albertjihyun/Busan-IDEC/docs/design-overview.md

# 설계 개요 (제출용 초안)

> 팀 문서. 설계결과물 설명서의 2번 항목에 해당한다. 2.4 시스템 구성은 하드웨어 담당이 채운다.

## 2.1 설계 배경

### 2.1.1 화물차 졸음운전은 오래된 문제다

졸음은 도로 위 최대 사망 원인이다. 한국도로공사 통계에 따르면 2019~2023년 고속도로 교통사고 사망자의 71%가 졸음·주시태만에 기인하며, 2026년 상반기 관련 사망자는 전년 대비 90% 증가하였다[1]. 미국 GHSA의 2025년 분석은 졸음운전 관련 실제 사망자가 공식 통계의 약 10배로 추정된다고 보고하였는데[2], 피로는 음주·약물과 달리 사후 검사로 확인되지 않기 때문이다. 사후 규명이 불가능한 위험에 대한 대응은 실시간 감지뿐이다.

이 위험이 집중되는 집단은 화물차 운전자다. 화물차의 졸음·주시태만 사망자는 전체 고속도로 사망자의 82%에 이르며[3], 화물차 사망사고는 100km 이상 장거리 운행 중(65%)과 심야 시간대(43%)에 집중된다[4]. 운행 실태가 이를 설명한다. 화물차 운전자의 일평균 근로시간은 12.8시간이고[5], 설문 응답자의 54.5%가 하루 12시간 이상 운전하며[6], 법정 최소 휴게시간 미준수율은 52.3%에 달한다[7]. 국내에는 운전시간 총량과 일일 최소 휴식을 강제하는 제도가 없으며, 연속운전 2시간 후 15분 휴게가 유일한 시간 규제다[7]. 여기에 운전자 평균 연령 56.4세, 50대 이상 62.2%라는 고령화와 신규 유입 정체[8], 15년 이상 노후 차량 75만 대라는 차량 고령화가 겹친다[9]. 졸음이 발생하는 조건이 이 집단의 일상이며, 제도는 그것을 막지 못한다.

### 2.1.2 자율주행이 화물 운송에 들어왔다

장거리 화물운송 구간의 98%는 고속도로로[10], 반복 노선과 정속 주행이라는 특성상 자율주행 기술이 가장 먼저 적용되는 영역이다. 해외에서는 무인 화물운송이 상용화 단계에 진입하였고[11], 국내에서도 2026년 트레일러 자율주행 유상운송이 개시되었으며 장거리 트럭 운전자를 대상으로 한 구독형 레벨 2 주행보조 서비스가 출시되었다[12][13]. 정부는 2027년 레벨 4 상용화 로드맵을 가동 중이다[14]. 운전자 부족과 고령화가 심화되는 상황에서 업계와 연구자들은 자율주행을 대안으로 거론한다[11].

### 2.1.3 그러나 해결이 아니라 악화다

레벨 3는 보험·책임·개입 기준 제도가 미비하여, 완전 무인화 목표 시점(2028)까지 상당 기간 운전자가 감독 의무를 지는 레벨 2로 보급된다[13]. 노후 차량 비중이 높아 신차 교체보다 기존 차량 후장착이 현실적 경로이므로[9], 오늘의 운전자가 오늘의 트럭에서 레벨 2와 함께 운전하는 기간이 길게 이어진다.

이 구간이 위험하다는 점을 실주행 연구가 시사한다. IIHS와 MIT AgeLab의 관찰 연구는 부분 자율주행 사용 중 운전자의 비운전 행동이 유의미하게 증가함을 확인하였고[15], 2026년 3월 NHTSA가 약 320만 대를 대상으로 격상한 조사에서는 시스템이 충돌 직전에야 제어권을 반환한 사례들이 드러났다[16]. 차가 대신 달릴수록 운전자는 감독자에서 승객이 되며, 제어권 반환 순간의 각성 여부가 사고를 가른다. 원래 가장 졸음에 취약했던 집단이 감독만 하는 자리에 앉게 되는 것이다.

동시에 기존 감시 방식의 한 축이 무력화된다. 조향 패턴 기반 졸음 감지는 EU 규정이 허용하는 간접 수단이나[17], 자율주행 보조 중에는 운전자가 조향을 하지 않아 원리적으로 작동하지 않는다. 자율주행은 졸음을 해소한 것이 아니라, 졸음을 유발하는 조건을 더하면서 감시 수단 하나를 제거하였다.

### 2.1.4 규제는 감시를 요구한다

유럽연합은 일반안전규정(GSR)에 따라 졸음·주의력 경고 시스템(DDAW)을 2024년 7월부터, 첨단 주의분산 경고 시스템(ADDW)을 2026년 7월부터 승용차·트럭·버스를 포함한 모든 신규 판매 차량에 의무화하였다[18]. 이는 차량 통합형 시스템에 대한 형식승인 요건이므로 본 설계와 같은 착용형 장치가 직접 충족하는 대상은 아니나, 규제 당국이 운전자 상태 감시의 필요성을 법으로 확인하였다는 근거다. 국내 정부도 2017년 '사업용 차량 졸음운전 방지대책'을 통해 첨단안전장치 장착 확대를 추진하였고[19], 대형 화물차에 차로이탈경고·비상자동제동 장치를 의무화하였다[20]. 그러나 운전자 상태 감시에 대한 국내 법적 요구는 아직 없다.

### 2.1.5 기존 방식의 빈틈과 생체신호

자율주행 중에도 작동하는 기존 방식은 카메라 기반 DMS이며, 화물차 시장에는 후장착 카메라 제품이 존재한다. 그러나 카메라는 눈꺼풀·시선을 직접 관찰하므로 선글라스, 야간, 역광 조건에서 취약하며, 2026년 7월 시속 100km 주행 중 운전자 수면 사례에서 선글라스로 인해 감지에 실패한 것이 보고되었다[21]. 화물차 사고가 심야에 집중된다는 점(2.1.1)을 고려하면 이 취약성은 타깃 환경과 정면으로 충돌한다. 또한 카메라 방식은 졸음이 눈꺼풀 처짐 등 행동으로 발현된 이후에야 검출한다.

반면 졸음은 자율신경계 변화를 동반하며, 자율신경 활동이 심박변이도(HRV)에 반영된다는 것은 국제 표준 문서로 확립되어 있다[33]. 다만 졸음 상태에서 개별 HRV 지표가 어느 방향으로 변하는지는 연구마다 다르다. 운전 피로 연구 18편을 종합한 문헌고찰은 심박 감소만 일관되게 보고되고 나머지 지표는 증가와 감소가 모두 보고된다고 정리하였으며, 그 원인으로 피로의 종류(졸음의 진행 대 각성 유지 노력)와 기준 측정의 차이를 지목하였다[34]. PPG로 취득한 HRV 특징을 이용한 졸음 감지는 실주행 데이터로 시도되었고[22], 학습 기반 분류기가 단일 임계값 규칙보다 낫다는 보고가 있으나[23], 피험자 4명의 표본 단위 교차검증이라 피험자 독립 평가는 아니었다. 본 설계는 피험자 독립 평가로 이를 재확인한다. 생체신호는 조명·착용물·조향 여부와 무관하며, 행동으로 나타나기 전의 각성도 저하를 관찰 대상으로 한다. 본 설계는 카메라 DMS를 대체하는 것이 아니라, 카메라가 놓치는 조건(야간·선글라스)과 시점(행동 발현 전)을 보완하는 생체신호 채널을 목표로 한다.

## 2.2 설계 목적, 타깃, 범위

**목적.** PPG 생체신호로 졸음에 수반되는 각성도 저하를 감지하고, 센싱 이후의 신호 처리·품질 검증·특징 추출·추론 경로 전체를 범용 프로세서 없이 전용 하드웨어 데이터패스로 구현한 온디바이스 졸음 감지 SoC를 설계·검증한다.

**타깃.** 장거리 사업용 운전 종사자를 관리하는 기업·플랫폼을 대상으로 한다.

- **장거리 간선 화물.** 사고 통계가 가장 크고(2.1.1), 고속도로 연속 주행이라는 운행 조건이 생체신호 측정에 가장 유리하며, 레벨 2 주행보조가 먼저 적용되는 환경이다(2.1.2). 보급 채널은 운수사·화주 직영 차량에 대한 기업 단위 도입과, 지입 개인 차주에 대한 정부 보조다. 사업용 차량 안전장치는 정부 보조와 기관 단위 도입이 표준 경로로, 차로이탈경고장치 설치비 80% 지원[24]과 페달오조작 방지장치 보급[25] 선례가 있다.
판정은 운행 시작 직후의 심박을 개인 기준선으로 삼으므로 **출발 시점에 깨어 있는 운전**을 전제한다. 교대 근무 직후처럼 출발부터 졸린 상태면(야간 근무 뒤 장거리 통근 운전자의 19%[26], 교대 근무 트럭 운전자 첫 야간의 37.8%가 KSS 7 이상[27]) 기준선이 졸음 상태로 잡혀 감지하지 못하며, 이는 방식의 구조적 한계로 명시한다. 새벽배송은 사회적 필요는 크지만 야간 출발이 기본이고 도심 구간의 정차·하차·운반으로 신호 조건도 맞지 않아 대상에서 제외하였다.

기관 단위 대량 보급을 전제하므로 초저전력·저단가·상시 독립 동작이 선호 사항이 아닌 도입 조건이 되며, 이것이 본 설계의 요구사항을 규정한다.

**범위.** 구현 범위는 FPGA(Artix-7) 상의 기능·성능 검증까지이며, 회로 및 모델 구조는 ASIC 수준의 자원 제약(곱셈기·온칩 메모리 최소화)을 설계 기준으로 삼아 향후 이식 가능한 형태를 지향한다. 아날로그 프론트엔드, ADC, IMU, 무선 통신 모듈, 배터리 구동부를 포함한 착용형 보드를 자체 설계하였으며, 학습은 오프라인에서 수행하고 칩에는 추론 경로만 탑재한다. 측정 위치는 손목 대비 말초 혈관 수축과 팔 움직임의 영향이 적은 이마로 선정하고 헤어밴드 형태로 설계하였다. PCB 제작과 착용 실측은 본 제출 범위 밖이다. 장시간 착용성은 후속 과제이며, 모자·헬멧 내장 형태로의 확장을 전제한다.

## 2.3 설계 기준과 후보 비교

### 2.3.1 설계 기준 도출

2.1의 문제 정의와 2.2의 타깃 설정으로부터 다음 여섯 가지 요구사항을 도출하였다. 각 기준은 배경 절의 특정 발견에 대응한다.

| 기준 | 내용 | 도출 근거 |
|---|---|---|
| ① | 조명·착용물(선글라스)에 무관하게 작동 | 화물차 사고의 심야 집중(2.1.1), 카메라의 야간·선글라스 취약성(2.1.5) |
| ② | 자율주행 보조 중에도 작동 | 조향 기반 감시의 무력화(2.1.3), 레벨 2 후장착 보급 경로(2.1.3) |
| ③ | 행동으로 나타나기 전 각성도 저하의 감지 가능성 | 제어권 반환은 수 초 단위이며 충돌 직전 경고 사례(2.1.3) |
| ④ | 상시 구동 가능한 초저전력 | 기관 단위 대량 보급 시 충전 관리 부담(2.2) |
| ⑤ | 외부 통신 없이 독립 동작 | 장거리 노선의 통신 음영, 안전 기능의 외부 의존 불가(2.2) |
| ⑥ | 낮은 단가 | 정부 보조·기관 단위 보급 조건(2.2) |

### 2.3.2 후보 비교

**결정 1 — 감지 수단**

| 후보 | ① 조명 | ② 자율주행 중 | ③ 전조 | ④ 저전력 | ⑤ 독립 | ⑥ 단가 | 판정 |
|---|---|---|---|---|---|---|---|
| 카메라 | ✗ | ○ | ✗ (행동 발현 후) | △ | ○ | △ | ① 탈락 |
| 조향 패턴 | ○ | ✗ | ✗ (행동 발현 후) | ○ | ○ | ○ | ② 원리적 탈락 |
| EEG | ○ | ○ | ○ | ✗ | ○ | ✗ | ④⑥ 탈락 |
| ECG | ○ | ○ | ○ | ○ | ○ | △ | 전극 부착, 실용성 불리 |
| **PPG** | ○ | ○ | ○ | ○ | ○ | ○ | **채택** — 약점: 접촉 품질 |

**결정 2 — 판단 방식**

| 후보 | 판별력 | 하드웨어 비용 | 데이터 요구 | 판정 |
|---|---|---|---|---|
| 규칙 기반 단일 임계값 (원시 심박 특징에 고정 문턱) | 사람마다 평소 심박 간격이 최대 1.8배 달라 공통 문턱이 서지 않음[34]. 개인 기준선으로 나눈 비율에는 문턱이 유효하며, 그것이 아래 경량 ML의 최종 형태 | 최소 | 없음 | 원시 특징 문턱은 탈락 |
| **경량 ML (결정트리·선형 모델)** | 개인차를 개인 기준선 정규화와 학습으로 흡수. 선행 연구 정확도는 44~100%로 편차가 크고 피험자 독립 평가에서 낮아지므로[34] 본 설계는 50명 피험자 독립 평가로 검증. 결과: 기준선 대비 평균 RR 비율 하나에 문턱 하나를 두는 로지스틱 회귀가 최선이었고, 특징을 늘리거나 트리 앙상블(45 KB)로 키우면 새 피험자에서 오히려 낮아졌다 | 판정마다 곱셈 2회·비교 1회, 나눗셈 없음, 파라미터 1개(11비트) | 공개 데이터셋으로 충족 | **채택** |
| 딥러닝 (CNN/LSTM) | 상한 높음 | 곱셈기·온칩 메모리 예산 초과 → ④ 충돌 | 대규모, 공개 데이터 부족 | ④ 탈락 |

**결정 3 — 실행 플랫폼**

| 후보 | ④ 전력 | ⑤ 독립 | ⑥ 단가 | 지연 특성 | 판정 |
|---|---|---|---|---|---|
| 스마트폰·클라우드 연동 | △ | ✗ | ○ | 비결정적 | ⑤ 탈락 |
| 범용 MCU 소프트웨어 | △ | ○ | △ | 비결정적 | 유일한 실질 경쟁자 — 비교 대상 |
| **전용 하드웨어 데이터패스** | ○ | ○ | ○ (양산 시) | 결정적 | **채택** |

### 2.3.3 결정에 따른 트레이드오프와 보완

**PPG 채택의 대가 — 접촉 품질과 모션 노이즈.** 카메라와 달리 신체 접촉이 필요하고, 움직임에 취약하며, HRV는 개인차가 있다[34].
- 측정 위치를 손목이 아닌 이마로 선정: 말초 혈관 수축과 팔 움직임(조향)의 영향이 적다. 반사형 이마 측정은 DC 광전류가 커지므로 TIA를 상방 스윙 구조(캐소드→반전입력, 기준 1V)로 설계하여 약 7µA까지의 선형 구간을 확보하였다.
- 신호 품질 검증(SQI) 단계를 데이터패스에 내장: 진폭 범위와 RR 간격의 생리학적 타당성을 검사하여 불량 구간은 판단을 보류한다.
- IMU를 병행: 고개 떨굼은 심박과 무관하게 즉시 경보한다. 자이로로 꾸벅(빠른 하강·복귀, 25° 이상)을, 가속도 중력 투영으로 숙인 채 있는 자세(35° 이상 0.5초, 세로축 조건으로 급제동과 구별)를 각각 잡아 합친다[28][29][30]. 머리 움직임이 큰 구간은 SQI의 모션 게이트가 박동 단위로 걸러낸다(IMU 별도 보류는 PPG-DaLiA 15명 분석에서 이득이 작아 두지 않음).
- 개인차 보정: 좋은 1분 창 3개로 개인 기준선을 만들고, 기준선 대비 평균 RR 비율(`mean_rb`) 하나로 판정한다. 문헌고찰이 개인화를 정확도의 핵심 요소로 지목하였다[34].
- 노이즈를 완전히 제거한다고 주장하지 않는다. 대역 제한 필터, SQI, 잔여 변동에 대한 모델 강건성 검증의 3단으로 대응하며, 판단 보류에 따른 커버리지를 성능과 함께 보고한다.
- 착용성(장시간 헤어밴드)은 후속 과제로 남기고, 모자·헬멧 내장 형태로의 확장을 전제한다.

**경량 ML 채택의 대가 — 정확도 상한.** 딥러닝 대비 표현력이 제한된다.
- HRV 특징 설계로 보완: 국제 표준[33]에 정의된 시간영역 지표 전체를 후보로 두고, 30초 창에서 계산이 성립하는지, ECG와 PPG 양쪽에 존재하는지, 240 SPS 시간 분해능에서 오차가 허용 범위인지[35][36]의 세 조건으로 걸러 후보를 확정한 뒤, 최종 선택은 데이터로 한다. 표준 문서와 샘플링 연구가 통계적 성질을 이유로 비권장한 pNN50은 제외한다[33][35]. 선행 연구가 개별 지표의 변화 방향에 합의하지 못했으므로[34] 특정 지표를 미리 선택하지 않는다.
- 하드웨어 예산(트리 노드 수·곱셈기 수)을 학습 단계의 제약조건으로 처음부터 걸어, 학습 후 하드웨어에 맞추는 것이 아니라 하드웨어에 맞는 모델을 학습한다.
- 학습 데이터가 ECG 기반이라는 간극은 흉골 ECG와 이마 PPG를 동시 기록한 데이터셋(WildPPG[37], 15명)으로 검증하였다. 같은 사람, 같은 시각의 60초 창 `mean_rb`를 두 신호에서 따로 내어 비교한 결과, 창 품질 규칙(박동의 75% 이상을 살린 창만 판정)과 기준선 규칙(좋은 1분 창 3개로 기준선 구성)을 넣으면 차이 중앙값 −0.1%, 표준편차 1.7%, 판정 일치 97.4%였다. 표준편차 1.7%는 각성 중 사람 안 흔들림 4.0%보다 작다. 운전 중 움직임이 신호 품질에 주는 영향은 손목 PPG와 가슴 ECG를 운전 중 동시 기록한 데이터셋[32]으로 확인하였다.

**전용 하드웨어 채택의 대가 — 유연성 상실과 개발 난이도.** 알고리즘 수정이 소프트웨어만큼 자유롭지 않고, 구현 단계가 늘어난다.
- FPGA 단계에서 알고리즘을 충분히 검증한 뒤 고정하는 표준 개발 순서를 따른다.
- 학습은 오프라인에서 수행하고 칩에는 추론 경로만 탑재하여, 칩의 로직을 단순하게 유지한다.
- "왜 전용 하드웨어인가"는 주장이 아니라 동일 모델의 MCU 구현 대비 판단 1회당 에너지·지연시간 비교로 답한다. 본 제출에서는 FPGA 합성 리포트의 전력·지연 추정치와 MCU 데이터시트 기반 계산으로 비교하고, 실측은 후속 과제다.
- 무선 통신은 BLE 스택 전용 펌웨어가 고정된 SMD 모듈을 채택하여, 범용 프로세서를 두지 않으면서 물리 계층 변환만 위임한다.

**저전력 동작 구조.** ④를 위해 판정을 칩 안에서 끝내고 밖으로는 결과만 내보낸다. 광원·센서·심박 검출은 상시, 특징 추출과 추론은 5초 주기로 동작하며, 무선으로는 경보가 날 때만 1바이트를 보낸다. 졸림 판정이 이어지는 동안에는 30초마다 다시 보낸다. 판정 하나가 최근 60초를 보므로 5초마다 연달아 나온 판정은 대부분 같은 데이터이고, 규정은 첫 경고를 가능한 한 빨리 내고 운전자가 확인할 때까지 반복·강화할 수 있게 한다[38]. 반복이 잦으면 경고에 둔감해지므로[39] 첫 경고는 늦추지 않되 반복 간격을 창의 절반인 30초로 둔다. 파형을 스마트폰으로 계속 보내 폰에서 판단하는 구조와 비교하면 무선 송신량이 경보 한 번에 1바이트로 줄고, 판단을 맡는 회로는 곱셈기 3개 규모의 고정 로직이다. 무선 모듈은 상시 연결 상태로 두며, 이 상태의 모듈 전류는 약 1 mA로 광원(정격 약 5.6 mA)보다 작다. 모듈을 경보 때만 깨우는 방식은 연결 상태 확인 신호가 필요해 후속 과제로 둔다.

## 2.4 시스템 구성 개요

*(하드웨어 담당 작성. 제출 전 이 안내와 아래 항목 표시는 삭제. 분량 반~한 페이지, 상세 회로는 3번 항목으로.)*

**[블록 다이어그램]** — 회로도가 아닌 블록 수준 그림. 센서 → AFE → ADC → FPGA 내부(FIR → SQI → 피크/RR → 60초 창 합 → 기준선·판정 → 자세·끄덕임 결합) → UART → BLE → 스마트폰. IMU는 I2C로 FPGA에 병렬 입력.

```
PPG 센서 → AFE → ADC ─┐ I2C
IMU ──────────────────┘
        ↓
[FPGA] FIR → SQI → 피크/RR → 60초 창 합 → 기준선·판정 ─┐
       IMU 자세·끄덕임 ───────────────────────────────┴→ 경보 결합 → UART
        ↓
BLE 모듈(경보 시 1바이트) → 스마트폰
```

**[블록별 한 줄 설명]**
- 광학부 (LED + 포토다이오드):
- 아날로그 프론트엔드 (TIA + 2단 증폭 + 필터):
- ADC:
- IMU:
- FPGA 데이터패스:
- BLE 모듈:
- 전원부:

**[주요 부품 및 사양]**
- 포토다이오드 / LED: TEMD6200FX01(녹색 대역) / KT-0805G 녹색, 정격 약 5.6 mA(Vf 빈에 따라 2.27–8.93 mA, 3.3 V, 직렬 75 Ω)
- 증폭기: OPA2333 (TIA 330k + 이득 21, AC 결합 0.16Hz, 출력 LPF 16Hz, 기준 1V)
- ADC: MCP3421A0, 12비트 / 240 SPS, I2C 0x68. 240 SPS(4.17 ms)는 PPG 기반 HRV 지표에서 오차 1% 미만으로 보고된 범위다[36]
- IMU: ICM-42670-P, I2C 0x69
- BLE: JDY-23, UART 9600 8N1 투명 전송, 공장 기본 설정 사용. PWRC는 풀업으로 High 고정(기본 모드에서 상시 깨어 있음)
- FPGA: Cmod A7-35T (Artix-7), 12 MHz 온보드 클럭
- 배터리·충전·LDO: USB-C(CC 5.1k) → TP4054 100mA → 보호 내장 리튬셀 → ME6211 3.3V

**[인터페이스]**
- I2C 버스 (ADC·IMU 공유, 풀업 4.7k):
- UART (FPGA ↔ BLE):
- 제어선: LED_IN(LED 스위칭), IMU_INT, BLE_WAKE. (BLE 모듈의 STAT·TXD는 미연결. FPGA→BLE 단방향)

**[전원 구조]**
- USB-C 충전 → 배터리 → LDO 3.3V → 보드 전체
- 프로토타입 단계에서 FPGA 모듈은 별도 USB 전원(헤더에 전원 핀 없음, Cmod Pmod VCC와의 충돌 회피). 최종 IC 전원 인터페이스는 본 범위 밖
- 측정 중 LED(정격 약 5.6 mA)는 상시 점등. 델타시그마 ADC가 변환 시간 내내 적분하므로 LED 듀티 제어와 주변광 차감은 이 구성에서 불가능하다. "저전력"은 판정을 칩 안에서 끝내 무선 송신을 경보당 1바이트로 줄이는 구조(2.3 저전력 동작 구조)에 대한 것이며 광원 전력은 고정 부분이다

## 2.5 차별점, 검증, 기대 효과

**차별점.** (1) 조명·착용물·조향 여부와 무관한 생체신호 채널, (2) 행동으로 나타나기 전의 각성도 저하를 관찰 대상으로 하고 실제로 깊어진 구간을 별도 추적하여 조기 감지 가능성을 검증, (3) 센싱 이후 전 경로의 CPU-free 하드웨어 데이터패스, (4) 하드웨어 예산을 학습 제약조건으로 반영한 모델 설계, (5) 칩 안에서 판정을 끝내 무선 송신을 경보당 1바이트로 줄이는 구조.

**검증 방법.** 검증은 세 층으로 나눈다.

*완료한 것.* 아날로그 프론트엔드 회로 설계와 PCB 아트웍, 손가락 부위 브레드보드 측정(82 bpm, 358 mVpp, dicrotic notch 확인). 이때 사용한 포토다이오드는 940 nm 피크 소자로 520 nm 광원에 대한 상대 감도가 약 44%였으므로 실제 설계(녹색 대역 매칭 소자) 대비 감도가 낮은 조건에서의 검증이다.

*본 제출까지 데이터와 시뮬레이션으로 수행하는 것.* 졸음 라벨이 부여된 공개 운전 시뮬레이션 데이터셋(MPD-DF[31], 50명, 의사 판정 30초 단위 라벨)으로 학습하고 피험자 단위 분할(leave-one-subject-out)로 평가한다. 이 데이터의 각성도 저하 구간은 445건, 지속 시간 중앙값 90초다. 판정은 60초 창을 5초마다 갱신하고, 채점은 라벨 단위인 30초마다 한다. 놓침 방지를 우선하므로 주 지표는 구간 단위 민감도이고 시간당 헛경보를 짝으로 보고한다. 정확도는 각성 비율(77%)이 높아 단독으로 쓰지 않는다. 라벨 중 실제로 더 깊은 단계로 진행한 구간을 별도 추적하여 조기 감지 가능성을 검증한다. 학습 데이터가 ECG라는 간극은 흉골 ECG와 이마 PPG를 동시 기록한 데이터셋(WildPPG[37])으로 두 신호의 `mean_rb`를 비교해 확인하고(판정 일치 97.4%), 운전 중 움직임에 따른 신호 품질은 손목 PPG와 가슴 ECG를 동시 기록한 데이터셋(PPG-DaLiA[32])으로 확인하였다. 하드웨어는 판정 블록 RTL이 50명 전체의 5초 블록 입력에서 파이썬 정수 기준 모델과 비트 단위로 일치함을 확인하고(신호처리 블록은 실제 PPG 파형을 재생해 골든 모델과 대조), FPGA 합성·구현 리포트의 자원·타이밍·전력 추정치를 제시한다. "왜 전용 하드웨어인가"는 이 추정치와 동일 모델의 MCU 구현에 대한 데이터시트 기반 계산으로 판단 1회당 에너지와 지연을 비교하여 답한다.

*수행하지 못한 것.* PCB 제작과 이마 부위 실측, 실제 보드 데이터와의 대조, MCU 대비 실측, IMU 규칙의 착용 검증은 본 제출 범위 밖이며 후속 과제로 남긴다. 이마 PPG 비교 데이터(WildPPG)는 운전이 아니라 야외 활동 기록이라, 운전 중 이마에서 판정이 얼마나 남는지는 확인되지 않았다(두 규칙에서 남는 판정 창은 WildPPG 이마 약 38%, PPG-DaLiA 손목 운전 26%). 학습 데이터가 시뮬레이터 주행이라 실도로 조건(졸음에 저항하는 각성 유지 노력)에서의 일반화는 확인되지 않았다[34].

**기대 효과.** 자율주행 보조 중 조향 기반 감시가 무력화되고 카메라 방식이 야간 조건에 취약한 공백을 생체신호 채널로 보완한다. 현재 범위에서는 운전자와 관제 측에 경보를 제공하며, 향후 차량 시스템과 연동 시 제어권 반환 전 운전자 각성 확인 수단으로 확장 가능하다. 야간·장거리 사업용 운전자 대상 저단가 상시 감시 장치의 기관 단위 보급 가능성을 제시한다.

---

## 참고문헌

[1] 조선비즈, "고속도로 교통사고 사망 70% 졸음 탓", 2026.6. https://v.daum.net/v/20260618102616783
[2] GHSA, "Drowsy Driving", 2025. https://www.ghsa.org/state-laws-issues/drowsy-driving
[3] 부산일보, "한국도로공사, AI·빅데이터로 지킨 안전…고속도로 사망자 역대 최저", 2026.3. https://www.busan.com/view/busan/view.php?code=2026033016342758526
[4] 문화일보, "1월 고속도로 운전 시 화물차 사고, 심야시간대 교통사고 각별한 주의 당부", 2026.1. https://www.munhwa.com/article/11558945
[5] 한국교통연구원, 2019 하반기 화물운송시장 동향 (월간노동법률 인용). https://www.worklaw.co.kr/main2022/view/view.asp?bi_pidx=32404
[6] 시사IN, "요일도 밤낮도 없는 화물차 기사의 24시간 365일 노동 [DTG 데이터 탐사보도②]", 2022.11. https://www.sisain.co.kr/news/articleView.html?idxno=48966
[7] 대한교통학회지, "우리나라 사업용 화물차 운전자의 최소 휴게시간 준수와 위험운전행동", 2026. https://www.jkst.or.kr/articles/pdf/BqBe/kst-2026-044-02-10.pdf
[8] 상용차신문, "화물운송시장 '청년' 운전자가 안보인다…신규 진입자 평균 48세", 2026.2. https://www.cvinfo.com/news/articleView.html?idxno=30631
[9] 상용차매거진, "화물운송시장 '이중 고령화' 운전자도 늙고 차량도 늙는다", 2026.8. https://www.cvinfo.com/news/articleView.html?idxno=31576
[10] 베타뉴스, "마스오토, 국내 트레일러 자율주행 시작", 2026.7. https://www.betanews.net/article/view/beta202607010036
[11] 이데일리, "트럭운전자 고령화·구인난 해법…초기투자 지원·제도정비 서둘러야", 2026.7. https://edaily.co.kr/News/Read?mediaCodeNo=257&newsId=01820406645519768
[12] 이데일리, "마스오토, 국내 최초 트레일러 자율주행…2028년 한·미 화물운송 완전 무인화", 2026.7. https://edaily.co.kr/News/Read?mediaCodeNo=257&newsId=04027846645510256
[13] 아시아투데이, "박일수 마스오토 대표 '2028년 장거리 화물운송 완전 무인화 달성'", 2026.7. https://www.asiatoday.co.kr/kn/view.php?key=20260701010000579 / 테크42 동일 간담회 보도(레벨2 출시 이유). https://www.tech42.co.kr/
[14] 정책브리핑, "2027년 레벨4 완전자율주행 상용화…AI 모빌리티 혁신 로드맵 가동", 2026.3. https://www.korea.kr/news/policyNewsView.do?newsId=148960802
[15] IIHS·MIT AgeLab 연구 보도, 2024.9. https://www.malaymail.com/news/tech-gadgets/2024/09/18/the-automation-dilemma-are-drivers-checking-phones-while-on-autopilot/150792
[16] Electrek, "NHTSA upgrades Tesla FSD investigation to engineering analysis (3.2M vehicles)", 2026.3. https://electrek.co/2026/03/19/nhtsa-upgrades-tesla-fsd-visibility-investigation-3-2-million-vehicles/
[17] InterRegs, "EU regulation on driver drowsiness and attention warning systems". https://www.interregs.com/articles/spotlight/233/eu-regulation-on-driver-drowsiness-and-attention-warning-systems-published
[18] Smart Eye, "What to know about DDAW and ADDW systems". https://smarteye.se/blog/what-to-know-about-ddaw-and-addw-systems/
[19] 로컬세계, "국토부, 사업용 차량 졸음운전 방지대책", 2017.7. https://localsegye.co.kr/news/view/1065592300623588
[20] 해사신문, "국토부, 대형 화물차 첨단안전장치 장착 의무화", 2016.4. http://www.haesanews.com/news/articleView.html?idxno=73724
[21] Electrek, "Tesla driver asleep at 100 km/h exposes monitoring gap", 2026.7. https://electrek.co/2026/07/06/tesla-driver-asleep-monitoring-gap/
[22] Z. AlArnaout, C. Zaki, Y. Kotb, M. AlAkkoumi, N. Mostafa, "Exploiting heart rate variability for driver drowsiness detection using wearable sensors and machine learning", Scientific Reports 15, 2025. https://www.nature.com/articles/s41598-025-08582-2
[23] G. Li, W.-Y. Chung, "Detection of driver drowsiness using wavelet analysis of heart rate variability and a support vector machine classifier", Sensors 13(12):16494-16511, 2013. https://pmc.ncbi.nlm.nih.gov/articles/PMC3892817/
[24] 서울시, "졸음운전 예방 차로이탈경고장치 설치비 80% 지원", 2020.3. https://news.seoul.go.kr/traffic/archives/503010
[25] 정책브리핑, "페달 오조작 방지장치 보급 시작 — 택시·화물차 우선", 2026.2. https://www.korea.kr/news/policyNewsView.do?newsId=148959338
[26] "Sleepiness, Long Distance Commuting and Night Work as Predictors of Driving Performance". https://www.ncbi.nlm.nih.gov/pmc/articles/PMC3448712/
[27] "Sleepiness, sleep, and use of sleepiness countermeasures in shift-working long-haul truck drivers". https://pubmed.ncbi.nlm.nih.gov/25957933/
[28] Nurnaningsih et al., "IMU-based drowsiness detection via head movement thresholds (MPU-6050)", 2025. https://journal.uinjkt.ac.id/index.php/ti/article/view/45271
[29] Sensors, "Context-aware EEG headset with head movement for driver drowsiness detection", 2015. https://www.ncbi.nlm.nih.gov/pmc/articles/PMC4570452/
[30] ACM TOSN, "FDWatch: reliable driver drowsiness detection leveraging wearables", 2023. https://pure.bit.edu.cn/en/publications/towards-reliable-driver-drowsiness-detection-leveraging-wearables/
[31] Scientific Data, "A multimodal phenotyping dataset of driving fatigue (MPD-DF)", 2026. https://www.nature.com/articles/s41597-026-06634-4
[32] Reiss et al., "PPG-DaLiA", UCI ML Repository. https://archive.ics.uci.edu/dataset/495/ppg+dalia
[33] Task Force of the European Society of Cardiology and the North American Society of Pacing and Electrophysiology, "Heart rate variability: Standards of measurement, physiological interpretation, and clinical use", Circulation 93(5):1043-1065, 1996. https://doi.org/10.1161/01.CIR.93.5.1043
[34] K. Lu, A. Sjörs Dahlman, J. Karlsson, S. Candefjord, "Detecting driver fatigue using heart rate variability: A systematic review", Accident Analysis & Prevention 178:106830, 2022. https://doi.org/10.1016/j.aap.2022.106830
[35] L. Hejjel, E. Roth, "What is the adequate sampling interval of the ECG signal for heart rate variability analysis in the time domain?", Physiological Measurement 25(6):1405-1411, 2004. https://doi.org/10.1088/0967-3334/25/6/006
[36] S. Béres, L. Hejjel, "The minimal sampling frequency of the photoplethysmogram for accurate pulse rate variability parameters in healthy volunteers", Biomedical Signal Processing and Control 68:102589, 2021. https://doi.org/10.1016/j.bspc.2021.102589
[37] M. Meier, B. U. Demirel, C. Holz, "WildPPG: A Real-World PPG Dataset of Long Continuous Recordings", Advances in Neural Information Processing Systems 37 (NeurIPS 2024) Datasets and Benchmarks Track. https://arxiv.org/abs/2412.17540

[38] European Commission, Commission Delegated Regulation (EU) 2021/1341 of 23 April 2021 (driver drowsiness and attention warning systems), Official Journal of the European Union L 292, 2021. https://eur-lex.europa.eu/legal-content/EN/TXT/?uri=CELEX:32021R1341
[39] D. C. Marshall, J. D. Lee, P. A. Austria, "Alerts for in-vehicle information systems: annoyance, urgency, and appropriateness", Human Factors 49(1):145-157, 2007. https://doi.org/10.1518/001872007779598145
