albertjihyun/Busan-IDEC/docs/interface-spec.md

# 인터페이스 명세: 신호처리 블록 → 판정 블록 → 통신 블록

판정 블록이 앞단(신호처리 블록)에서 무엇을 받고, 뒷단(통신 블록)에 무엇을 넘기는지 정한다. 판정식의 유도와 근거는 정수 판정 설계서에, 고개 떨굼 규칙은 IMU 규칙 설계서에 있고, 여기서는 블록 사이 약속만 적는다.

## 1. 전체 경로와 분담

```
광센서 → TIA → MCP3421 (12비트, 240 SPS) ─┐
                                          ├ I2C → [신호처리 블록] ─ 60초 창 합 3개 ─┐
ICM-42670-P (가속도·자이로, 100 Hz) ──────┘         필터·봉우리·SQI·누산   IMU 원시값·끄덕임 ─┤
                                                                                        ▼
                                                              [판정 블록] 기준선·판정·IMU 결합
                                                                                        │ alert 펄스
                                                                                        ▼
                                                              [통신 블록] UART 9600 8N1 → JDY-23 BLE → 휴대폰
```

| 블록 | 하는 일 | 담당 |
|---|---|---|
| 신호처리 블록 (`ppg_soc_top`) | I2C 마스터, FIR 필터, 봉우리 검출, SQI, RR 추출, 5초 블록 누산과 60초 창 합, IMU 읽기와 자이로 끄덕임 검출 | 하드웨어 팀 |
| 판정 블록 (`infer_top`) | 개인 기준선, 각성도 저하 판정, 고개 떨굼 규칙, 경보 결합 | ML 파트 |
| 통신 블록 (`uart_tx_ble`) | 경보 펄스마다 1바이트 UART 송신, BLE 모듈 제어 | 통신 담당 |

클럭은 12 MHz(Cmod A7-35T), 리셋은 액티브 로우. 단위는 전부 샘플 수(240 SPS, 1샘플 = 4.1667 ms)이고 칩 안에서 밀리초로 바꾸지 않는다.

## 2. 판정 블록 모듈 구성

| 모듈 | 하는 일 |
|---|---|
| `classifier` | 좋은 창 판정, 기준선 누산, `mean_rb ≥ T`를 교차 곱셈으로 비교. 5초마다 `hold`·`drowsy` |
| `imu_rule` | 가속도 앞축·세로축 저역 필터 → 35° 넘게 0.5 s 숙이면 펄스, 숙인 채 있으면 5 s마다 반복 |
| `infer_top` | 위 둘을 감싸고, 판정·자세 규칙·자이로 끄덕임을 OR 해 `alert` 펄스 하나로 낸다 |

## 3. 받는 신호

### 3.1 심박 재료 (60초 창 합)

| 신호 (신호처리 블록 출력) | 판정 블록 입력 | 폭 | 뜻 |
|---|---|---|---|
| `o_win_valid` | `i_win_valid` | 1 | 5초마다 1클럭 펄스. 아래 셋이 이 클럭에 갱신된다 |
| `o_n60` | `i_n60` | 8 unsigned | 최근 60초 창의 SQI 통과 박동 수. 최대 200 |
| `o_sum_rr60` | `i_sum_rr60` | 17 unsigned | 같은 창의 RR 합(샘플 수). 통과 RR은 서로 겹치지 않는 구간이라 창 길이로 묶인다: 최대 60 s × 240 + 360 = 14,760 |
| `o_bad60` | `i_bad60` | 8 unsigned | 같은 창의 SQI 탈락 박동 수. 255에서 포화 |

세 값은 `o_win_valid` 클럭에 유효하기만 하면 되고, 그 뒤에 바뀌어도 상관없다.

`o_bad60`은 탈락 박동에 불응기 말고는 상한이 없어 60초 창에서 300까지 갈 수 있다. 그래서 신호처리 블록 안에서는 12비트로 세고 출력만 255로 묶는다. 판정에서 255는 `3 × 255 > n60`이 되어 항상 나쁜 창으로 처리되므로 포화 방향이 판정과 맞는다.

**재료가 셋인 이유.** 사람을 분리한 교차검증에서 새 사람에게 통하는 특징은 `mean_rb`(창 평균 RR ÷ 기준선 평균 RR) 하나였고, 여기에는 N과 ΣRR만 들어간다. 여기에 이마 PPG의 창 품질을 거르는 탈락 박동 수를 더했다. 신호처리 블록에는 이 셋에 필요한 누산기만 두고 30초 창 출력은 두지 않는다.

**창을 버퍼 없이 만드는 방법.** RR 값을 저장하지 않는다. 1,200샘플(5초)마다 누산기 한 벌을 닫아 최근 12벌을 시프트 레지스터에 보관하고, 12벌을 더해 60초 창을 만든다. 판정 갱신이 5초라 창 경계가 사건과 어긋나는 문제가 없고 BRAM이 필요 없다.

### 3.2 IMU

| 신호 (신호처리 블록 출력) | 판정 블록 입력 | 폭 | 쓰임 |
|---|---|---|---|
| `o_accel_x/y/z` | `i_accel_x/y/z` | 16 signed × 3 | 자세 규칙 입력(±2 g, 1 g = 16384) |
| `o_imu_valid` | `i_imu_valid` | 1 | 100 Hz 갱신 펄스 |
| `o_nod_event` | `i_nod_event` | 1 (1클럭 펄스) | 자이로 끄덕임(25°). 부호 확정 뒤에만 `alert`에 OR |
| `o_nod_sustained` | `i_nod_sustained` | 1 (상태) | 떨군 채 유지. 부호 확정 뒤, 상승 에지에서 한 번만 `alert` |
| `o_pitch_sign_ok` | `i_pitch_sign_ok` | 1 (상태) | 자이로 부호 확정됨. 0이면 위 두 신호를 무시한다 |

자이로 축의 부호는 헤드밴드를 좌우 어느 쪽으로 썼는지에 따라 뒤집히므로, 신호처리 블록은 착용 뒤 고개 움직임에서 부호를 스스로 알아내고 확정되면 `o_pitch_sign_ok`를 올린다. 확정 전에는 +1로 가정하고 돌기 때문에 반대로 쓴 경우 꾸벅임을 놓치거나 고개를 든 자세에서 `o_nod_sustained`가 설 수 있다. 그래서 판정 블록은 확정 전의 자이로 결과 둘을 무시한다. 그 구간(보통 고개를 두세 번 움직일 때까지)에는 가속도 자세 규칙과 심박 판정만 돈다. 가속도 자세 규칙은 앞축 부호가 센서 패키지 방향으로 정해져 착용 방향의 영향을 받지 않는다.

## 4. 판정 규칙

```
좋은 창:   n60 ≥ 30  그리고  3 × bad60 ≤ n60              (살린 박동 75% 이상)
기준선:    12·24·36·…번째 블록(서로 안 겹치는 1분 창)마다 그 창이 좋으면
             N_base += n60,  ΣRR_base += sum_rr60
           좋은 창 3개가 모이면 R = T_FIX × ΣRR_base (곱셈 1회), 준비 완료
           나쁜 창은 건너뛰고 다음 1분 창을 기다린다 (최소 3분, 재시작 없음)
매 5초:    hold   = 기준선 준비 전(완성되는 블록 포함) 또는 좋은 창 아님
           drowsy = hold 아님 그리고 (sum_rr60 × N_base) << 10 ≥ R × n60
```

T = T_FIX / 1024 = 1086 / 1024 = 1.0605. 평소보다 RR이 약 6% 길어지면 졸림으로 본다(헛경보 시간당 4회 동작점). `mean_rb ≥ T`의 양변에 `n60 × N_base × 1024`를 곱한 식이라 나눗셈이 없고, 근사는 T를 1/1024 단위로 반올림한 것 하나뿐이다. `3 × bad60`은 시프트와 덧셈이다. 이력(hysteresis)이나 연속 N회 규칙은 없고 5초 판정을 그대로 쓴다.

`classifier` 파라미터:

| 파라미터 | 값 | 뜻 |
|---|---|---|
| `T_FIX` | 1086 | 문턱 T × 1024 |
| `FRAC` | 10 | T의 소수 비트 |
| `WIN_BLOCKS` | 12 | 60초 창 = 5초 블록 12개 |
| `BASE_WINS` | 3 | 기준선 = 좋은 1분 창 3개 |
| `MIN_N60` | 30 | 좋은 창의 최소 박동 수 |
| `KEEP_K` | 3 | 좋은 창의 탈락 기준. 3 = 살린 비율 75%, 2 = 67%, 1 = 50%, 0 = 탈락 수 안 봄. 보드 실측 후 조정 |

비트 폭은 판정식이 넘치지 않도록 N_base 10, ΣRR_base 16, T_FIX 11, 좌변 37, 우변 35비트로 둔다.

## 5. 경보 출력

| 신호 | 폭 | 모양 | 뜻 |
|---|---|---|---|
| `alert` | 1 | 1클럭 펄스 | 경보. 졸림 판정(첫 판정에서 즉시, 이어지면 30초마다) 또는 고개 떨굼(즉시) |
| `ready` | 1 | 상태 | 기준선 확정됨. 보드 LED 같은 상태 표시용이고 쓰지 않아도 된다 |

```
alert = (판정 갱신 클럭 AND drowsy AND NOT hold AND 마지막 심박 경보로부터 블록 6개 이상)
      | 자세 규칙 펄스
      | o_pitch_sign_ok AND (o_nod_event | rise(o_nod_sustained))
```

**심박 경보 간격.** 판정 하나가 최근 60초를 보므로 5초마다 연달아 나온 판정은 60초 중 55초가 같은 데이터다. 그래서 심박 경보는 첫 졸림 판정에서 바로 내고, 그 뒤 30초(블록 6개, 창의 절반) 동안은 졸림 판정이 나와도 내지 않는다. 30초가 지나면 판정 창의 절반이 새 데이터다. 졸림이 이어지면 30초마다 다시 울리고, 판정이 중간에 끊겼다 다시 와도 마지막 경보 시각만 본다. 판정(`hold`·`drowsy`)과 그 지표(사건 민감도·헛경보)는 바뀌지 않고 휴대폰이 받는 경보 수만 줄어든다. MPD-DF 50명에서 깨어 있을 때 시간당 139회 → 26회, 피로1 이상일 때 246회 → 45회다. 이 숫자는 휴대폰이 받는 바이트 수다. 판정 지표의 헛경보(3.94회/h)는 60초 안에 이어진 경보를 한 덩어리로 센 것이라 서로 다르다. 경보 가운데 실제로 피로1 이상일 때 난 비율은 간격을 넣기 전과 같이 34%다(간격은 같은 증거로 여러 번 울리는 것을 줄일 뿐 판정 정확도를 바꾸지 않는다). 떨굼 경보는 간격 없이 즉시 울리고 심박 쪽 간격에 영향을 주지 않는다. 간격은 `infer_top`의 파라미터 `REPEAT_BLOCKS`(기본 6)다.

출력을 상태가 아니라 펄스로 둔 이유는 통신 블록이 "1이면 보내고 0이면 안 보낸다"만 하면 되게 하기 위해서다. 상태로 내면 졸림이 이어지는 5초 내내 1이라 계속 보내게 된다. 대신 휴대폰은 경보의 원인(심박인지 떨굼인지)과 조용한 이유(정상인지 기준선 준비 중인지)를 모른다. 이 정보는 휴대폰으로 보내지 않는다.

보류(기준선 준비 전, 박동 30개 미만, 탈락 25% 초과)는 블록 안에서 삼켜진다. 떨굼은 심박이 아니라 IMU가 직접 본 것이라 보류와 무관하게 울린다. 자세 규칙과 자이로 끄덕임은 역할이 나뉜다. 자이로 쪽은 빨리 떨어졌다 돌아오는 꾸벅임을 잡고 급제동에 속지 않으며, 자세 규칙은 천천히 처져서 그대로 있는 경우와 5 s 반복을 맡는다. 움직임이 많을 때 판정을 보류하는 규칙은 넣지 않았다. 신호처리 블록의 SQI 모션 게이트가 이미 그 일을 한다.

**타이밍.** `i_win_valid` 클럭에 입력을 잡아 기준선을 갱신하고, 다음 클럭에 곱셈, 그다음 클럭에 비교해 판정이 나온다(`i_win_valid`로부터 3클럭). `alert`는 그다음 클럭에 뜬다. 블록 간격이 6만 클럭이라 여유가 충분하다. 기준선 준비 전 첫 3분 동안은 심박 경보가 나오지 않는 것이 정상이다(떨굼 경보는 나올 수 있다).

## 6. 통신 블록이 할 일

| 항목 | 동작 |
|---|---|
| 송신 | `alert` 펄스를 받으면 다음 클럭에 `0x01` 한 바이트를 9600 bps 8N1로 보낸다. 펄스가 없으면 아무것도 보내지 않는다 |
| 겹침 | 송신 중(약 1.04 ms)에 온 펄스는 `pending` 플래그에 기억했다가 끝나면 하나 더 보낸다. 플래그를 꺼내는 클럭에 새 펄스가 겹쳐도 다시 기억한다. 한 프레임 안에 펄스가 셋 이상 오면 둘로 합쳐지지만, 경보는 5초 판정과 떨굼이라 그렇게 몰리지 않는다 |
| BLE_WAKE (PWRC) | 항상 High. JDY-23의 PWRC는 active-low이고, 공장 기본 설정(`AT+STARTEN1`)에서는 전원이 들어오면 깨어 있으며 `AT+SLEEP` 없이는 잠들지 않는다. 연결 중 PWRC Low는 AT 명령용이다. 회로도의 10k 풀업과 같은 방향이다 |
| 모듈 설정 | 공장 기본(9600 8N1). 납땜 전에 USB-UART로 확인한다 |
| 휴대폰 | 바이트가 오면 소리, 안 오면 조용. 반복 간격은 판정 블록이 정한다(졸림이 이어지면 30초마다 바이트가 다시 온다) |

BLE 모듈은 FPGA → 모듈 단방향이다(모듈 TXD·STAT 미연결). 연결 여부를 알 수 없으므로 경보 때만 깨워 보내는 구조는 이 보드에서 성립하지 않고, 모듈은 상시 연결로 쓴다. 연결 상태 전류가 약 1 mA라 LED(정격 약 5.6 mA) 앞에서 재우는 이득도 작다.

## 7. 검증 결과

| 대상 | 방법 | 결과 |
|---|---|---|
| `classifier`·`infer_top` | 파이썬 정수 기준 모델이 만든 정답과 비트 대조. MPD-DF 50명의 5초 블록 전부(75,186) + 경계 사례 278블록 | 불일치 0. `alert` 펄스 수가 정답(30초 간격 규칙 포함)과 같음 |
| 테스트벤치 자체 | 상수를 일부러 틀림(`T_FIX` 1086 → 1087, `MIN_N60` 30 → 31, `REPEAT_BLOCKS` 6 → 5), 출력을 펄스 대신 상태로 | 각각 불일치로 잡힘 |
| 판정 → 통신 | 50명 판정 벡터를 판정 블록에 넣고 통신 블록 출력을 UART 수신기로 받음 | 경보 3,154개 = 바이트 3,154개(블록별 불일치 0), 전부 0x01, 프레이밍 오류 0 |
| `imu_rule` | 합성 16 시나리오 11,590샘플(정지·진동·급제동 0.5/0.7 g·계기판 20°·꾸벅 0.3 s·떨굼·잠듦·요철·좌우 흔들기·뒤로 젖힘·제동+계기판·천천히 처짐·부호 반대·포화·정확히 35°), PPG-DaLiA 가슴 가속도 15명 35.9 h(파이썬, 그중 1명 921,200샘플은 RTL 대조) | 불일치 0. 가슴 15명 운전 3.8 h에서 자세 규칙 펄스 0회 |
| 통신 블록 | 통신 담당 테스트벤치, 펄스 두 개를 1클럭부터 한 프레임 넘게까지 모든 간격으로, 무작위 펄스 1,000개, 송신 중 리셋 | 14/14 통과, 유실 0, 바이트 1,000개, 리셋 시 즉시 정지·플래그 소거, PWRC Low 0클럭 |

Vivado 2026.1 합성·구현(xc7a35t, out-of-context, 12 MHz):

| 블록 | LUT | FF | DSP | BRAM | WNS |
|---|---|---|---|---|---|
| `infer_top` (판정 + IMU 규칙, 단독) | 305 (1.47%) | 107 | 3 | 0 | 72.3 ns (주기 83.3 ns) |
| `infer_top` (칩 최상위 `system_top`에 통합, 계층 간 최적화 뒤) | 207 | 107 | 3 | 0 | 시스템 전체 WNS 54.8 ns |
| `uart_tx_ble` (Yosys `synth_xilinx` 추정) | 28 | 23 | 0 | 0 | |

DSP 3개는 R 한 번, 좌변, 우변의 곱셈이다. 곱셈기 하나를 공유하면 DSP는 1개로 줄지만 먹스와 순서 제어에 LUT 30~60개가 더 들고 두 클럭 늦어진다. DSP가 남으므로 따로 뒀다.

## 8. 회로도 대조

회로도·넷리스트를 판정 블록의 설계 가정과 대조했다. 맞는 것: 240 SPS, 0 중심 입력(Vin− = 1 V 가상 접지), AC 결합 0.16 Hz·저역 16 Hz(계산값 0.159·15.9 Hz), ICM-42670-P 주소 0x69(AD0 = 3.3 V)·I2C 모드(CS = 3.3 V), ADC와 IMU의 I2C 버스 공유(풀업 4.7k).

| 항목 | 내용 | 상태 |
|---|---|---|
| ADC 분해능 | MCP3421은 240 SPS에서 12비트(±2047 코드). 봉우리 검출은 상대 문턱이라 크기에 거의 무관하다. 50명 심전도를 봉우리 높이 A 코드로 맞춰 정수화해 보니 A = 10에서 놓침 3.5%로 깨지고, A ≥ 50이면 놓침 1.0%·오검출 3.2%로 실수 입력일 때와 같았다. 목표는 봉우리 높이 100~500코드 | PGA 8로 정함 |
| TIA 첫 단 포화 | 첫 단(R1 330k)은 맥박 AC뿐 아니라 반사광 DC 전체를 키운다. 출력 = 1 V ± I_pd × 330k라 위로 약 7 µA, 아래로 약 3 µA가 한계다. LED를 이마에 바짝 대거나 햇빛이 들면 넘을 수 있고, 포화되면 맥박이 통째로 사라진다. 델타시그마 ADC라 LED 점멸로 주변광을 빼는 방법도 쓸 수 없다 | 보드 실측 항목(어두운 곳·실내·창가 DC 측정, 필요하면 R1 낮추기나 차광) |
| IMU 풋프린트 | 심볼은 ICM-42670-P인데 풋프린트 이름이 QMI8658A 라이브러리에서 왔다. 크기(2.5 × 3.0 mm LGA-14)는 같지만 1번 핀 위치와 패드 번호가 같다는 보장이 없다 | 하드웨어 팀 확인 필요 |
| 샘플 시계 | 240 SPS는 MCP3421 내부 발진기가 정한다. FPGA는 RDY 비트를 240 Hz보다 빠르게 폴링해야 샘플을 놓치지 않는다. 발진기 오차만큼 5초 블록이 5초가 아니지만, 판정이 비율(`mean_rb`)이라 상쇄된다 | 설계에 반영 |
| LED | 위 포화 문제와 주변광 차감 불가 때문에 측정 중 상시 점등(정격 약 5.6 mA) | 전력 주장은 "칩 안에서 판정을 끝내 무선은 경보당 1바이트"와 추론 회로 크기로 한다 |
| FPGA 보드 | Cmod A7-35T 전제. 15T면 자원 비율(%)만 바뀐다 | 확인 필요 |
