albertjihyun/Busan-IDEC/docs/imu-rule-design.md

# IMU 결합 규칙 설계서

3축 가속도(ICM-42670-P)로 **고개 떨굼**(즉시 경보)을 잡고, 신호처리 블록의 자이로 끄덕임 검출(`imu_feature`)과 심박 판정 블록(`classifier`)을 `infer_top`에서 합쳐 `alert` 펄스 하나로 낸다. 2~5절은 규칙을 정한 근거, 6절은 확정한 규칙, 7절은 구현, 8절은 검증 결과다.

## 1. 범위와 전제

판정 블록의 IMU 입력은 가속도 3축이다. 자이로는 신호처리 블록이 `imu_feature`에서 쓰고, 판정 블록은 그 결과(`o_nod_event`·`o_nod_sustained`)만 받는다(2.6절).

보드·PCB가 없으므로 착용 데이터가 없다. 임계값은 문헌·물리·센서 사양에서 정하고, 검증은 합성 벡터와 PPG-DaLiA 손목·가슴 가속도(이마 대용, 한계 명시)로 한다.

규칙 골격은 "떨굼이면 즉시 경보, 아니면 심박 판정 결과"다. 움직임이 많을 때 판정을 보류하는 규칙은 두지 않는다(2.5절, 6절).

## 2. 자료 조사 결과

### 2.1 인용 문헌 [28][29][30]의 실상

| 자료 | 내용 | 설계에 쓸 수 있는 것 |
|---|---|---|
| [28] Nurnaningsih 2025 (MPU-6050, 헤드기어) | 연속 샘플 차 `|Δx|>1.0g AND |Δy|>3.5g AND |Δz|>0.5g`면 떨굼. 10회 모의 동작 중 7회 검출 | **임계값은 못 쓴다.** 센서를 ±2 g로 설정했다고 쓰고(레지스터 0x1C=0x00) y축 3.96 g를 보고함 — ±2 g에서는 물리적으로 나올 수 없는 값. "떨굼이 20 ms 안에 끝난다"도 사람 머리 움직임(수백 ms)과 맞지 않음. 비졸음 시험이 없어 헛경보 평가 없음. 환산 분모도 16834(오타, 16384). 쓸 수 있는 건 "연속 샘플 차로 급변을 본다"는 발상과, 착용 위치가 머리라는 점만 |
| [29] Li & Chung 2015, Sensors (EEG 헤드셋 + 자이로) | 2초 구간에서 3축 자이로 평균의 표준편차를 "움직임 파워"로 씀. 각성 74 → 초기 졸음 169(단위 원시값), AUC 0.967 | 떨굼 임계값이 아니라 **움직임 강도**를 봤다. 중요한 사실: **초기 졸음에서 머리 움직임이 늘어난다**(하품·눈 비비기·자세 바꾸기). Vural 인용: 졸릴수록 머리 움직임이 커지고 잠들기 직전에 멈춘다. → 움직임 과다를 "보류"로만 쓰면 초기 졸음 구간을 버리게 될 수 있다는 경고 |
| [30] FDWatch 2022, ACM TOSN (손목 PPG+IMU) | 유료. 초록만: PPG와 모션으로 여러 지표를 뽑아 결합 | 구조적 참고만 |

### 2.2 추가로 찾은 것

| 자료 | 내용 |
|---|---|
| **Ellcie Healthy 특허 US 10,152,869 B2** (2016 우선권, 안경형 졸음 감지 상용품) | 안경 다리 중앙의 가속도계. 머리 세로축의 **중력 투영이 문턱 아래로 내려가면 떨굼**. 신호는 **약 2 Hz 저역 필터**로 흔들림 제거. **0.2초 넘게 지속**한 것만 인정, **0.5~1초 넘는 것**은 따로 셈. 일정 시간 안 떨굼 **횟수**로 판단. 샘플링 50~150 Hz(70 Hz 권장). 문턱 각도 숫자는 특허에 없음 |
| Lytx 특허 US 8,952,819 (2013) | "머리 피치 각으로 끄덕임 감지", "과도하거나 불규칙한 머리 움직임은 피로와 연관" — 정성적 언급만, 카메라 중심 |

Ellcie 특허 구조(중력 투영 + 저역 필터 + 지속시간 + 횟수)가 [28]보다 물리적으로 맞고 상용품 근거가 있어 이것을 출발점으로 삼는다.

### 2.3 ICM-42670-P 사양 (데이터시트 DS-000451)

| 항목 | 값 |
|---|---|
| 가속도 풀스케일 | ±2 / ±4 / ±8 / ±16 g (`ACCEL_UI_FS_SEL` = 11 / 10 / 01 / 00). **리셋 기본값은 ±16 g, 800 Hz** — 신호처리 블록이 레지스터를 설정해야 함 |
| 감도 | ±2 g: 16,384 LSB/g · ±4 g: 8,192 · ±8 g: 4,096 · ±16 g: 2,048. 16비트 signed |
| ODR | 1.6 k / 800 / 400 / 200 / **100** / 50 / 25 / 12.5 Hz … (`ACCEL_ODR`) |
| 내장 저역 필터 | `ACCEL_UI_FILT_BW`: 180 / 72 / 34 / 16 / 8 / **4 Hz** |
| APEX 기울기 감지 | 35° 초과가 0 / 2 / 4 / 6초 지속 시 인터럽트(`TILT_WAIT_TIME_SEL`). 각도는 35° 고정 |
| APEX Wake-on-Motion | 축별 문턱(3.9 mg 단위, 0~1 g)을 연속 샘플 차가 넘으면 인터럽트 |
| 인터럽트 핀 | 회로도에서 `IMU_INT`가 FPGA로 연결돼 있음 |

MPU-6050도 ±2 g에서 16,384 LSB/g라 "단위 환산"은 사실 없다. 문제는 [28]의 숫자 자체다.

### 2.4 PPG-DaLiA 가속도 분포 (15명, 5초 블록 20,688개)

이마 데이터가 없어 손목(Empatica E4, 32 Hz)과 가슴(RespiBAN, 700→100 Hz)을 봤다. 값은 5초 블록 안 `| ‖a‖ − 1 g |`의 최댓값이 문턱을 넘는 블록의 비율이다. 정지 기울기는 크기에 안 잡히므로 순수 "움직임" 척도다.

| 활동 | 시간 | 손목 p95 편차 중앙값 | 손목 >0.2 g | 손목 >0.3 g | 손목 >0.5 g | 가슴 p95 편차 중앙값 | 가슴 >0.1 g | 가슴 >0.2 g | 가슴 >0.3 g | 가슴 >0.5 g |
|---|---|---|---|---|---|---|---|---|---|---|
| 앉기(독서) | 2.5 h | 0.017 g | 8% | 6% | 2% | 0.009 g | 1.5% | 0.9% | 0.8% | 0.6% |
| 업무(컴퓨터) | 4.7 h | 0.028 | 25% | 18% | 9% | 0.021 | 9% | 3.4% | 2.4% | 1.6% |
| **운전** | **3.8 h** | **0.159** | **75%** | **56%** | **35%** | **0.074** | **74%** | **21%** | **5.3%** | **1.7%** |
| 점심 | 7.5 h | 0.077 | 45% | 31% | 15% | 0.034 | 29% | 14% | 10% | 7% |
| 걷기 | 2.6 h | 0.525 | 99% | 98% | 93% | 0.548 | 99% | 98% | 98% | 94% |
| 계단 | 1.8 h | 0.561 | 100% | 100% | 95% | 0.558 | 100% | 99% | 99% | 97% |

읽는 법. 운전 중 손목은 조향 때문에 절반 넘는 블록이 0.3 g를 넘지만, 가슴은 0.3 g를 넘는 블록이 5%, 0.5 g는 1.7%다. 이마는 몸통에 붙어 있어 손목보다 가슴에 가까울 것으로 본다(확인 불가). 사람별 운전 구간 가슴 p95 편차 중앙값은 15명 모두 0.06~0.10 g 안에 있어 개인차가 작다.

### 2.5 PPG-DaLiA로 잰 "움직임 대 PPG 심박 오차"

움직임 보류가 필요한지 보려고, 손목 PPG(64→240 Hz, 0.16~16 Hz)에 학습 검출기의 봉우리 규칙·SQI·5초 누산·정수 판정을 돌리고 가슴 ECG R봉우리(데이터셋 보정본)를 정답으로 삼았다. 60초 창마다 평균 RR 오차 `(PPG−ECG)/ECG`와 판정 뒤집힘(`drowsy` 불일치, 양쪽 판정 가능한 창 중)을 냈다. 기준선은 ECG 것을 PPG에도 공유했다(PPG-DaLiA는 걷는 구간으로 시작해 PPG 기준선이 망가지므로, 기준선 오차와 창 오차를 분리). 15명 창 25,893개다.

먼저 알아 둘 것이 둘 있다. Empatica BVP는 극성이 검출기가 가정한 방향과 반대라 뒤집어 넣는다. 뒤집으면 급하강 조건(24샘플 안에 반값 하강)을 그대로 두고도 앉기 5분에서 ECG 431박 대 419박(SQI 통과 403)으로, 극성만 맞으면 급하강 조건이 PPG에서도 동작한다. 극성이 틀리면 반값 하강에 82샘플(0.34 s)이 걸려 창을 72샘플 이상으로 늘려야 산다. 또 손목 PPG 품질은 사람차가 크다. S4·S8·S9는 앉아 있어도 검출 30~60%이고(고역 차단을 0.5·1 Hz로 올려도 나아지지 않음), 이런 창은 `n60 < 30`으로 칩이 알아서 보류한다.

**움직임 크기별 오차 (SQI 있음, 손목 = PPG 센서 자체의 움직임, 창 안 12블록 최대)**

| 센서 움직임 | 창 수 | n60<30 보류 % | 평균 RR 오차 중앙값 | 오차 p90 | 판정 뒤집힘 % | SQI 없을 때 오차 중앙값 |
|---|---|---|---|---|---|---|
| < 0.1 g | 1,510 | 45 | 0.23 % | 0.96 % | 1.6 | 0.24 % |
| 0.1~0.2 | 712 | 45 | 0.51 | 1.98 | 0.8 | 0.88 |
| 0.2~0.3 | 824 | 61 | 1.39 | 5.40 | 2.0 | 2.99 |
| 0.3~0.5 | 2,829 | 67 | 1.71 | 6.86 | 1.8 | 5.23 |
| 0.5~1.0 | 6,419 | 69 | 2.63 | 17.4 | 2.7 | 11.4 |
| ≥ 1.0 g | 13,599 | 85 | 7.58 | 43.8 | 5.6 | 30.2 |

읽는 법. 판정은 평균 RR이 6% 길어지면 경보다. 센서가 1 g 넘게 흔들려야 오차 중앙값이 그 크기에 다가가고 뒤집힘이 5.6%로 뛴다. 1 g 아래에서는 뒤집힘 0.8~2.7%로, 움직임이 없을 때의 바닥(1.6%, 손목 PPG와 ECG의 고유 차이)과 큰 차이가 없다. **SQI가 일을 대부분 한다.** 0.5~1 g에서 SQI 없이는 오차 11.4%, 있으면 2.6%다.

**보류 정책별 결과 (손목 움직임 기준)**

| 문턱 | 범위 | 남는 뒤집힘 % | 판정 가능 창 (보류 없음 대비) | 보류되는 창 % (운전, 손목) |
|---|---|---|---|---|
| 없음 | – | 3.23 | 100 % | 0 |
| 0.3 g | 해당 블록 | 1.89 | 61 % | 56 |
| 0.3 g | 12블록 | 1.49 | 23 % | 99.7 |
| 0.5 g | 해당 블록 | 2.12 | 72 % | 35 |
| 0.5 g | 12블록 | 1.59 | 38 % | 93 |
| 1.0 g | 해당 블록 | 2.90 | 90 % | 13 |
| 1.0 g | 12블록 | 2.10 | 68 % | 62 |

읽는 법. IMU 보류가 없어도 뒤집힘 3.2%이고, 아무리 세게 걸어도 바닥 1.5% 아래로는 못 내려간다(그것은 움직임이 아니라 손목 PPG 고유 오차다). 대신 판정 가능한 창은 급격히 준다. **12블록 범위는 이득이 거의 없고 커버리지만 없앤다.** SQI가 그 블록의 나쁜 박동을 이미 빼기 때문에 나머지 11블록 동안 창 합이 오염돼 있지 않다. "운전 보류 %"는 손목(조향) 기준이라 이마에는 과대다. 이마 대용인 가슴으로 세면 운전 중 1.0 g 초과 블록은 0.8%, 0.5 g 초과 1.7%, 0.3 g 초과 5.3%다.

**가슴 움직임(이마 대용) 기준으로 같은 표**: 0.1 g 미만 오차 0.57% / 뒤집힘 1.8%, 0.1~0.2 g 2.0% / 1.8%, 0.2~0.3 g 2.9% / 1.6%, 0.3~0.5 g 4.1% / 7.4%, 0.5~1 g 8.8% / 4.8%, 1 g 이상 17.7% / 7.6%. 몸통이 0.3 g 넘게 움직이는 활동(걷기·계단·자전거)에서는 손목 PPG가 크게 틀리지만, 이는 손목이 같이 흔들리기 때문이지 몸통 움직임 자체의 효과가 아니다.

**결론.** IMU 보류를 더해도 판정 뒤집힘은 3.2 → 2.9%로 0.3%p밖에 줄지 않는다. 흔들림 구간의 나쁜 박동은 SQI가 이미 걸러 `n60 < 30` 보류로 이어지고, SQI가 뚫리는 것은 걷기 같은 규칙적 움직임뿐인데 운전 중에는 드물다. 그래서 움직임 보류는 넣지 않는다. 넣는다면 자료가 가리키는 답은 범위는 해당 블록만(12블록은 근거 없음), 문턱은 센서 자체 움직임 기준 1 g 근처다.

### 2.6 신호처리 블록의 IMU 처리

| 항목 | 내용 |
|---|---|
| 가속도 읽기 | `icm42670_reader`: 0x0B부터 12바이트(가속도+자이로) 버스트, 100 Hz. `o_accel_x/y/z`·`o_imu_valid`를 100 Hz로 내보냄 |
| 축 방향 | 풋프린트 좌표·데이터시트 축 그림으로 도출. **센서 Z = 보드 법선 = 앞(코), 숙이면 음**(위쪽 단위벡터 투영 = −sin θ). 센서 Y = 이마-턱(세우면 ±1 g, 부호는 착용 좌우에 따라). 센서 X = 귀-귀(끄덕임 회전축). 풋프린트가 QMI8658A 라이브러리라 실물에서 10초 확인이 필요하다(보드를 세워 어느 축이 1 g인지, 숙일 때 어느 축이 음으로 가는지) |
| 풀스케일·ODR | ±2 g(16,384 LSB/g), 100 Hz. `ACCEL_CONFIG0 = 0x69` |
| 내장 LPF | 16 Hz(이 칩의 최저). 2 Hz는 판정 블록의 IIR로 만든다 |

**자이로 끄덕임 검출(`imu_feature`).** 자이로 X를 4 Hz LPF → 아래로 30°/s가 50 ms 지속되면 "하강" 시작 → 각속도를 적분해 각도 → 0.3~2 s 안에 위로 20°/s 복귀하고 최대각 > `TH_ANGLE`(25°)이면 `o_nod_event`(1클럭 펄스), 2 s 안 복귀가 없으면 `o_nod_sustained`(상태, 1 s 뒤 내려감). 자이로 부호(`PITCH_SIGN`)는 런타임에 자동 판별하고, `o_pitch_sign_ok` 전에는 믿지 않는다. 얕게 숙이는 음성 사례(흘끗 14.3°, 얕은 유지 11.5°)를 포함한 테스트벤치 17/17을 통과한다.

**모션 게이트.** `o_motion_energy`(1 s 이동합, `MOTION_TH` 4000 ≈ 0.16 g 지속)가 `rr_extractor`의 탈락 조건과 `signal_quality` 감점에 들어간다. 즉 움직임 구간의 박동을 걸러내는 일은 신호처리 블록의 SQI가 이미 한다. 이 식을 PPG-DaLiA 가슴 15명에 적용하면 운전 중 1.5%, 걷기 97%가 걸린다. 하드웨어 팀이 mhealth24 이마+IMU 198분으로 잰 착석 대역 모션 단독 손실은 1.11%로 일치한다.

**자이로 끄덕임과 가속도 자세 규칙의 비교.**

| | 자이로 끄덕임 `imu_feature` | 가속도 자세 규칙 `imu_rule` |
|---|---|---|
| 잡는 것 | 꾸벅(빨리 떨어졌다 올라옴), 25° 이상 | 숙인 채 있음, 35° 이상 0.5 s |
| 천천히 처짐 | 못 잡음(30°/s 미만이면 시작 안 함) | 잡음 |
| 0.5 s 안에 복귀하는 꾸벅 | 잡음 | 못 잡음 |
| 떨군 채 계속 | `nod_sustained` 한 번, 반복 없음 | 5 s마다 반복 |
| 급제동 | 면역(자이로는 직진 가속을 안 봄) | 세로축으로 구별 |
| 부호 문제 | `PITCH_SIGN` 런타임 판별 필요 | Z 부호 도면 확정, Y는 절댓값 |

서로 못 잡는 것을 채우므로 **둘 다 쓰고 OR**한다. 자이로 쪽 문턱을 25°로 둔 것도 35°와 같으면 OR의 의미가 없어서 대역을 가르기 위해서다.

## 3. 물리 정리 — 가속도계 하나로 볼 수 있는 두 가지

가속도계는 중력(늘 1 g, 방향은 자세를 따라감)과 움직임 가속도의 합을 잰다. 이마에 붙인 센서에서

- **기울기(자세)**: 머리가 앞으로 θ만큼 숙이면 세로축 성분이 `g·cos θ`로 줄고 앞축 성분이 `g·sin θ`로 는다. 천천히 변하는 신호. 저역 필터 뒤에 남는 것.
- **움직임(동적 가속도)**: `‖a‖ − 1 g` 또는 연속 샘플 차. 고개를 흔들거나 차가 덜컹이면 커짐. 정지 기울기와 무관.

| 앞으로 숙인 각 θ | 앞축 `sin θ` | 세로축 `cos θ` | ±2 g LSB (앞축) | ±4 g LSB (앞축) |
|---|---|---|---|---|
| 15° | 0.259 g | 0.966 g | 4,240 | 2,120 |
| 20° | 0.342 g | 0.940 g | 5,603 | 2,802 |
| 30° | 0.500 g | 0.866 g | 8,192 | 4,096 |
| 35° (APEX 고정값) | 0.574 g | 0.819 g | 9,397 | 4,699 |
| 45° | 0.707 g | 0.707 g | 11,585 | 5,793 |

**혼동 요인.** 차의 가감속은 앞축에 그대로 더해진다. 일반 제동 0.2~0.3 g, 급제동 0.5 g 안팎(승용차 상식값, 트럭은 더 낮음)이 "20~30° 숙임"과 같은 크기다. 구별 수단은 (a) 지속시간 — 제동은 몇 초 가지만 떨굼도 그 정도라 약함, (b) 세로축 동시 확인 — 제동은 세로축을 안 바꾸지만 숙임은 `cos θ`로 줄인다. 20° 숙임이면 세로축 6% 감소, 30°면 13%. (c) 크기 — 순수 기울기면 `‖a‖ ≈ 1 g`, 제동 중이면 `‖a‖ > 1 g`. (b)와 (c)는 같은 정보의 다른 표현이다.

## 4. 고개 떨굼 후보 규칙

| | A. 기울기(중력 투영) | B. 급변(연속 샘플 차) | C. A + 크기 확인 |
|---|---|---|---|
| 판정 | 저역 필터 뒤 앞축 ≥ `g·sin θ_th`가 `T_hold` 이상 지속 | `|Δa|`가 문턱 초과 | A이면서 `‖a‖²`가 `1 g ± δ` 안 |
| 근거 | Ellcie 특허, APEX Tilt | [28] (신뢰 못 함) | 물리 |
| 잡는 것 | 고개가 숙여진 상태 | 툭 떨어지는 순간 | 숙여진 상태 중 정지 상태 |
| 놓치는 것 | 빨리 숙였다 바로 드는 것(지속시간 못 채움) | 천천히 숙이는 것, 숙인 채 있는 것 | A와 같음 + 덜컹이는 도로에서 숙인 것 |
| 헛경보 | 급제동, 고개 숙여 계기판 보기 | 요철, 고개 흔들기, 하품 | A보다 적음 |
| 회로 | 1축 비교 + 카운터, 필터는 IIR 시프트 1개 | 3축 뺄셈·비교 | A + 곱셈 3개(또는 세로축 비교 1개로 대체) |

`‖a‖²` 대신 **세로축 ≤ `g·cos θ_th`** 조건을 쓰면 곱셈 없이 C와 거의 같은 효과다(3절 (b)). 이 경우 떨굼 = "앞축 큼 AND 세로축 작음"이 T_hold 지속.

저역 필터는 센서 내장 DLPF(4 Hz)를 쓰거나, FPGA에서 `y += (x − y) >>> 3`(100 Hz에서 약 2.1 Hz, Ellcie와 같음)으로 만들 수 있다. 후자가 판정 블록 안에서 통제되고 비용은 축당 덧셈 1개라 후자를 쓴다.

## 5. 움직임 과다(보류) 후보 규칙

| | 척도 | 비용 | 비고 |
|---|---|---|---|
| M1 | 블록 안 `|Δa|` 최댓값 ≥ 문턱 (3축 각각 또는 합) | 뺄셈·비교 | APEX WoM과 같은 방식. 도로 요철에 민감 |
| M2 | 블록 안 `‖a‖² − 1 g²` 절댓값 최댓값 ≥ 문턱 | 곱셈 3개 | 2.4절 표의 척도. 기울기에 안 잡힘 |
| M3 | 블록 안 `|Δa|` 합(에너지) ≥ 문턱 | 누산기 | 순간 충격보다 지속 움직임을 봄. [29]의 움직임 파워와 비슷 |

보류가 미치는 범위로는 그 5초 블록의 판정만, 그 블록이 60초 창을 빠져나갈 때까지(12블록), 창 안 과다 블록이 k개 이상인 경우를 검토했다. 움직임은 박동 수를 직접 줄이지 않으므로 SQI와 별개의 이중 안전장치가 될 수 있지만, 2.5절에서 보듯 SQI가 움직임 구간의 나쁜 박동을 이미 걸러내 이득이 바닥과 구별되지 않는다.

[29]의 경고(초기 졸음에서 움직임 증가)를 감안하면 문턱을 낮게 잡을수록 커버리지가 떨어지면서 졸음 구간을 먼저 잃는다. 2.4절 가슴 기준 운전 중 0.3 g에서 5%, 0.5 g에서 1.7% 손실이 참고치다(이마가 가슴과 비슷하다는 가정). 이 두 이유로 움직임 보류는 넣지 않는다.

## 6. 확정 규칙

| 항목 | 결정 | 근거 |
|---|---|---|
| 떨굼 정의 | **4절 C.** 앞축 크고 세로축 작음, 지속시간 조건 | 급제동과 숙임을 가르는 수단이 세로축뿐이다(3절). B는 근거 문헌 [28]이 무너졌고 요철에 취약하다. A는 급제동을 못 가른다 |
| 숙임 각 | **θ = 35°** (앞축 ≥ 0.574 g AND 세로축 ≤ 0.819 g) | 즉시 경보라 보수적으로 잡는다. 외부 근거는 ICM-42670-P 내장 기울기 감지 기본값 |
| 지속시간 | **0.5 s** (50샘플 연속) | Ellcie 특허의 "긴 떨굼" 하한 |
| 떨어진 채 있을 때 | **5초마다 반복 펄스** | 판정 갱신 주기(5초)와 같게. 떨굼은 즉시 위험이라 심박 경보의 30초 간격을 적용하지 않는다. 통신 블록은 송신 중 온 펄스를 pending 플래그로 기억해 받는다 |
| 움직임 과다 보류 | **넣지 않는다.** IMU는 떨굼만 본다 | 2.5절: IMU 보류를 더해도 판정 뒤집힘 3.2 → 2.9%. 12블록 범위는 이득 없이 커버리지만 손실. 이마 실측에서 필요해지면 M2 척도·1 g·해당 블록만으로 붙인다 |
| 떨굼 대 보류 | 기준선 준비 중·박동 부족 보류 중에도 떨굼은 울린다 | IMU가 직접 본 것이라 심박과 무관하다 |
| 경보 형태 | `alert` 1클럭 펄스. 떨굼 펄스에는 심박 쪽 30초 간격을 적용하지 않고, 심박 간격에도 영향을 주지 않는다 | 통신 블록은 펄스마다 한 바이트만 보낸다 |
| 자이로 끄덕임과의 결합 | **둘 다 OR.** `alert = 판정(30초 간격) \| 자세 규칙 펄스 \| o_pitch_sign_ok & (o_nod_event \| rise(o_nod_sustained))` | 자이로 쪽은 꾸벅·급제동 면역, 자세 규칙은 천천히 처짐·5 s 반복. 서로 못 잡는 것을 채운다(2.6절 표). 자이로 문턱 25°와 자세 규칙 35°로 대역을 가른다 |
| 축 파라미터 | `FWD_AXIS=2(Z)`, `FWD_SIGN=−1`, `VERT_AXIS=1(Y)`, 세로축 절댓값 | 풋프린트 도면에서 도출(2.6절). 실물 10초 확인 뒤 파라미터만 바꾼다 |

## 7. 구현 (`imu_rule`, 파이썬 기준 모델과 같은 연산)

```
매 i_imu_valid (100 Hz):
  a_fwd  = FWD_SIGN × a[FWD_AXIS]          센서 Z, 부호 −1 → 숙이면 양
  a_vert = a[VERT_AXIS]                    센서 Y
  lp_f  += (a_fwd  − lp_f)  >>> 3          1차 IIR, 100 Hz 에서 약 2.1 Hz
  lp_v  += (a_vert − lp_v)  >>> 3
  tilt   = (lp_f ≥ TH_FWD) && (|lp_v| ≤ TH_VERT)      TH_FWD = 9397 (sin35°), TH_VERT = 13420 (cos35°)
  cnt    = tilt ? cnt+1 : 0
  o_nod  = (cnt 가 50 에 닿음) 또는 (cnt 가 550 에 닿음 → cnt ← 50)      0.5 s 뒤 1회, 이후 5 s 마다

infer_top:
  m_nod = o_nod(자세 규칙) | i_pitch_sign_ok & (i_nod_event(자이로, 펄스) | rise(i_nod_sustained)(자이로, 상태 → 상승 에지))
  heart = 30초 간격 규칙을 통과한 심박 경보
  alert = heart | m_nod
```

곱셈은 없다. 덧셈 2, 비교 3, 카운터 10비트다. 필터 결과는 두 입력 사이 값이라 16비트를 넘지 않는다(바닥 나눗셈 포함, 파이썬 기준 모델에서 단언문으로 확인).

세로축은 **절댓값**을 쓴다. 헤드밴드를 뒤집어 쓰면 Y 부호가 바뀌지만 규칙은 같다. 축·부호·문턱·시간은 전부 파라미터라 실물 확인 뒤 `FWD_AXIS/FWD_SIGN/VERT_AXIS`만 바꾼다.

뺄셈에 결합(`{a[15], a} - {lp[15], lp}`)을 쓰면 식 전체가 unsigned로 승격돼 `>>>`가 논리 시프트가 되고 음수 입력에서만 틀린다. 그래서 `$signed()`로 감싼다. IIR의 바닥 나눗셈 때문에 상수 입력에서 `lp`가 목표보다 최대 7 LSB(0.0004 g) 아래에 머무르는데, 무시할 크기다.

자이로 쪽 `nod_sustained`는 상태라 `infer_top`에서 상승 에지로 한 번만 센다. `nod_event`는 이미 1클럭 펄스다. 둘 다 자이로 부호가 확정된 뒤(`i_pitch_sign_ok = 1`)에만 받는다. 확정 전에는 `imu_feature`가 부호를 +1로 가정하고 돌아, 헤드밴드를 반대로 쓴 경우 꾸벅임을 놓치거나 고개를 든 자세에서 `nod_sustained`가 설 수 있기 때문이다. 자세 규칙은 앞축 부호가 패키지 방향으로 고정돼 이 영향이 없다. 떨굼 경보는 기준선 준비·보류와 무관하게 울린다.

## 8. 검증 결과

**합성 벡터** (16 시나리오, 11,590샘플, 정답은 파이썬 기준 모델). 테스트벤치가 샘플마다 필터·카운터 레지스터와 펄스 수를 대조한다. **불일치 0, 펄스 10/10.**

| 시나리오 | 내용 | 펄스 | 기대 |
|---|---|---|---|
| still / vibration | 정지 10 s / 도로 진동 12 Hz 0.1 g + 잡음 0.03 g | 0 / 0 | 0 |
| brake_0p5g / brake_0p7g | 급제동 0.5 g 3 s / 0.7 g 2 s (앞축은 30°·45° 숙임과 같음) | 0 / 0 | 0 — 세로축이 막음 |
| dashboard_20deg | 계기판 보기 20° 2 s | 0 | 0 |
| glance_40deg_0p3s | 꾸벅 40° 0.3 s | 0 | 0 — 지속 부족 |
| nod_40deg_1s | 떨굼 40° 1 s | 1 (1.74 s) | 1 |
| sleep_50deg_20s | 잠듦 50° 20 s | 4 (1.78, 6.78, 11.78, 16.78 s) | 4 |
| sleep_45deg_vib | 요철 위 45° 3 s | 1 | 1 |
| shake_lateral / tilt_back_30deg | 좌우 흔들기 ±0.5 g / 뒤로 젖힘 30° | 0 / 0 | 0 |
| dash_plus_brake | 20° 보면서 0.5 g 제동(앞축 합 0.84 g) | 0 | 0 — 세로축 cos20°=0.94 |
| slow_slump | 6 s에 걸쳐 45°까지 처져 10 s 유지(자이로 끄덕임은 못 잡는 경우) | 3 (6.22 s부터 5 s마다) | – |
| exact_35deg | 정확히 35° 5 s | 0 | – (경계, 잡음·바닥 나눗셈) |
| nod_y_negative | 40° 1 s, 세로축 부호 반대 | 1 | 1 |
| clip_extreme | 포화값 | 0 | – (오버플로 없음) |

**PPG-DaLiA 가슴 가속도(이마 대용, 앞=+Z 세로=X)에 같은 규칙, 15명 35.9 h.** 운전 3.8 h **0회**(15명 전원 0), 앉기 0.4회/h, 업무 3.8회/h, 점심 5.0회/h, 이동 7.8회/h, 자전거 109회/h, 축구 100회/h. 몸통을 35° 넘게 앞으로 숙인 채 있는 활동(자전거)에서만 나고 운전 자세(가슴 Z ≈ −0.5 g, 뒤로 젖힘)에서는 안 난다. 가슴이라 머리 떨굼은 없는 데이터고, "정지 자세 규칙이 운전 중 헛울리지 않는다"의 참고다.

**RTL 대조.** 참가자 S1 전체 921,200샘플을 가슴 축에 맞게 파라미터를 바꿔(`FWD_SIGN=1`, `VERT_AXIS=0`) 컴파일해 돌렸다. 파이썬과 불일치 0, 펄스 1/1이다. 축 선택·부호 파라미터가 RTL에서도 맞게 동작한다는 확인을 겸한다.

**판정 블록 회귀.** `infer_top` 전체로 판정 테스트벤치(50명 + 경계 사례 75,464블록, IMU 입력 0)를 돌려 `hold`·`drowsy`·`alert` 불일치 0이다.

**Vivado 2026.1, xc7a35t, out-of-context, 12 MHz.** `imu_rule`은 곱셈이 없어 DSP를 쓰지 않는다. `infer_top` 전체(판정 + 자세 규칙 + 경보 결합)는 단독 합성 LUT 305, FF 107, DSP 3, WNS 72.3 ns(주기 83.3 ns)다.

## 참고

- [28] Nurnaningsih et al., J. Teknik Informatika 18(2), 2025.
- [29] Li & Chung, Sensors 15(8) 20873, 2015.
- [30] Cao et al., FDWatch, ACM TOSN 2022, DOI 10.1145/3560821 (초록만).
- Ellcie Healthy, US 10,152,869 B2, "Personal system for the detection of a risky situation and alert", 2016 우선권. https://patents.google.com/patent/US10152869B2/en
- Lytx, US 8,952,819 B2, "Direct observation event triggering of drowsiness", 2013.
- TDK InvenSense, ICM-42670-P Datasheet DS-000451.
- PPG-DaLiA 데이터셋(15명, 손목 Empatica E4·가슴 RespiBAN).
