albertjihyun/Busan-IDEC/docs/integer-inference-design.md

# 정수 판정과 추론 Verilog 설계서

모델 비교에서 확정한 판정(로지스틱 회귀, 특징 `mean_rb` 하나, 60초 창, 헛경보 시간당 4회 동작점)을 칩에 넣는 방법을 정한다. 판정식을 나눗셈·실수 없이 정수로 바꾸고, 그 정수 연산을 Verilog로 짜서 파이썬 기준 모델과 비트 단위로 같은지 확인한다.

## 1. 무엇을 만드는가

특징이 하나라 판정은 문턱 한 줄이다.

```
mean_rb = (60초 창 평균 RR) ÷ (기준선 평균 RR) ≥ T   →   drowsy
```

이 한 줄을 정수 비교로 바꾸고 Verilog로 구현한다. 테스트벤치의 정답은 라벨이 아니라 **파이썬 정수 판정**이다. 모델 성적은 모델 비교 단계에서 사람을 분리한 교차검증으로 이미 확인했고, 여기서는 회로가 그 모델을 정확히 구현했는지만 본다.

## 2. T 값

교차검증의 T는 폴드마다 학습 데이터로 잡은 값이라 배포용 하나가 아니다. 배포용은 MPD-DF 50명 전체 `mean_rb`에 헛경보를 정확히 맞추는 문턱 탐색을 한 번 적용해 잡았다. 학습 데이터와 시험 데이터가 같으므로 아래 민감도는 검증값이 아니다.

| 동작점 | T (실수) | 헛경보 실측 | 사건 민감도 | 창 민감도 |
|---|---|---|---|---|
| 4회/h 주 | 1.06017 | 3.96/h | 0.385 | 0.359 |
| 2회/h 보조 | 1.09992 | 1.97/h | 0.252 | 0.203 |

**칩에는 4회/h 하나만 넣는다.** 2회/h 값은 참고로만 둔다.

**문턱은 학습 검출기 RR로 잡는다.** 칩에는 PPG용 칩 검출기가 들어가지만, 그 검출기로 ECG에서 RR을 뽑아 문턱을 잡으면 사람을 분리한 교차검증에서 로지스틱 60초 4회/h 상한 절차에서 사건 민감도가 0.401 → 0.237, 실측 헛경보 4.80/h로 무너진다. 칩 검출기가 ECG의 T파를 봉우리로 잡는 사람이 50명 중 11명(오검출 21~58%)이라 그 사람들의 `mean_rb`가 흔들리기 때문이고, 이는 PPG에는 없는 왜곡이다. 그래서 문턱은 ECG에서 검증된 학습 검출기(놓침 1.0%·오검출 3.2%) RR로 잡고, 칩 검출기는 PPG에서 따로 검증한다(이마 12시간 평균 RR 편향 −0.1%).

## 3. 판정식 정수화: 나눗셈을 없앤다

두 방법을 비교했다.

| | A. 나눈 뒤 곱하기 | B. 교차 곱셈 (채택) |
|---|---|---|
| 기준선 완성 시 | `B = ⌊ΣRR_base ÷ N_base⌋`, `K = (T_FIX × B) >> f` | `R = T_FIX × ΣRR_base` (곱셈 1회) |
| 매 5초 | `sum_rr60 ≥ K × n60` | `(sum_rr60 × N_base) << f ≥ R × n60` |
| 회로 | 나눗셈기 1개(한 번만 쓰지만 있어야 함) + 곱셈 1개 | 곱셈 2개, 나눗셈 없음 |
| 근사 | B 절단(최대 1샘플 = 0.4%) + K 절단 + T 반올림 | T 반올림 하나뿐 |

졸음이 만드는 `mean_rb` 변화가 1.3%라 0.4% 절단은 무시할 수 없다. B는 `mean_rb ≥ T`의 양변에 `n60 × N_base × 2^f`를 곱한 것이라 정수 비교가 실수 비교와 정확히 같고, 유일한 근사는 T를 `T_FIX / 2^f`로 둔 것이다. 그래서 파이썬 정수 기준 모델과 Verilog가 같은 식을 쓰면 "비트 일치"가 곧 "모델 일치"다.

## 4. T_FIX 폭: 소수 10비트, T_FIX = 1086

소수 비트 f를 8·10·12로 두고 각각 T_FIX 후보를 훑었다. 기준은 두 가지다. (1) 50명 전체에서 헛경보 4회/h 이하가 되는 **가장 작은** 정수(반올림이 아니라 규정 방향으로), (2) 실수 T와 정수 T_FIX의 판정이 갈리는 블록 수(73,009개 판정 블록 중).

| f | T_FIX | T | 헛경보/h | 사건 민감도 | 뒤집힘 | 비트 폭(좌변/우변) |
|---|---|---|---|---|---|---|
| 실수 | — | 1.06017 | 3.96 | 0.385 | 0 | — |
| 8 | 272 | 1.06250 | 3.87 | 0.374 | 735 (1.01%) | 35 / 33 |
| **10** | **1086** | **1.06055** | **3.95** | **0.381** | **120 (0.16%)** | **37 / 35** |
| 12 | 4342 | 1.06006 | 3.98 | 0.385 | 35 (0.05%) | 39 / 37 |

**10비트를 채택한다.** 뒤집힘은 정밀도 손실이라기보다 문턱이 격자 위로 옮겨 간 것이다(뒤집힌 블록의 `mean_rb`는 전부 1.06017~1.06054 사이, 즉 두 T 사이). 8비트는 문턱이 0.2% 옮겨 가서 사건 5개(0.385 → 0.374)를 잃었고, 10비트는 2개(0.381), 12비트는 0개다. 실수 T의 넷째 자리는 50명 표본이 검증해 주는 값이 아니므로 12비트까지 갈 근거가 약하고, 10비트면 헛경보·민감도가 실수 T와 오차 안에서 같다. 12비트로 바꾸려면 기준 모델과 `classifier`의 상수 두 개(`FRAC`, `T_FIX`)만 바꾸면 된다.

5절의 창 품질 규칙을 넣어도 50명에서 판정 블록이 73,009 → 72,840(99.8%), 헛경보 3.95 → 3.94/h, 사건 민감도 0.381 → 0.379(167/441)로 거의 변하지 않고, 같은 기준으로 다시 잡은 T_FIX도 1086 그대로다.

## 5. 기준선과 창 품질

신호처리 블록이 주는 것은 5초마다 갱신되는 **60초 창 합** `n60`, `sum_rr60`, `bad60`(탈락 박동 수)뿐이고 5초 블록 하나짜리 값은 없다. 12블록 간격의 60초 창(블록 0~11, 12~23, 24~35, …)은 서로 겹치지 않으므로 **12·24·36·…번째 블록의 창 합을 더하면** 그만큼의 분 합이 정확히 나온다. 블록 하나짜리 값(`o_n_blk`·`o_sum_rr_blk`)을 새로 받아도 같은 값이 나오므로 인터페이스를 늘리지 않았다.

```
좋은 창:   n60 ≥ 30  그리고  3 × bad60 ≤ n60              (살린 박동 75% 이상)
기준선:    12·24·36·…번째 블록마다 그 창이 좋으면
             N_base += n60,  ΣRR_base += sum_rr60
           좋은 창 3개가 모이면 R = T_FIX × ΣRR_base, 준비 완료
           나쁜 창은 건너뛰고 다음 1분 창을 기다린다 (최소 3분, 재시작 없음)
```

좋은 창 조건이 필요한 이유는 이마 PPG에서 접촉이 나쁜 창이 박동 절반 이상을 버리고도 박동 수 조건을 통과하기 때문이다. 남은 박동이 한쪽으로 쏠려 창 평균 RR이 흔들리고, 그런 창이 기준선에 들어가면 그 사람의 판정이 하루 종일 한쪽으로 기운다. WildPPG 이마 PPG 15명에서 이 두 조건을 넣으면 ECG 대비 PPG `mean_rb` 차이의 표준편차가 7.4% → 1.7%, 판정 일치가 97.4%가 된다. 탈락 기준은 파라미터 `KEEP_K`(3 = 75%, 2 = 67%, 1 = 50%, 0 = 탈락 수 안 봄)로 두고 보드 실측 뒤 조정한다. `KEEP_K × bad60`은 시프트와 덧셈이다.

처음 3분이 전부 좋은 창이면 기준선은 첫 3분 합과 같다. MPD-DF 50명(ECG)에서는 3명(26·32·40번)만 나쁜 창을 건너뛰어 기준선이 첫 3분과 달라지고, 그 경우도 최대 5분 안에 완성된다.

## 6. hold 규칙

`hold=1`이면 `drowsy=0`.

| 조건 | hold |
|---|---|
| 기준선 준비 전 (기준선이 완성되는 블록 포함) | 1 |
| 좋은 창 아님 (`n60 < 30` 또는 `3 × bad60 > n60`) | 1 |
| 그 외 | 0 |

신호처리 블록의 `o_sqi_bad`는 쓰지 않는다. SQI 탈락 박동은 이미 `n60`·`sum_rr60`에서 빠져 있고 그 수가 `bad60`으로 들어오므로 좋은 창 조건이 그 역할을 한다. 이력(hysteresis)·연속 N회 규칙은 없다. `drowsy`는 5초 판정 그대로 쓰고, 경보 반복 간격은 판정이 아니라 `infer_top`의 경보 단계에서 둔다(9절).

## 7. 비트 폭

| 신호 | 폭 | 최대값 근거 |
|---|---|---|
| `n60`, `sum_rr60`, `bad60` | 8, 17, 8 | 신호처리 블록 출력 폭 |
| `N_base` | 10 | 3 × 255 = 765 |
| `ΣRR_base` | 16 | 3 × (60 s × 240 + 360) = 44,280 |
| `T_FIX` | 11 | 1086 < 2048 |
| `R = T_FIX × ΣRR_base` | 27 | 11 + 16 |
| 좌변 `(sum_rr60 × N_base) << 10` | 37 | 17 + 10 + 10 |
| 우변 `R × n60` | 35 | 27 + 8 |

곱셈은 세 개다(R 한 번, 좌·우변 5초마다). 12 MHz에서 5초에 한 번이라 파이프라인 없이 입력을 잡는 클럭(기준선 갱신과 R), 곱셈 클럭, 비교 클럭으로 나눠 `i_win_valid`로부터 3클럭 뒤에 판정이 나온다.

곱셈기는 공유하지 않고 셋 다 따로 둔다. FPGA에서 곱셈은 미리 박힌 DSP48E1 블록(xc7a35t에 90개)에 배정되므로 세 개를 써도 LUT는 늘지 않고 DSP 3개를 점유할 뿐이다. 공유하면 DSP 1개로 줄지만 피연산자 먹스·순서 제어 FSM·결과 배선이 붙어 LUT 30~60개가 더 들고 2클럭 늦어진다. 즉 DSP 2개와 LUT 수십 개의 교환이지 절약이 아니다. R = T_FIX × ΣRR_base는 상수 곱(1086 = 1024 + 64 − 2)이라 `(* use_dsp = "no" *)`로 시프트·덧셈 3번으로 바꿔 DSP 2개로 만들 수는 있으나, DSP가 남으므로 그대로 둔다. ASIC이어도 공유 곱셈기는 세 곱의 최대 폭(27×16)이 필요해 절약이 20%대에 그치고, 그때는 공유가 아니라 직렬(시프트·덧셈) 곱셈기로 바꾸는 것이 맞다.

## 8. 정답지와 테스트 벡터

파이썬 정수 기준 모델이 MPD-DF 50명의 5초 블록 75,186개 전부에 대해 재료(`n60`, `sum_rr60`, `bad60`), 기준선, 정수 판정, 실수 판정, 뒤집힘 확인용 `mean_rb`를 담은 정답지를 만든다. 테스트벤치용 벡터는 사람마다 한 벌씩 `block n60 sum_rr60 bad60 hold drowsy` 형식이고, 테스트벤치가 앞의 재료를 넣고 뒤의 `hold`·`drowsy`를 대조한다.

재료는 학습에 쓴 60초 특징 표와 같은 절차(5초 블록 누산, 봉우리 위치 기준 블록)로 만들되 5초마다 저장한다. 30초 에폭 끝 블록의 `n60`·`sum_rr60`이 특징 표의 박동 수·RR 합과 12,481개 에폭 전부 같음을 생성 과정에서 단언문으로 확인한다.

경계 사례는 손으로 만든 5벌(278블록, 다섯째는 경보 간격)이고, 사례가 바뀔 때마다 리셋한다. 판정 경계(양변이 정확히 같을 때 `≥`이므로 drowsy=1, ±1, `n60` 29/30, `n60=0`, 입력 최대값 `n60=255`·`sum_rr60=131071`), 창 품질 경계(`3 × bad60 = n60`은 좋은 창, 1 넘으면 hold, `bad60=255`), 나쁜 창(박동 부족·탈락 과다)을 건너뛰고 좋은 창 3개가 모일 때 완성되는 기준선과 1분 창 사이 블록 값이 쓰이지 않는지, `N_base`·`ΣRR_base` 상한 근처 값을 본다.

테스트벤치는 파형 없이 5초 펄스와 세 값만 넣으므로 50명 전부를 한 번에 돌린다.

## 9. Verilog 인터페이스

`classifier`

| 방향 | 신호 | 폭 | 뜻 |
|---|---|---|---|
| in | `clk`, `rst_n` | | 12 MHz, 액티브 로우 |
| in | `i_win_valid` | 1 | 신호처리 블록 `o_win_valid`. 5초마다 1클럭 |
| in | `i_n60`, `i_sum_rr60`, `i_bad60` | 8, 17, 8 | 신호처리 블록 `o_n60`, `o_sum_rr60`, `o_bad60` |
| out | `o_valid` | 1 | 판정이 갱신된 클럭에 1펄스(`i_win_valid` 3클럭 뒤) |
| out | `o_hold` | 1 | 6절 |
| out | `o_drowsy` | 1 | 판정. `o_hold=1`이면 0 |
| out | `o_ready` | 1 | 기준선 확정됨 |

파라미터는 `T_FIX=1086`, `FRAC=10`, `WIN_BLOCKS=12`(60초 창 = 5초 블록 12개), `BASE_WINS=3`(기준선 = 좋은 1분 창 3개), `MIN_N60=30`, `KEEP_K=3`이다.

`infer_top`은 `classifier`와 고개 떨굼 규칙 `imu_rule`을 감싸 `alert`(1클럭 펄스)와 `ready`(`o_ready` 그대로, 상태 표시용)를 낸다. 심박 경보는 졸림 판정을 30초(`REPEAT_BLOCKS` 6블록) 간격으로 내보낸 것이고, 판정(`hold`·`drowsy`)과 그 지표는 이 간격과 무관하다. `alert`는 심박 경보, 자세 규칙 펄스, 자이로 부호가 확정된 뒤의 자이로 끄덕임을 OR 한 것이다.

## 10. 결과

**시뮬레이션** (Icarus Verilog): 50명 75,186블록 + 경계 278블록 = 75,464블록 전부 `hold`·`drowsy`가 파이썬 정수 정답과 일치하고, `infer_top`의 `alert` 펄스 수도 30초 간격 규칙을 적용한 정답과 같다(불일치 0). 테스트벤치가 오류를 잡는지는 상수를 일부러 틀려 확인했다. `T_FIX` 1086 → 1087, `MIN_N60` 30 → 31, `REPEAT_BLOCKS` 6 → 5가 각각 불일치로 잡히고, `KEEP_K` 3 → 2는 567블록, `BASE_WINS` 3 → 2는 4,772블록에서 불일치가 난다. 실행은 2초다.

**Vivado 2026.1 합성·구현** (xc7a35t, out-of-context, 12 MHz, `infer_top` = `classifier` + `imu_rule` + 경보 결합):

| 항목 | 값 | 비고 |
|---|---|---|
| LUT | 305 (1.47%) | 단독 합성(out-of-context) 값이다. 칩 최상위 `system_top`에 통합하면 계층 간 최적화로 LUT 207, FF 107, DSP 3이 된다. |
| FF | 107 | 곱 결과 레지스터는 DSP 안으로 흡수됨 |
| DSP48E1 | 3 | R = T_FIX × ΣRR_base, 좌변 17×10, 우변 27×8. `imu_rule`은 곱셈 없음 |
| BRAM | 0 | |
| 타이밍 | WNS 72.3 ns / 주기 83.3 ns | 12 MHz에서 여유가 크다 |

모델 비교 때 잡은 파라미터 예산(4 KB) 대비 파라미터가 1개(11비트)라 비교가 무의미할 정도로 작다.

## 11. 검출기 역할 분리

칩의 봉우리 검출은 신호처리 블록의 칩 검출기가 맡고, 학습 검출기는 ECG 학습 데이터에서 RR을 뽑는 데만 쓴다. 각자 자기 신호에서 참값에 가까운 RR을 내기 때문이다. 이마 PPG 12시간에서 학습 검출기는 첫 포화 아티팩트 뒤 문턱이 안 내려와 커버리지가 0%가 되지만, 칩 검출기는 커버리지 75~83%에 평균 RR 편향 −0.1%다. 반대로 ECG에서는 칩 검출기가 T파를 봉우리로 잡는 사람이 11명이다. 둘을 잇는 것은 특징 `mean_rb`이고, 문턱은 참값에 가까운 RR로 잡은 값을 공유한다.

이 연결은 WildPPG(흉골 ECG와 이마 PPG 동시 기록) 15명에서 같은 사람의 ECG(학습 검출기)와 이마 PPG(칩 검출기)로 60초 창 `mean_rb`를 나란히 내어 확인했다. 5절의 창 품질 규칙을 넣으면 치우침 −0.1%, 흔들림(차이 표준편차) 1.7%, 판정 일치 97.4%다.
