albertjihyun/Busan-IDEC/docs/model-comparison-design.md

# 모델 비교 설계서

30초·60초 특징 표로 후보 모델 5종(계획한 7종 중 RBF SVM·소형 MLP는 10절 이유로 생략)을 같은 채점기로 비교해 창 길이를 확정하고, 정수 판정으로 넘길 모델을 고른다. 10절이 최종 결정이고, 11절은 발표·질의에서 나올 질문과 답을 모았다.

설계 원칙은 하나다. **시험 피험자는 그 사람을 채점하는 모델을 만드는 과정 전체(학습·손잡이·특징·문턱·스케일 상수)에서 보지 않는다.** 그리고 **절차를 이 문서로 먼저 고정하고 바깥 고리는 모델마다 한 번만 돌린다.** 바깥 결과를 보고 절차를 바꾸면 그 점수는 "탐색 후 점수"라고 이름 붙인다.

## 1. 데이터

- 입력: 30초 특징 표와 60초 특징 표. 행 키 (sid, epoch)가 같고 정답 열이 같다. 창 길이 비교는 같은 정답으로 한다.
- 학습·채점 행: 유효 행(30초 11,903행, 60초 11,900행). 첫 3분(기준선 구간)·아티팩트·박동 부족 행은 학습에도 채점에도 안 쓴다.
- 특징 후보 14개: `mean_nn sdnn rmssd sdsd cvnn cvsd sd2 sd12 mean_rb sdnn_rb rmssd_rb mean_dp sdnn_dp rmssd_dp`. `median_nn`, `*_db`는 비교용이라 제외한다.
- 정답 `y`: 0 = 각성, 1 = 피로1 이상.
- 사건: 피험자 안에서 `y == 1`인 에폭이 연속된 구간. 전체 445건, 그중 유효 에폭을 하나라도 가진 "판정 가능 사건" 443건. 나머지 2건은 판정 불가로 따로 센다.
- 예외 피험자: 26번(SQI 탈락 19%), 05·47번(아티팩트 절반)은 **빼지 않는다.** 사람별 결과표를 남겨 성적이 이상한지 본다. 42·49번(사건 0), 22번(각성 0)은 pooled 계산이라 문제없다.

## 2. 평가 구조: 겹친 LOSO

```
바깥 고리 (50회): 시험 1명 | 학습 49명
   ├ 49명 안에서 상관 0.95 쌍 정리
   ├ 안쪽 고리 (사람 단위 5묶음): 손잡이 탐색 → 특징 하나씩 빼기 → 문턱 선택
   └ 최종 손잡이·특징으로 49명 학습 → 시험 1명 점수 저장
50명 점수를 모아(pooled) 한 번에 지표 계산
```

- 바깥: `LeaveOneGroupOut`, 그룹 = sid.
- 안쪽: `GroupKFold(5)`, 그룹 = sid. 계산량과 안정성의 관례적 절충이다.
- 안쪽 점수: **창 단위 ROC AUC의 안쪽 폴드 평균.** 사건 지표는 문턱이 있어야 나오는데 손잡이 탐색은 문턱 없는 점수가 필요하고, AUC는 폴드별 평균이 권장된다(Forman & Scholz 2010). 사건 민감도의 대리 지표라는 점을 결과 보고에 적는다.
- 재현성: 모든 난수 seed를 0으로 고정한다. 같은 코드로 다시 돌리면 같은 결과가 나온다.

## 3. 바깥 폴드 안 절차 (모든 모델 공통)

1. **상관 정리.** 학습 49명에서 특징 간 |상관| ≥ 0.95인 쌍은 우선순위가 낮은 쪽을 뺀다. 우선순위는 1차 특징 8개 → 비율 3개 → 차 3개 순, 각 묶음 안에서는 위 목록 순이다. 1차 특징이 회로에서 싸고 해석이 쉬워서다. 특징 표에서 본 쌍은 rmssd=sdsd, sdnn≈sd2.
2. **손잡이 탐색.** 모델별 탐색 공간(5절)에서 `RandomizedSearchCV`(안쪽 5묶음, AUC). 후보 수는 모델별로 적다.
3. **특징 하나씩 빼기.** 2에서 고른 손잡이를 고정하고, 현재 특징 세트로 안쪽 5묶음을 학습·채점해 (a) AUC 평균·표준오차, (b) 각 특징의 **순열 중요도**(검증 묶음에서 그 특징 열을 섞었을 때 AUC 하락, 3회 반복 평균)를 얻는다. 중요도가 가장 낮은 특징을 빼고 반복해 1개까지 내려간다(Guyon 2002 RFE의 순열 중요도 판). 후보 하나하나를 빼 보며 재학습하는 완전 탐욕 방식은 계산이 7배라 택하지 않았다. 최종 특징 세트는 **1-SE 규칙**(Breiman 1984 CART)으로 고른다. 안쪽 AUC 최고값에서 그 표준오차 안에 드는 세트 중 가장 작은 것이다. 작은 세트가 칩에서 싸고 새 사람에게 덜 흔들린다. 규칙 모델은 특징 1개를 학습이 고르므로 이 단계가 없다.
4. **문턱 선택.** 3의 특징·손잡이로 안쪽 5묶음 교차 예측(out-of-fold) 점수를 만들고, 그 위에서 사건 채점(4절)을 해 **헛경보 상한 N별로 문턱**을 고른다. N ∈ {0.5, 1, 2, 4, 8}회/시간. 동작점은 곡선을 본 뒤 정하므로 격자로 전부 낸다. 각 N에서 "헛경보 ≤ N을 지키는 문턱 중 사건 민감도 최대"를 고른다.
5. **최종 학습.** 49명 전체로 학습하고, 시험 1명의 점수(연속값)와 N별 경보(이진)를 저장한다.

특징 선택은 손잡이 탐색 뒤에 한다. 둘을 동시에 하면 계산이 곱해지는데 얻는 게 적다. 바깥 점수를 보고 절차를 바꾸지 않는다.

## 4. 채점

발작 검출 표준(NEDC any-overlap, SzCORE 2024)을 30초 에폭에 맞춘 것이다. 정의는 한 곳에 모아 모든 모델이 같은 채점기를 쓴다.

- **경보 덩어리**: 한 피험자 안에서 경보가 켜진 유효 에폭들을, 사이 간격이 90초 미만(경보 없는 에폭 2개 이하)이면 하나로 합친 것(SzCORE 병합 규칙). 무효 에폭은 간격에 포함해서 센다. 덩어리가 5분(10에폭)을 넘으면 5분 단위로 쪼갠다(SzCORE 분할 규칙). 이 분할이 없으면 "항상 켜짐"이 헛경보 0·민감도 100%가 되는 빈틈이 생긴다.
- **사건 검출**: 판정 가능 사건의 에폭 중 하나라도 경보 덩어리와 겹치면 검출 1. 여러 번 겹쳐도 1.
- **헛경보**: 사건과 하나도 겹치지 않는 경보 덩어리 1개 = 헛경보 1회.
- **헛경보/시간** = 헛경보 수 ÷ (유효 각성 에폭 수 × 30초 / 3600). 분모를 각성 시간으로 두면 녹화 전체 시간보다 값이 커져 보수적이다.
- **사건 민감도** = 검출 사건 수 ÷ 판정 가능 사건 수(443).
- 주 지표: 사건 민감도. 짝 지표: 헛경보/시간. 보조: 창 단위 민감도·특이도·정확도(참고), 창 AUC(양성·음성 다 있는 47명의 평균), 커버리지.
- **pooled**: 50명의 시험 예측을 모아 한 번 계산한다(Forman & Scholz 2010).
- **FROC 곡선**: 폴드마다 점수 단위가 다르므로(규칙은 특징 원값, SVM은 결정함수) 각 폴드의 시험 점수를 그 폴드 학습 OOF 분포 기준 백분위로 바꾼 뒤, pooled 점수에서 문턱을 훑어 (헛경보/시간, 사건 민감도)를 그린다. 이 곡선은 "설명"이지 "선택"이 아니다. 선택된 동작점은 3절 4의 N별 문턱을 시험 피험자에 적용한 결과이고, 둘을 같은 그림에 겹친다.
- **신뢰구간**: 피험자 단위 부트스트랩(1000회, 피험자를 복원추출하고 그 사람의 사건·에폭을 통째로 가져감)으로 사건 민감도와 헛경보/시간의 95% 구간을 낸다(Field & Welsh 2007).
- 사람별 표: sid별 사건 수, 검출 수, 헛경보 수, 각성 시간, 창 AUC.

첫 3분 안에서 시작한 사건은 판정 가능 사건에 유효 에폭이 있으면 그대로 센다. 30초짜리 사건(23%)은 유효 에폭 하나뿐이라 그 한 번의 판정으로 갈린다.

## 5. 모델 7종과 탐색 공간

칩 후보 5(규칙, 얕은 트리, 로지스틱, 랜덤포레스트, 부스팅 트리)와 비교선 2(RBF SVM, 소형 MLP). 비교선은 이기더라도 칩에 못 올리고, "작게 가면 얼마나 잃는가"를 보여 준다. 작은 표 데이터에서는 트리 앙상블과 RBF SVM이 강하고, 칩에서는 비교기만 쓰는 트리와 곱셈이 적은 선형 모델이 싸다는 문헌 결과를 따라 후보를 골랐다.

| 모델 | 구현 | 스케일링 | 탐색 공간 | 후보 수 |
|---|---|---|---|---|
| 규칙 (`rule`) | 특징 1개 + 문턱. 학습 = 학습 폴드 AUC가 가장 높은 특징(방향 포함)을 고름 | 없음 | 없음 | 상관 정리 후 남은 특징 전수(약 11) |
| 얕은 트리 (`dtree`) | `DecisionTreeClassifier` | 없음 | depth 1~8, min_samples_leaf {20,50,100,200,500}, class_weight {None, balanced} | 30 |
| 로지스틱 (`logreg`) | `StandardScaler` + `LogisticRegression` | 학습 폴드 평균·표준편차. 가중치에 흡수되므로 칩 비용 0 | C 10^-3 ~ 10^2 (11점), class_weight {None, balanced} | 22 (전수) |
| 랜덤포레스트 (`rf`) | `RandomForestClassifier` | 없음 | trees {50,100,200}, depth {2,3,4,6,8,None}, leaf {5,20,50,100}, max_features {sqrt, 0.5, 1.0}, class_weight {None, balanced_subsample} | 30 |
| 부스팅 (`gboost`) | `HistGradientBoostingClassifier` | 없음 | iter {50,100,200,400}, lr {0.03,0.1,0.3}, depth {2,3,4}, leaf {20,50,100}, l2 {0,1,10}, class_weight {None, balanced} | 30 |
| RBF SVM (`svm_rbf`) | `StandardScaler` + `SVC(rbf)` 결정함수 | 학습 폴드 | C 10^-2 ~ 10^2 (5점), gamma {scale, 0.01, 0.1, 1}, class_weight {None, balanced} | 15 |
| 소형 MLP (`mlp`) | `StandardScaler` + `MLPClassifier`, early_stopping | 학습 폴드 | hidden {(4),(8),(16),(32),(16,8)}, alpha {1e-4,1e-3,1e-2,1e-1}, lr_init {1e-3,1e-2} | 20 |

- 클래스 불균형: 기본은 문턱으로 대응한다(Provost 2000, Elkan 2001). 트리 계열은 class_weight가 나무 구조를 바꾸므로 탐색 공간에 넣어 안쪽에서 비교한다. 로지스틱·SVM·MLP도 넣되 이론상 문턱과 동치라 결과에 차이가 적을 것으로 본다.
- 점수(연속값): 확률을 내는 모델은 양성 확률, SVM은 결정함수, 규칙은 ±특징값. 문턱은 이 점수 위에서 고른다.

## 6. 하드웨어 비용 (모델별 계산식)

예산은 파라미터 4 KB, 추론당 곱셈 1만 회, 가중치 8비트·누산 16비트, 곱셈기 시분할 1개다. 비용은 폴드마다 최종 모델에서 재고 50폴드 중앙값을 보고한다.

| 모델 | 파라미터 바이트 | 곱셈 수 | 비고 |
|---|---|---|---|
| rule | 2 (문턱 1개 16b) | 0 | 비교기 1 |
| dtree | 내부 노드 × 3 (특징 번호 1 + 문턱 16b) + 잎 × 1 | 0 | 비교기만 |
| logreg | (특징 수 + 1) × 1 | 특징 수 | 스케일 상수 흡수 후 |
| rf / gboost | 전 트리 내부 노드 × 3 + 잎 × 1 (gboost는 잎 × 2, 16b 잎 값) | 0 (gboost는 잎 값 덧셈만) | 트리 수 × 깊이가 지배 |
| svm_rbf | 서포트벡터 수 × 특징 수 + 계수 | 서포트벡터 수 × 특징 수 + exp | 예산 밖 |
| mlp | Σ(입력 × 은닉 + 은닉) | 같음 | 시그모이드 근사 필요 |

**크기 사다리.** 성능 최대와 예산 안, 두 설정을 낸다. 주 실행이 끝난 뒤 각 폴드의 최종 특징·손잡이는 고정하고 크기만 바꿔 바깥 고리를 다시 돈다(안쪽 탐색이 없어 값싸다).

- dtree: depth {1,2,3,4} (탐색 최고값과 별개로).
- rf: (trees, depth) ∈ {(4,3),(8,3),(8,4),(16,4),(32,4),(64,6)}.
- gboost: (iter, depth) ∈ {(8,3),(8,4),(16,4),(32,4),(64,4)}.
- mlp: hidden {(2),(4),(8)}.
- logreg, rule, svm: 사다리 없음(비용이 특징 수로 결정되거나 예산 밖).

사다리 값은 Shoaran 2018의 칩(8트리 × 깊이 4)을 중심으로 잡았다.

## 7. 실행 방식

- 채점기·분할·절차는 한 벌이고, 모델마다 탐색 공간과 비용식만 따로 등록한다.
- 실행 순서는 싼 모델부터다. rule → dtree → logreg → rf → gboost → svm_rbf → mlp, 모델마다 30초·60초 순. 결과는 모델·창마다 즉시 저장한다.
- 병렬은 바깥 폴드 단위(코어 8개)다. 손잡이는 탐색 코드가 고르고 사람이 손대지 않는다. 실행 중에 코드를 고치면 절차 고정 원칙과 충돌하기 때문이다.
- 저장하는 것: 에폭별 점수와 N별 경보, 폴드별 손잡이·특징·문턱·비용, pooled 지표·신뢰구간·N별 표, 사람별 표, 크기 사다리 결과.
- 30초 대 60초: 같은 모델·같은 절차·같은 정답으로 나란히 비교한다. 60초 창에서는 30초짜리 사건이 앞뒤 각성 30초와 한 창에 섞여 희석된다는 점을 해석에 넣는다.

## 8. 사후 확인 실험

주 실행과 별개로 확인한 것들이다. 절차를 바꾸지 않았고, 결과를 보고 규칙을 고치지 않았다. 전부 탐색 후 결과다.

**A. 상한별 표는 모델 비교에 쓰면 안 된다.** 모델마다 헛경보 예산을 실제로 쓰는 정도가 달라서다. 상한 4회/h에서 규칙은 2.85회만 쓰고 멈췄고 로지스틱은 3.70회를 썼다. 그래서 0.26 대 0.37로 벌어져 보였지만, 같은 헛경보 3.7회에서 재면 0.35 대 0.38이다. **모델 비교는 FROC 곡선에서 같은 헛경보끼리 읽고**, 상한별 표는 "이 절차를 칩에 그대로 넣으면 실제로 이렇게 된다"로만 읽는다.

**B. 1-SE 규칙 대신 안쪽 AUC 최고 세트로 돌려 봤다.** 특징이 1개에서 2개로 늘지만 쓸 구간(헛경보 1~4회/h)에서 오히려 낮거나 거의 같다. 로지스틱 30초 기준 0.199→0.169(@1), 0.262→0.246(@2), 0.402→0.404(@4). **1-SE 규칙을 유지한다.** "성능 최대가 먼저 아닌가"라는 물음에 대한 실측 답이다.

**C. 안쪽 점수를 AUC로 둔 것은 유지한다.** 전원 pooled AUC 순위가 사건 민감도 순위와 일치했다(로지스틱 0.597 > 규칙 0.558 > 트리 0.547, 사건 민감도도 같은 순서). 부분 AUC(max_fpr=0.4)로 바꿔도 순위가 같다. 사건 지표를 안쪽에 직접 쓰는 것은 문턱 훑기가 AUC보다 580배 느려(24.3초 대 42 ms) 창 하나당 4~5시간이 더 들어 불가능하다.
  - 단, 결과 보고의 "창 AUC(사람 평균)"는 오해를 만든다. 사람별 AUC는 사람마다 다른 문턱을 허용하는 셈이라 낙관적이다. 칩은 공통 문턱 하나를 쓰므로 **pooled AUC를 함께 싣는다.** 규칙 모델은 0.618(사람별) 대 0.558(pooled)로 격차가 크고 로지스틱은 0.615 대 0.597로 작다.

**D. 더 강한 개인화는 전부 손해였다.** 로지스틱 30초 점수에 사람별 기준선을 추가로 씌워 비교했다. 이 표는 추세 비교용 FROC 곡선 보간값이다(첫 행의 정확값은 0.199 / 0.262 / 0.402).

| 방식 | @1 | @2 | @4 | 커버리지 |
|---|---|---|---|---|
| 현재 (첫 3분 기준선, 특징 단계) | 0.194 | 0.263 | 0.404 | 1.00 |
| 점수에 3분 기준선 추가 | 0.162 | 0.228 | 0.309 | 0.97 |
| 점수에 10분 기준선 추가 | 0.098 | 0.170 | 0.268 | 0.92 |
| 점수에 20분 기준선 추가 | 0.086 | 0.185 | 0.290 | 0.83 |
| 점수에 누적 기준선(계속 갱신) | 0.066 | 0.124 | 0.212 | 0.92 |

이유: (1) 사람별 z점수는 모든 사람의 점수 분포를 같게 만들어, 2시간 내내 각성이던 42·49번에게도 같은 비율로 경보를 낸다. 사람 간 졸음 정도의 차이라는 진짜 신호가 지워진다. (2) 이미 `mean_rb`가 개인 기준선 비율이라 중복이다. (3) 누적 기준선은 계속 졸린 사람의 기준선이 졸음 쪽으로 끌려가 경보가 멈춘다.
  - **개인화 자체가 무용한 것은 아니다.** 모델이 후보 11개 중 50폴드 전부 `mean_rb`를 고른 것이 개인화가 듣는다는 직접 증거다. 지금 수준(특징 단계의 첫 3분 비율)이 이미 충분하고 더 얹으면 손해라는 뜻이다.
  - Fujiwara 2019식 **사람별 모델**(각성 데이터로 개인 이상탐지기 학습)은 이 실험이 다루지 않았다. 배제할 수 없으나 칩에 사람별 학습을 넣는 문제라 후속 과제다.

**E. 랜덤포레스트는 졌고, 크기를 줄여도 성적이 같다.** 같은 헛경보에서 모든 모델 중 꼴찌(@4에서 0.282, 로지스틱 0.402)이고 파라미터가 44,926 B로 예산 4 KB의 11배다. 탐색이 나무 100~200그루·깊이 무제한을 골랐는데 학습 49명을 외운 것이다. 크기 사다리에서는 나무 8그루(220 B)가 나무 200그루와 같은 AUC를 낸다. Kundinger 2020의 LOSO에서 RF가 깊이 1 트리에 진 것과 같은 현상이다.

**F. 모든 표는 헛경보를 정확히 맞춘 뒤 계산한다.** FROC 곡선에서 헛경보 2.0 지점을 보간한 값과, 실제 문턱을 적용해 재채점한 값은 조금 다르다. 그 문턱에서 헛경보가 정확히 2.00이 아니기 때문이다(30초 2.03, 60초 1.99, 로지스틱 30초 0.265 대 0.262). 그래서 표는 전부 헛경보가 목표값이 되는 문턱을 찾아 계산하고, 곡선 보간값은 그림 설명에만 쓴다.

**G. 칩 방식 기준선으로도 성적이 같다.** 주 실행의 기준선은 첫 3분 창 평균들의 평균이고, 칩은 좋은 1분 창 3개의 ΣRR÷N(창 길이 무관, 라벨 무관)으로 기준선을 만든다. 이 실험은 첫 3분 창이 모두 좋다고 보고 첫 3분 ΣRR÷N으로 돌렸다. 칩 방식 `mean_rb` 열을 특징 표에 더하고 로지스틱 60초만 같은 절차로 다시 돌렸다. 두 기준선의 사람별 차이는 중앙값 0.3%, 32번 5.4%, 26번 2.4%인데 성적은 오차 안에서 같다.

| 로지스틱 60초 | @2 사건 | 창 | 깊은 | @4 사건 | 창 | 깊은 | pooled AUC |
|---|---|---|---|---|---|---|---|
| 주 실행 (창 평균의 평균) | 0.265 | 0.225 | 0.456 | 0.413 | 0.368 | 0.633 | 0.599 |
| **칩 방식 (ΣRR÷N)** | 0.261 | 0.217 | 0.456 | 0.406 | 0.355 | 0.633 | 0.588 |

특징 선택 결과도 같다(46폴드 `mean_rb` 단독, 4폴드 `sd12` 추가 → 46/3). 사람별 AUC는 46폴드에서 완전히 같다. 기준선을 상수배 하면 그 사람 안의 순위가 안 바뀌기 때문이다. 28번만 0.40→0.71로 뛰었는데 그 폴드의 특징 선택이 2개→1개로 바뀐 것이고 사건이 1건뿐이라 의미 없다. 정수 판정은 칩 방식(ΣRR÷N) 기준선을 쓰고 정수 정답지도 그것으로 만든다. 결과 보고의 대표 숫자는 주 실행 값이다.

## 9. 한계와 남은 것

- 헛경보는 30초 에폭 판정으로 센 값이다. 칩은 5초마다 판정하며, 5초 판정을 모두 세면 헛경보 덩어리는 칩 재현 기준 4.28회/h로 에폭 채점(3.94회/h)보다 조금 많다. 실제로 울리는 횟수는 경보 간격 규칙이 정하며 깨어 있을 때 시간당 26번이다.
- 정수 판정에 넣는 문턱은 50명 전체로 학습한 모델에서 나오므로 교차검증된 값이 아니다.
- 졸음 판정 성능의 외부 데이터셋 검증은 하지 않았다(WildPPG는 졸음 라벨이 없어 이마 PPG 전이만 확인했다). 이 문서의 점수는 전부 MPD-DF 안의 점수다.
- 규칙 모델의 상한별 표는 약간 불리하다. 안쪽 5묶음이 서로 다른 특징을 고르면 OOF 점수 단위가 섞여 문턱 선택이 흐려진다. 로지스틱에는 없는 문제이고 결론에 영향 없다.

## 10. 최종 결정

| 항목 | 결정 | 근거 |
|---|---|---|
| 모델 | **로지스틱 회귀, 특징 1개 `mean_rb`** | 헛경보 2·4회/h에서 10개 조합 중 1위. 파라미터 2 B, 곱셈 1회 |
| 실질 판정 | `mean_rb ≥ T` 한 줄 | 특징이 1개면 로지스틱은 단조 함수라 문턱 규칙과 같다. 폴드별 C(0.001×37, 0.003×7, 100×6)와 class_weight(28:22)가 제각각인데 성적이 같다 → **칩에 들어가는 파라미터는 T 하나뿐** |
| 창 길이 | **60초** | 아래 표. 사건 민감도는 동률, 창 민감도·커버율은 60초가 일관되게 높다. 졸음 구간 안에서 경보가 켜져 있는 비율(창 민감도)이 60초에서 높다. 회로 차이는 신호처리 블록의 5초 누산기 6벌(12벌 대 6벌) |
| 동작점 | **헛경보 4회/시간.** 칩에는 이 문턱 하나만 넣고, 2회/시간은 참고용으로 싣는다 | 놓침 방지를 우선한다. 4회 문턱이 폴드 간 안정(규칙 모델 원값 기준 중앙값 +9.8%, 사분위 +9.4~+10.3%)이고 2회는 최대 +222%인 폴드가 있어 불안정하다. 적중률 0.5 권고선은 4회에서 0.44로 밑돌지만, 실차 기저율(시간당 0.044건)에서는 어느 동작점이든 무너지므로 판별 기준으로 약하다 |
| 채점 | 사건 민감도와 창 민감도 **둘 다 주 지표**, 잡은 사건 안 커버율 병기, 정확도 미기재 | 11절 7·8 |
| 데이터패스 | 판정식에 필요한 심박 재료는 **N, ΣRR 둘**이고, 이마 PPG 창 품질을 거르는 탈락 박동 수를 더해 셋이다 | 창 평균 RR과 기준선 평균 RR의 비를 교차 곱셈으로 비교하면 나눗셈 없이 판정마다 곱셈 몇 번으로 끝난다 |
| 뺀 것 | RBF SVM, 소형 MLP | 표 데이터 벤치마크 1위 RF가 예산 11배를 쓰고도 꼴찌 → 같은 계열 더 무거운 비교선은 생략 |

**최종 수치 (로지스틱 60초, 헛경보를 정확히 맞춘 뒤 계산)**

| 헛경보 | 사건 민감도 | 창 민감도 | 잡은 사건 안 커버율 | 깊은 사건(피로2+) | 적중률 |
|---|---|---|---|---|---|
| **4회/h (주)** | **0.413 [0.28–0.53]** | **0.368** | 1.00 | **0.633 [0.48–0.80]** | 0.44 |
| 2회/h (참고) | 0.265 | 0.225 | 1.00 | 0.456 | 0.50 |
| 1회/h | 0.190 | 0.143 | 1.00 | 0.311 | 0.57 |

괄호는 피험자 부트스트랩 95% 구간. 법정 기준(EU 2021/1341: KSS 8 이상 경보, 평균 민감도 40% 초과, 90% 신뢰구간 하한 20% 초과)과 비교하는 값은 깊은 사건 칸이다. 4회/h에서 0.633, 95% 구간 하한 0.48로 두 수치 모두 기준보다 높다(95% 하한은 90% 하한보다 보수적이다). "규정 통과"라고는 쓰지 않는다(pooled vs 피험자 평균, 시뮬레이터, KSS 8↔피로2 등가 미증명).

**창 길이 비교 (로지스틱, 헛경보 정확히 일치)**

| 목표 헛경보 | 창 | 사건 민감도 | 창 민감도 | 커버율 | 깊은 사건 |
|---|---|---|---|---|---|
| 2회/h | 30초 / 60초 | 0.262 / 0.265 | 0.198 / **0.225** | 0.82 / **1.00** | **0.478** / 0.456 |
| 4회/h | 30초 / 60초 | 0.402 / 0.413 | 0.314 / **0.368** | 0.73 / **1.00** | **0.667** / 0.633 |

60초가 창 민감도와 커버율에서 일관되게 앞선다. 창이 길어 값이 안정돼 문턱 근처에서 덜 깜빡이기 때문이다. 깊은 사건만 30초가 조금 높은데 신뢰구간이 겹친다.

**전체 순위 (헛경보 2회/h 사건 민감도, 30초 / 60초)**: 로지스틱 0.262 / 0.265 (2 B) > 규칙 0.212 / 0.188 (2 B) ≈ 얕은 트리 0.212 / 0.181 (137 / 69 B) > 랜덤포레스트 0.156 / 0.206 (45 KB) ≈ 부스팅 0.144 / 0.188 (11 / 7 KB). 크기 사다리에서는 작을수록 나았다. 깊이 1 트리(5 B) 0.255가 제약 없는 트리(137 B) 0.213보다 높고, 나무 4그루(108 B) 0.212가 200그루(45 KB) 0.160보다 높다.

## 11. 예상 질문과 답

발표·질의에서 나올 질문과, 실측이나 문헌으로 확인한 답이다.

1. **"돌아가며 채점하면 결국 학습되는 것 아닌가?"** 아니다. 회차마다 모델을 새로 만들고 버린다. 시험 사람은 학습·손잡이·특징·문턱·스케일 상수 전 과정에서 빠진다(겹친 교차검증, Varma & Simon 2006). 흔히 쓰는 `train_test_split` + `StratifiedKFold`와 같은 구조이며 행 대신 사람 단위로 자른 것뿐이다. 바깥 결과를 보고 절차를 고치면 시험지를 본 것이므로 절차를 먼저 고정했고, 사후 실험은 전부 "탐색 후"로 표시했다. 데이터셋 자체에 대한 의존은 교차검증으로 못 재며 외부 데이터셋만이 답이다.
2. **"졸음인데 90%는 나와야 하지 않나? 문헌은?"** 90%대 논문은 같은 사람을 학습·시험에 섞은 것이다(Kundinger 97→79%, Persson 85→44%, 10-fold가 LOSO보다 F1 최대 +0.57). 사람을 분리한 심박 단독 결과는 2016~2026 어느 논문도 높은 특이도에서 0.6을 넘지 못했다. Kundinger의 79%도 F2 0.17로 "전부 비졸음"과 같은 수준이었다. EU 규정이 합격선을 40%로 둔 것 자체가 난이도의 증거다.
3. **"특징 하나로 함수를 만드니 당연히 낮은 것 아닌가?"** 로지스틱 30초, 헛경보 2회/h에서 특징 11개 전체(0.210), 최고 세트 2개(0.246), 1개(0.262)로 실측했더니 많을수록 낮았다. 14개 전부 + 학습=시험 반칙 상한도 AUC 0.647. 원인은 신호다. 졸음이 만드는 `mean_rb` 변화 1.3% 대 같은 사람 각성 중 흔들림 4.0% → 신호대잡음 0.33 → 이론 AUC 0.59, 실측 0.60. 47명 중 33명에서 방향이 맞고 14명은 반대라 어떤 모델로도 못 잡는다. 로지스틱은 손실이 볼록해 "못 찾은 것"은 원리상 없다.
4. **"샘플링 주파수를 높이면 되나?"** 아니다. Hejjel & Roth 2004: 평균 심박 오차는 샘플링 간격 1~10 ms 전 구간에서 0.1% 미만(우리 효과 1.3%의 10분의 1 이하). 주파수가 문제인 SDNN·RMSSD는 쓰지 않는다. 병목은 측정이 아니라 생리다.
5. **"심전도로 배웠는데 이마 광센서면 더 낮아지나?"** 고른 특징에 한해 거의 아니다. 광센서 간격 = 심전도 간격 + 맥파 전달 시간의 변화인데, 창 평균에서 중간 항이 상쇄되고 비율에서 다시 상쇄된다. RMSSD였다면 크게 망가졌을 것이다. 나빠지는 곳은 정확도가 아니라 움직임에 의한 커버리지다. 이마 광센서로의 전이는 흉골 ECG와 이마 PPG를 함께 기록한 WildPPG로 따로 확인했고, 박동을 많이 버린 창을 거르는 기준선·창 품질 규칙을 그 결과로 정했다.
6. **"Fujiwara식 개인화가 좋아 보이는데, 칩에서 되나? 과적합은?"** 칩에서 된다(누적 평균·표준편차뿐). 누출 없이 검증도 된다(손잡이는 남에게서, 기준선은 앞 N분 가정). 그러나 점수에 개인 기준선을 더 씌운 세 변형(고정 3·10·20분, 누적)이 전부 손해였다(8절 D). 사람별 이상탐지 모델 자체는 후속 과제다.
7. **"사건 단위는 계속 졸린 걸 못 세는 것 아닌가? 발작과 다르지 않나?"** 맞다. 졸음은 연속 상태이고 사건은 30초 해상도의 산물이라 any-overlap은 관대하다(NEDC 저자들도 인정). 그래서 창 민감도와 잡은 사건 안 커버율을 같은 표에 싣는다. 3분 초과 사건은 잡았다고 세어도 커버율 0.55(30초 창)였고, 60초 창에서는 1.00으로 올라간다.
8. **"1분 30초 졸았으면 판정마다 각각 울려야 하지 않나? 운전자가 경보를 끌 수도 있다."** 모델은 창마다 독립 판정한다. 칩은 첫 졸림 판정에서 바로 경보를 내고, 졸림이 이어지면 30초마다 다시 낸다. 판정 하나가 60초 창을 보아 연달아 나온 판정은 55초가 같은 데이터라, 같은 증거로 연달아 울리지 않도록 창의 절반을 간격으로 둔 것이다. 첫 경보를 늦추지 않으므로 이력과 다르다. 이 요구를 재는 지표가 창 민감도라 주 지표로 올렸다. 이력(hysteresis)은 증거 없이 경보를 유지하는 것이라 넣지 않는다(시험해 보니 창 민감도 0.196→0.257로 올랐지만 원칙과 충돌한다).
9. **"헛경보 상한의 근거는?"** 법(EU 2021/1341)은 민감도 바닥(40%)만 두고 헛경보 수치는 없다. 인간공학은 적중률 0.5 아래면 진짜 경보도 무시된다고 한다(Manzey 그룹, Wickens & Dixon 0.70 교차점). 두 기준이 동시에 맞는 점은 2회/h였으나, 놓침 방지 우선 원칙과 문턱 안정성으로 4회/h를 칩에 넣고 2회/h는 참고로 싣는다(10절).
10. **"KSS 8이 우리 라벨에서 어디인가?"** 피로2("뚜렷하거나 퍼진 알파파", 논문 표현 "drowsy state")가 가장 방어 가능한 대응이다. Kaida 2006에서 눈 뜬 알파 파워가 KSS 8~9 구간에서만 유의해진다. 그러나 규정에도 문헌에도 KSS 8의 뇌파 정의는 없고, Kaida는 8·9를 묶었으며 관계가 선형이라 급변점이 없고, MPD-DF는 KSS를 재지 않았다. "등가"가 아니라 "정성적 정합성"으로만 쓴다. 피로1은 규정이 허용하는 KSS 7 선택 경고에 대응한다.
11. **"성능 최고를 먼저 뽑고 비용은 나중에 비교해야 하지 않나?"** 주 실행은 하드웨어 제약 없이 돌았다(RF가 45 KB를 자유롭게 골랐다). 크기 사다리가 제약판이다. 결과는 작을수록 나았다.
12. **"대상은 화물 운전자인데 데이터 조건이 맞나?"** 오후 1~4시 단조 주행은 장거리 화물 운전의 실제 위험 시간대와 맞아 오히려 좋다. 남는 간극은 시속 35 km(유로 NCAP은 50 km/h 이상 요구)와 수면 박탈 없음이다. 수면 부족 졸음은 단조 피로와 심박 신호가 다를 수 있으며(Lu 2022가 지표 엇갈림의 원인으로 지목), 이 차이는 이 데이터로 잴 수 없어 한계로 남는다.
13. **"표마다 숫자가 다르지 않나?"** 곡선 보간값과 실제 문턱 재채점값은 조금 다르다. 표는 전부 헛경보를 정확히 맞춘 뒤 계산하고 곡선 보간값은 그림 설명에만 쓴다(8절 F).
14. **"SVM·MLP는 왜 안 했나?"** 벤치마크 1위(RF)가 졌으므로 2위(RBF SVM)가 이길 이유가 없고, MLP는 LOSO에서 43%까지 추락한 전례가 있다. 시간 비용(창당 2~3시간)도 커서 생략했다.
15. **"특징 하나만 쓰면 데이터패스도 바뀌나?"** 바뀐다. HRV 특징용으로 생각했던 누산기 다섯 개(N, ΣRR, ΣRR², Σd, Σd²) 중 N과 ΣRR만 필요하고, 곱셈기 두 개가 빠진다. 여기에 이마 PPG의 창 품질을 거르는 탈락 박동 수가 더해져 판정 블록이 받는 재료는 셋이다.
16. **"칩에서는 얼마인가?"** 칩에 들어간 정수 문턱 하나(`T_FIX` 1086)와 창 품질·기준선 규칙으로 50명을 다시 채점하면 사건 민감도 0.379, 깊은 사건 0.567, 헛경보 3.94회/h다. 위 LOSO 값보다 낮은 것은 사람마다 다른 폴드 문턱 대신 하나의 정수 문턱을 쓰고 창 품질 규칙이 더해졌기 때문이다. 문턱을 정한 데이터로 다시 채점한 값이라 새 사람에 대한 성능이 아니라, 구현이 모델을 재현한다는 확인이다.
