albertjihyun/Busan-IDEC/docs/background-trucking.md

# 화물차 운전자 타깃 — 자료조사

설계의 타깃(장거리 사업용 화물차 운전자)을 승용차 연구의 전이가 아니라 상용차 자체 근거로 세우기 위한 팩트 시트다. [T-n]은 이 문서의 참고번호다.

---

## 1. 사고 통계 — "최대 피해 집단"의 근거

| 사실 | 수치 | 출처 |
|---|---|---|
| 화물차 졸음·주시태만 사망자 비중 | 전체 고속도로 사망자의 **82%** | 한국도로공사, 2026.3 [T1] |
| 고속도로 사망사고 중 화물차 관련 | 약 **50%**, 대부분 졸음운전 | 한국교통연구원 [T2] |
| 2월 화물차 사망사고 원인 | **76%**가 졸음·주시태만 (히터 + 장거리 야간) | 한국도로공사, 2026.2 [T3] |
| 1월 화물차 사망사고 | 100km 이상 장거리 운행 중 **65%**, 원인 **전부** 졸음·주시태만 | 한국도로공사, 2026.1 [T4] |
| 심야 시간대(0~6시) 사망 비중 | **43%** | 한국도로공사, 2026.1 [T4] |
| 대구·경북 고속도로 2025 | 졸음·주시태만 **83%**, 화물차·야간·맑은 날 집중 | 대구MBC, 2026.6 [T5] |

**핵심 문장**: 고속도로 졸음 사망의 대부분은 화물차이고, 그 사고는 장거리·야간에 집중된다.

## 2. 운행·근로 실태 — "졸음이 생기는 조건이 일상"의 근거

| 사실 | 수치 | 출처 |
|---|---|---|
| 일평균 근로시간 | **12.8시간** (운행 8.3h + 운행 외 4.5h) | 한국교통연구원 2019 하반기 동향 [T6] |
| 하루 운전 12시간 이상 응답 | 화물차 기사 1,433명 중 **54.5%** | 시사IN DTG 탐사보도, 2022 [T7] |
| 과로 운전자(일 12.5h 초과) | 사업용 화물차의 **3.4% ≈ 약 1만 5천 대** | 한국교통연구원 / 시사IN [T2][T7] |
| 벌크시멘트트레일러 일평균 운행 | **604km** | 한국교통연구원 [T6] |
| 최소 휴게시간 미준수율 | **52.3%** (연속운전 평균 2.3h, 휴게 15.4분) | 대한교통학회지, 2026 [T8] |
| 수면 | 교대근무·차량 취침이 불면장애 유발 | 하이닥 연구 리포트, 2026.6 [T9] |

**핵심 문장**: 절반 이상이 하루 12시간 넘게 운전하고, 절반 이상이 법정 최소 휴게도 못 지킨다.

## 3. 규제 환경 — "제도가 졸음을 못 막는다"의 근거

- **국내에는 운전시간 총량 규제(HOS)가 없다.** 유일한 시간 규제는 "연속운전 2시간 후 15분 휴게"뿐이며, 하루 최대 근로시간 상한과 최소 일일 휴식 보장 제도가 없다 [T8]. 미국·EU는 HOS로 운전시간 상한과 휴식을 강제한다.
- 2017년 정부 '사업용 차량 졸음운전 방지대책': 연속휴식 8→10시간, 첨단안전장치 장착 확대, 광역버스 3,000대 차로이탈경고장치 장착 [T10]. → 정부가 사업용 차량 졸음을 정책 문제로 인식한 선례.
- 20톤 이상 화물차·11m 초과 승합차에 차로이탈경고(LDWS)·비상자동제동(AEBS) 장착 의무화 (2017년 출시분부터) [T11].
- EU GSR: DDAW 2024.7, ADDW 2026.7부터 트럭·버스 포함 전 신차 의무 [T29].

**핵심 문장**: 휴식을 강제할 제도가 없으니, 운전자 상태를 직접 감시하는 장치가 실질적 안전망이 된다. 이 문장이 "왜 감시 장치인가"를 시간 규제 대안으로 위치시킨다.

## 4. ADAS·자율주행 도입 현황 — "미래 위험"이 아니라 "현재 진행형"

**왜 화물차에 자율주행이 들어올 수밖에 없는가 — 구조적 이유 네 가지**

(1) **운전자 공급이 무너지고 있다.** 화물차 운전자 평균 연령은 일반화물 56.4세, 개별화물 61.4세, 용달 66.2세이고, 50대 이상 비중이 2017년 54.8%에서 2022년 62.2%로 상승했다. 세대교체가 사실상 멈췄고 신규 진입자 평균 연령도 48세다 [T25]. 전 산업 근로자 평균 43.4세와 대비된다. 화물 운전자 부족 비율은 2026년 20%에서 2033년 30%로 치솟을 전망이며, 유럽 40만 명·미국 8만 명이 부족한 세계적 현상이다 [T26]. 한국교통연구원은 이를 "물류 공급망의 지속 가능성"을 위협하는 구조적 리스크로 규정했다 [T25][T27]. → 사람을 구할 수 없으니 자율주행이 "유력 대안"으로 부상 [T26].

(2) **고속도로는 자율주행에 가장 쉬운 환경이다.** 장거리 화물운송 구간의 98%가 고속도로 [T18]. 반복 노선, 신호·보행자 없음, 정속. 도심 승용차보다 기술적으로 먼저 풀리는 영역이라 해외에서는 이미 상용화 단계: 미국 오로라가 무인 주행 40만km·10개 노선, 스웨덴 아인라이드가 운전석 없는 레벨4 전기 화물차 상용 서비스 운영 [T26]. 국내도 라이드플럭스가 최초 유상 화물운송 허가(송파–진천 정기 운송), 마스오토가 부산항 트레일러 자율주행 개시 [T26][T16].

(3) **경제성이 즉시 나온다.** 레벨2 코파일럿 시범 운영에서 유류비 10% 이상 절감, 미국 장거리 기준 차량당 월 200만 원 [T17]. 인건비 대체 이전에 연비만으로 구독료가 정당화됨 → 사업자가 도입할 동기.

(4) **정부가 밀고 있다.** 2027년 레벨4 상용화 로드맵, 실증특례와 유상운송 허가 제도 [T20][T16]. 광주 전역 실증도시 지정.

**그리고 도입 형태가 우리 문제를 정확히 만든다.**
- 화물차는 '이중 고령화' 상태: 15년 이상 노후 차량이 2026년 75만 대로 3년간 5.6만 대 순증, 신차 교체 지연 [T28]. → 신차 교체가 아니라 **기존 차량에 후장착하는 구독형 레벨2**(코파일럿 방식)가 현실적 보급 경로. 오늘의 기사가 오늘의 트럭에서 레벨2와 함께 운전하게 된다.
- 레벨3는 제도 미비로 당분간 불가 [T19] → 운전자가 감독 의무를 지는 레벨2 구간이 완전 무인화(2028 목표)까지 길게 이어진다.
- 운전자 부족은 남은 기사의 장시간 노동을 심화시키고(2절), 고령 운전자는 졸음에 더 취약하다. 여기에 "차가 대신 달리는 동안 감독만 하는" 레벨2가 얹힌다. → 졸음 위험이 세 겹으로 쌓이는 집단.

**국내 장거리 트럭에 레벨2가 이미 상품으로 나왔다.**
- 마스오토, 국내 최초 트레일러 자율주행 유상운송 개시 (2026.7, 국토부 실증특례·교통안전공단 평가 통과, 부산항 노선) [T16].
- 같은 회사가 **구독형 대형트럭 레벨2 자율주행 솔루션 '코파일럿'** 출시. 고속도로·간선도로 중심 장거리 운행 지원, "하루 최대 11시간 운행하는 장거리 트럭 운전자의 피로도를 낮춘다"고 명시 [T17]. 현대 엑시언트 기반, 기존 차량에 구독형으로 적용 → 신차 교체 없이 보급 가능.
- **레벨2로 출시하는 이유**: 레벨3는 보험·운전자 책임·개입 기준 제도가 미비 [T19]. → 운전자가 감독 의무를 지는 레벨2 상태가 상당 기간 지속됨 = 우리가 문제로 정의한 "감독자→승객" 위험이 정확히 이 구간에서 발생.
- 수입 트럭(MAN 등)에 트래픽 잼 어시스트(자동 조향) 이미 탑재 [T12]. 타타대우–라이드플럭스 레벨2+ 양산 협약 (2026.9) [T13].

**논리 정리**: 승용차 연구를 트럭에 전이시킬 필요가 없어졌다. 국내 장거리 트럭용 레벨2가 구독 상품으로 존재하고, 제도상 레벨2가 오래 유지되며, 운행 구간의 98%가 그 기능이 켜지는 고속도로다. "화물차 기사가 자율주행을 쓰나?" → "장거리 트럭용 레벨2 구독 서비스가 2026년 출시됐고, 완전 무인화 전까지 운전자 감독이 필수인 레벨2 구간이 길게 이어진다."

**주의**: 보급률 수치는 여전히 없음. "출시됐다·확산 중이다"까지만 쓰고 "대부분 쓴다"고 쓰지 않는다.

## 5. 보급 채널 선례 — "B2B/B2G 대량 보급"의 근거

- 서울시: 사업용 화물·특수차 차로이탈경고장치 설치비 **80% 지원** [T14].
- 국토부·교통안전공단: 고령 택시·소형화물 3,260대 페달오조작 방지장치 보급 (2026) [T15]. "사업용 차량은 운행시간이 길고 종사자 고령화 비율이 높아 선제 대응 필요"라는 정부 논리.
- → 사업용 차량 안전장치는 정부 보조 + 운수사 단위 도입이 표준 경로. 개인 구매가 아니라 **기관 단위 대량 보급**이 현실적 채널이며, 이것이 저단가·저전력·장기 배터리 요구사항의 근거.

## 6. 새벽배송 종사자 — 검토 후 제외

새벽배송 종사자는 대상에서 제외한다. 판정이 운행 시작 직후 심박을 기준선으로 삼아 "출발 시 각성"을 전제하는데, 새벽배송은 야간 출발이 기본이다. 출발부터 졸린 경우가 흔하다는 보고가 있다(야간 근무 뒤 장거리 통근 운전자의 19%[T30], 교대 근무 트럭 운전자 첫 야간의 37.8%가 KSS 7 이상[T31]). 아래는 검토한 근거다.

**사회적 필요는 크다.**
- 2025.11 제주 새벽배송 기사(30대) 새벽 2시 1톤 트럭 전신주 충돌 사망. 저녁 7시~다음날 6시 30분, 하루 11시간 30분, 주 6일 69시간(야간 할증 환산 83.4시간) 근무. 졸음운전 추정 [T21].
- 퀵플렉스 배송기사 679명 설문: 야간 배송의 어려움으로 피로 71.9%, 교통사고 위험 62.3%, **졸음운전 34.1%** [T22].
- 2020년 이후 해당 플랫폼 배송·물류 노동자 사망 25명, 그중 17명 과로사 인정·추정 [T22]. 야간배송 산재 증가 속도가 주간의 2배 이상 [T23].
- 규모: 전담 배송기사 약 2만 3천 명, 전체 택배 종사자 약 10만 명 [T23]. 고용부 실태조사: 77%가 야간 3회전 배송, 하루 평균 9.5시간 [T24].
- 사회적 의제화: 새벽배송 제한 논의 진행 중 [T23].

**그러나 신호 조건이 맞지 않는다.**
- 도심 배송은 정차·하차·상자 운반의 반복. 물리적 활동이 심박을 올려 HRV 특징이 졸음이 아닌 운동 부하를 반영하게 됨. 60초 연속 주행 윈도우 확보도 어려움.
- 모션 아티팩트가 극심(차에서 내리고 타기, 상자 들기). 움직임 구간을 걸러내면 판정할 수 있는 창이 크게 줄어듦.
- 자율주행 논리와 무관(도심 1톤 배송차에 레벨2 적용 없음).

**결론**: 타깃은 장거리 화물(연속 고속도로 주행 = 최적 신호 조건)이다. 새벽배송은 사회적 필요는 크지만 야간 출발로 기준선 전제가 깨지고 도심 구간의 신호 조건도 맞지 않아 대상에서 뺀다.

**표기**: 특정 기업명은 쓰지 않는다. "새벽배송 종사자", "야간 택배 노동자"로.

## 7. 찾지 못한 것

- 국내 물류·운수사의 운전자 모니터링(DMS) 도입 사례 — 해외는 Seeing Machines Guardian 등 플릿 도입 사례가 있으나 국내 사례 미확인
- 화물차 레벨2 보급률 수치
- 착용형 기기에 대한 운전자 수용성 조사 (헤어밴드/모자 형태 관련)

---

## 참고 (T)

[T1] 부산일보, "한국도로공사, AI·빅데이터로 지킨 안전… 고속도로 사망자 역대 최저", 2026.3.30. https://www.busan.com/view/busan/view.php?code=2026033016342758526
[T2] 한국교통연구원 카드뉴스, "화물차 운전시간 총량제한이 필요한 이유". https://www.koti.re.kr/user/bbs/cardnewsView.do?bbs_no=67068
[T3] 문화일보, "매년 2월, 고속도로 교통사고 사망자 상반기 최다", 2026.2.2. https://www.munhwa.com/article/11565360
[T4] 문화일보, "1월 고속도로 운전 시 화물차 사고, 심야시간대 교통사고 각별한 주의 당부", 2026.1.6. https://www.munhwa.com/article/11558945
[T5] 대구MBC, "고속도로 사망 사고 80% 이상은 이것 때문", 2026.6.7. https://dgmbc.com/NewsArticle/842837
[T6] 한국교통연구원 2019 하반기 화물운송시장 동향 (월간노동법률 인용). https://www.worklaw.co.kr/main2022/view/view.asp?bi_pidx=32404
[T7] 시사IN, "요일도 밤낮도 없는 화물차 기사의 24시간 365일 노동 [DTG 데이터 탐사보도②]", 2022.11. https://www.sisain.co.kr/news/articleView.html?idxno=48966
[T8] 대한교통학회지, "우리나라 사업용 화물차 운전자의 최소 휴게시간 준수와 위험운전행동", 2026. https://www.jkst.or.kr/articles/pdf/BqBe/kst-2026-044-02-10.pdf
[T9] 하이닥, "잠 못 이루는 화물트럭 기사 — 교대근무·차량 취침이 불면장애 키운다", 2026.6. https://news.hidoc.co.kr/news/articleView.html?idxno=63635
[T10] 로컬세계, "국토부, 버스·화물차 운전자 휴식시간 보장 법개정 추진 — 사업용 차량 졸음운전 방지대책", 2017.7. https://localsegye.co.kr/news/view/1065592300623588
[T11] 해사신문, "국토부, 대형 화물차 첨단안전장치 장착 의무화", 2016.4. http://www.haesanews.com/news/articleView.html?idxno=73724
[T12] 상용차매거진, "국산·수입산 트럭 안전사양 총정리", 2024.5. https://www.cvinfo.com/news/articleView.html?idxno=27209
[T13] 인더스트리뉴스, "타타대우모빌리티, 레벨2+ 상용차 자율주행 개발", 2026.9. https://www.industrynews.co.kr/news/articleView.html?idxno=85634
[T14] 서울시, "졸음운전 예방 차로이탈경고장치 설치비 80% 지원", 2020.3. https://news.seoul.go.kr/traffic/archives/503010
[T15] 정책브리핑, "페달 오조작 방지장치 보급 시작 — 만 65세 이상 택시·화물차 우선", 2026.2. https://www.korea.kr/news/policyNewsView.do?newsId=148959338
[T16] 이데일리, "마스오토, 국내 최초 트레일러 자율주행…2028년 한·미 화물운송 완전 무인화", 2026.7.1. https://edaily.co.kr/News/Read?mediaCodeNo=257&newsId=04027846645510256
[T17] 아시아투데이, "박일수 마스오토 대표 '2028년 장거리 화물운송 완전 무인화 달성'" (코파일럿 레벨2 구독형), 2026.7.1. https://www.asiatoday.co.kr/kn/view.php?key=20260701010000579
[T18] 베타뉴스, "마스오토, 국내 트레일러 자율주행 시작" (장거리 구간 98% 고속도로), 2026.7.1. https://www.betanews.net/article/view/beta202607010036
[T19] 테크42, "마스오토, 한·미 수출 물류 전 구간 자율주행 트레일러 도입" (레벨2 출시 이유), 2026.7. https://www.tech42.co.kr/
[T20] 정책브리핑, "2027년 레벨4 완전자율주행 상용화…AI 모빌리티 혁신 로드맵 가동", 2026.3. https://www.korea.kr/news/policyNewsView.do?newsId=148960802
[T21] KBC, "제주 쿠팡 새벽배송 노동자, 6일 연속 야간에 하루 11시간 30분씩 근무", 2025.11. https://news.ikbc.co.kr/article/view/kbc202511120075
[T22] 한국일보, "쿠팡 새벽배송 논란, 야간 택배기사 과로·고용불안 실태와 건강권 쟁점", 2025.11. https://www.hankookilbo.com/News/Read/A2025111314350001935
[T23] 경향신문, "3년간 36명··· 주간배송 노동자 사망률이 더 높다? 팩트체크", 2025.11. https://www.khan.co.kr/article/202511290700011
[T24] 뉴스1, "쿠팡 택배기사 77% 야간 3회전 배송…하루 평균 9.5시간 일해" (고용부 실태조사), 2025.1. https://www.news1.kr/economy/trend/5666253
[T25] 상용차신문, "화물운송시장 '청년' 운전자가 안보인다…신규 진입자 평균 48세" (한국교통연구원 2023 보고서 분석), 2026.2. https://www.cvinfo.com/news/articleView.html?idxno=30631
[T26] 이데일리, "트럭운전자 고령화·구인난 해법…초기투자 지원·제도정비 서둘러야" (한양대 김남욱 교수), 2026.7. https://edaily.co.kr/News/Read?mediaCodeNo=257&newsId=01820406645519768
[T27] 한국교통연구원, "화물자동차운송시장 운전자 일자리 전망과 대응 방안", 2023. https://www.koti.re.kr/user/bbs/majorRschView.do?bbs_no=14
[T28] 상용차매거진, "화물운송시장 '이중 고령화' 운전자도 늙고 차량도 늙는다", 2026.8. https://www.cvinfo.com/news/articleView.html?idxno=31576
[T29] Smart Eye, "What to know about DDAW and ADDW systems". https://smarteye.se/blog/what-to-know-about-ddaw-and-addw-systems/
[T30] "Sleepiness, Long Distance Commuting and Night Work as Predictors of Driving Performance". https://www.ncbi.nlm.nih.gov/pmc/articles/PMC3448712/
[T31] "Sleepiness, sleep, and use of sleepiness countermeasures in shift-working long-haul truck drivers". https://pubmed.ncbi.nlm.nih.gov/25957933/
