albertjihyun/Busan-IDEC/docs/data-notes.md

# 데이터셋 조사

실제 파일을 열어 확인한 내용만 적는다. 논문·문서에만 있고 파일에서 확인하지 못한 것은 그렇다고 표시한다.

| 데이터셋 | 역할 | 신호 | 졸음 라벨 |
|---|---|---|---|
| MPD-DF | 학습과 평가 | ECG 1024 Hz, 50명 | 의사 뇌파 판독 5단계, 30초 에폭 |
| WildPPG | 이마 PPG 전이 검증 | 흉골 ECG + 이마 PPG + 이마 가속도, 16명 | 없음 |
| PPG-DaLiA | ECG↔PPG 비교, 움직임 분석, IMU 규칙 헛울림 확인 | 손목 PPG + 가슴 ECG + 가속도, 15명 | 없음 |

---

## 1. 라벨 시간 해상도와 학습 데이터 선택

판정 주기와 라벨 해상도는 다른 문제다. 칩이 몇 초마다 판정할지는 설계가 정하는 값(60초 창을 5초마다 갱신)이고 데이터와 무관하다. 심박 특징은 RR을 수십 개 모아야 계산되므로 어차피 수십 초 단위이며, 즉각 반응이 필요한 고개 떨굼은 IMU 규칙이 맡는다(학습 데이터가 필요 없다). 라벨 해상도는 학습과 평가할 때만 문제가 된다. 30분 블록 전체에 같은 정답을 붙이면 블록 초반의 각성 구간까지 졸음으로 학습되고, 성능 수치도 그만큼 부정확해진다.

| 데이터셋 | 인원 | 신호 | 라벨 | 라벨 간격 | 접근 |
|---|---|---|---|---|---|
| AdVitam Exp4 | 63 | ECG 1000Hz | KSS 자기보고 | **30분** (블록당 1회) | Zenodo 공개 |
| AdVitam Exp4 (PVT) | 63 | 〃 | 반응시간(객관) | **약 5분** | 〃 |
| MPD-DF | 50 | ECG 1024Hz + EEG | 의사 주석 5단계 | **30초 에폭** | figshare, CC BY 4.0 |
| DD-DB | 10 | ECG 128Hz | 본인 버튼(졸릴 때) | 이벤트 시각 | Dryad |
| UL-DD | 19 | 심박·EDA·SpO2 | KSS | 4분 | 저자 요청 필요 |
| PPG-DaLiA | 15 | PPG + ECG | 졸음 라벨 없음 | — | UCI 공개 |

MPD-DF의 라벨이 가장 촘촘하다. 수면센터 의사가 EEG 주파수 특성을 보고 30초 에폭 단위로 각성/피로1/피로2/N1/N2의 5단계를 주석했고, 이진(각성 대 피로1 이상)으로 묶어 쓴다. 30초 에폭마다 정답이 붙으므로 학습과 평가를 모두 이 데이터로 한다.

AdVitam Exp4는 수면부족을 실험적으로 조작한 데이터(절반을 6시간 미만으로 재움)이고 자율주행(L3) 감시 상황이라 검토했지만, 자기보고 라벨이 30분에 한 번뿐이고 PVT 반응시간도 5분 간격이라 "언제 졸렸는지"를 평가할 수 없어 쓰지 않는다. DD-DB는 ECG가 128 Hz라 RR을 7.8 ms 단위로밖에 못 잰다. 칩의 ADC는 240 SPS(4.2 ms)다. UL-DD는 4분 간격 KSS로 촘촘하지만 저자 요청이 필요하고, 공개 설명에 원시 파형이 아니라 "심박수"로 적혀 있어 RR을 뽑을 수 있는지 불확실하다.

PPG와 졸음 라벨이 함께 있는 공개 데이터는 없다. 그래서 RR 간격이라는 공통 표현으로 ECG에서 학습하고, PPG 쪽 차이는 WildPPG(이마)와 PPG-DaLiA(손목)로 따로 확인한다.

졸음 라벨과 심박 특징이 표로 정리된 공개 데이터도 찾지 못했다. Kaggle의 졸음 데이터는 대부분 얼굴 영상 또는 뇌파이고, OpenDriver(81명, 4,600시간, ECG 360Hz)는 졸음 라벨이 없다. 특징 표가 있는 HRV 데이터(렘수면행동장애, 수면 연구)는 라벨이 "환자 여부"라 목적이 다르다. 창 길이·봉우리 검출 규칙·PPG 대비 검증을 직접 정해야 하므로 원본 파형에서 특징 표를 만든다.

---

## 2. MPD-DF (학습·평가 데이터)

figshare 28455737, CC BY 4.0. 전체 13.1GB 중 11.9GB가 32채널 뇌파라 쓰지 않는다. 쓰는 것은 PSG EDF 파일(50개, 1.18GB)과 라벨 주석 파일(50개), 설문 xlsx 하나다.

고정형 운전 시뮬레이터에서 2시간 수동 운전(오후 1~4시, 시속 35 km)이고 수면 박탈 조작은 없다. 50명 중 여성 35, 남성 15다. HRV 기저값은 성별 차이가 보고돼 있어 일반화 한계로 적는다. 논문은 "공개 데이터 중 최초의 의사 주석 EEG 기반 피로 라벨"을 내세운다. 뇌파는 정답을 만든 도구이고 모델은 그 결과 숫자만 쓴다.

### 2.1 신호

EDF 헤더를 직접 읽어 확인했다(02번 기준).

| 채널 | 주파수 | 단위 | 범위 |
|---|---|---|---|
| E1-M2, E2-M2 (안전도) | 256 Hz | mV | -1 ~ 1 |
| **ECG** | **1024 Hz** | mV | -2.5 ~ 2.5 |
| Thor (호흡) | 32 Hz | V | -1 ~ 1 |

1초짜리 레코드 7,210개 = 120.2분. 쓰는 채널은 ECG 하나다.

### 2.2 라벨

라벨 파일은 `시각,에폭번호,레벨` 세 열이고, 에폭마다 한 줄이 아니라 상태가 바뀌는 지점만 적혀 있다.

```
14:21:43,1,0     ← 에폭 1부터 레벨 0(각성)
14:33:13,24,1    ← 에폭 24부터 레벨 1(피로1)
14:33:43,25,0    ← 에폭 25부터 다시 각성
```

에폭은 30초 단위다(14:21:43→14:33:13이 690초, 에폭 1→24로 23칸 = 690/30). 다음 전이 전까지 같은 레벨이 유지되므로, 전개하면 30초 해상도의 라벨 배열이 된다.

02번 피험자는 전이 51개, 레벨 0/1/2가 등장하며 시간 비율은 각성 65.5%(75분) / 피로1 28.4%(32.5분) / 피로2 6.1%(7분)였다. 상태가 한 방향으로 넘어가지 않고 계속 오간다.

### 2.3 라벨 50명 집계

에폭 12,531개(104.4시간), 피험자당 240~295 에폭(2시간 전후).

| 라벨 | 에폭 | 시간 | 비율 |
|---|---|---|---|
| 0 각성 | 9,423 | 78.5h | 75.2% |
| 1 피로1 | 2,120 | 17.7h | 16.9% |
| 2 피로2 | 661 | 5.5h | 5.3% |
| 3 N1 | 50 | 0.4h | 0.4% |
| 4 N2 | 10 | 0.1h | 0.1% |
| Severe Artifacts | 248 | 2.1h | 2.0% |
| Signal Abnormality | 19 | 0.2h | 0.2% |

라벨 자리에 숫자가 아니라 품질 표시가 오기도 한다. `Severe Artifacts`, `Signal Abnormality` 두 종류이고 합쳐서 2.1%다. 이 구간은 학습·평가에서 뺀다. 데이터셋 제작자도 신호가 나쁜 구간은 판정하지 않았다는 뜻이라, SQI로 판단을 보류하는 설계의 근거가 된다.

아티팩트는 사람에 따라 편중돼 있다. 05번은 240에폭 중 132개(55%), 47번은 250에폭 중 109개(43.6%)가 아티팩트다. 아티팩트가 있는 나머지 3명은 각각 7.4% 이하다.

남은 구간 기준 이진 비율은 각성 76.8% : 피로 23.2%(약 3.3:1)다.

피험자별 피로 비율 분포(50명):

```
 0~ 9% : ####################  20명
10~19% : #######                7명
20~29% : #######                7명
30~39% : ###                    3명
40~49% : ######                 6명
50~59% : ###                    3명
60~69% : ##                     2명
70~79% : #                      1명
90~99% : #                      1명
```

### 2.4 졸음 사건 통계

목적이 놓침 방지이므로 평가 단위를 에폭이 아니라 연속된 피로 구간 = 사건으로 다시 셌다. 아티팩트 에폭은 사건을 끊는다.

| 항목 | 값 |
|---|---|
| 사건 수 | 445건 (50명, 사람당 8.9건) |
| 길이 중앙값 | 3에폭 = 90초 |
| 길이 평균 | 6.4에폭 = 192초 |
| 1에폭(30초)짜리 | 102건, 22.9% |
| 2에폭 | 83건, 18.7% |
| 3~4에폭 | 89건, 20.0% |
| 5~10에폭 | 116건, 26.1% |
| 11에폭 이상 | 55건, 12.4% |

창 길이별로 "창 내용이 전부 피로인 창"이 하나도 안 생기는 사건: 30초 창 0건, 60초 창 102건(22.9%), 120초 창 238건(53.5%). 60초 이상 창은 짧은 사건을 항상 각성과 섞어 본다. 창 길이를 30초와 60초 두 가지로 모델 비교에 넣은 이유다.

피로1에서 시작한 사건 중 더 깊은 단계(피로2 이상)로 간 것은 90건(20.2%), 피로1에 머물다 각성으로 돌아간 것은 355건(79.8%). 피로1은 "곧 잠든다"의 전조라기보다 "지금 각성도가 낮다"는 현재 상태에 가깝다. 그래서 "졸음 예측"이 아니라 "각성도 저하 감지"라고 쓰고, 깊어진 90건은 조기 감지 평가의 별도 표본으로 쓴다.

사건이 0건인 피험자 2명(42, 49), 1~2건뿐인 피험자 13명.

### 2.5 학습·평가에 반영한 것

정확도만 보고하지 않는다. 전부 "각성"이라 답해도 77%가 나온다. 사건 민감도와 창 민감도를 주 지표로, 시간당 헛경보를 짝으로 보고한다.

불균형 3.3:1은 판정 문턱을 헛경보 기준에 맞춰 정하는 것으로 다룬다.

피험자 단위 분할(LOSO)에 특이 케이스가 있다. 42·49번은 피로 구간이 0이라 그 폴드에서는 민감도를 계산할 수 없고, 22번은 각성 구간이 아예 없어 특이도를 계산할 수 없다. 그래서 폴드별 지표를 평균하지 않고 전체를 모아서(pooled) 계산한다.

5단계 분류는 학습하지 않는다. N1·N2가 합쳐 60에폭(0.5시간)뿐이다. 이진(각성 대 피로1 이상)으로 묶는다.

라벨이 뇌파 판독 기준이라 자기보고 졸음(KSS)과 같은 것을 재는지는 이 데이터로 확인되지 않는다. 논문이 보고한 ECG 기반 모델 성능(F1 0.563)이 피험자 독립 분할에서 나온 것인지도 확인하지 못해 직접 비교하지 않는다.

---

## 3. WildPPG (이마 PPG 전이 검증)

ETH 공개 데이터. 16명, 1명당 12~15시간. 흉골 ECG와 이마 PPG(초록, 128 Hz), 이마 가속도를 같은 시간축에 기록했다. 야외 활동(걷기·등산·일상) 기록이라 운전보다 거칠고, 졸음 라벨은 없다. ECG로 학습한 특징 `mean_rb`가 이마 PPG에서도 같은 값으로 나오는지 비교하는 데 쓴다.

참가자 fex는 ECG가 불량이라 비교에서 뺀다(15명 사용). 착용 직후 20분은 센서가 자리잡기 전이라 뺀다. 빼지 않으면 기준선이 10% 틀어진다. 참가자별 원본 파일(1명당 약 1.1 GB)을 쓴다.

---

## 4. PPG-DaLiA (ECG↔PPG 비교, 움직임 분석)

UCI 495. 15명, 총 37.2시간, 1인 평균 2.5시간. 활동은 앉기·계단·축구·자전거·운전·식사·걷기·일하기다.

사람마다 동기화된 신호 묶음(1.2~1.7GB/명, 손목 PPG·가속도, 가슴 ECG·호흡·가속도, 라벨)과 가슴·손목 장치 원본, 활동 구간 시작 시각(초), 설문(나이·성별·키·몸무게·피부색·운동)이 들어 있다. 표가 아니라 파형 묶음이다.

손목 PPG는 64 Hz, 가슴 ECG는 700 Hz다. 손목 PPG(BVP)는 부호가 반대라 뒤집어 쓴다.

운전 구간은 1인 평균 15.2분(12.8~17.5), 15명 합계 228분이다. 헛경보를 시간당으로 재기엔 짧아 안정 구간까지 함께 쓴다. 손목 측정이라 이마 부위 차이는 이 데이터로 검증되지 않는다.
