albertjihyun/Busan-IDEC/docs/detector-comparison.md

# 봉우리 검출기: 학습 검출기와 칩 검출기

검출기는 신호별로 따로 둔다. 학습(RR 추출, 특징 표, 문턱 `T_FIX` 1086)은 심전도에 학습 검출기를 쓰고, 칩은 이마 PPG에 신호처리 블록의 검출기(칩 검출기, `peak_detector`·`rr_extractor`)를 쓴다. 둘을 잇는 것은 특징 `mean_rb`(60초 창 평균 RR ÷ 기준선 평균 RR)다. 이마 PPG에서 이 연결이 성립하는지는 WildPPG 15명의 같은 시각 흉골 심전도(학습 검출기)와 이마 PPG(칩 검출기)로 확인했다. 창 품질 규칙을 넣은 칩 판정 절차에서 두 `mean_rb`의 차이는 중앙값 −0.1%, 표준편차 1.7%였고, 문턱 1.0605에서 판정 일치율은 97.4%였다.

이 문서는 두 검출기의 규칙과, 같은 데이터에 둘을 모두 돌려 이렇게 나눈 근거를 적는다.

## 1. 두 검출기

| | 학습 검출기 | 칩 검출기 |
|---|---|---|
| 후보 | 올라가다 꺾이는 샘플 | 문턱을 넘은 뒤 40샘플 동안 최댓값 추적 |
| 문턱 | 최근 봉우리 높이 `level`의 3/5. `level`은 확정 봉우리마다 1/8씩 갱신 | 진폭 추정 `spk`(어택 1/4, 릴리즈 1/16)의 0.625, 샘플마다 1/256씩 감쇠, 하한 0.375·spk |
| 확정 | 24샘플 안에 절반 하강 | 문턱 아래로 내려오거나 40샘플 경과 |
| 불응기 | 96샘플(400 ms) | 48샘플(200 ms) + 500 ms 중복맥 가드(하한 0.625·spk) |
| 봉우리 없을 때 | 아무 일도 없음 | 400샘플 넘게 없으면 `spk` 감쇠 |
| RR 탈락 | 72~360, 직전 대비 25% | 같음 + 샘플 누락·모션·signal_ok |
| 탈락 뒤 기준점 | 직전 확정 봉우리 | 직전 확정 봉우리. 단 `rr < RR_MIN` 탈락이면 갱신 안 함(3절) |

학습 검출기는 파이썬 정수 참조 구현으로만 있고 칩에는 올리지 않는다. RR 탈락 범위(72~360, 25%)와 5초 블록·60초 창 누산 구조는 두 쪽이 같다.

## 2. 학습 검출기 규칙

한 샘플씩 처리하고 정수 연산만 쓴다.

**입력 조건.** 아날로그 프론트엔드(AC 결합 0.16 Hz, 저역 16 Hz)를 지난 ADC 값을 흉내 낸 신호다. AC 결합 덕에 0 중심이고, 0 중심이 아니면 상대 문턱이 깨진다. 심전도에는 고역 0.16 Hz와 저역 40 Hz를 건다. 저역을 16 Hz로 걸면 R파가 깎여 T파에 붙는 사람이 있어서이고, 이 왜곡은 PPG에서는 생기지 않는다.

**봉우리 규칙.** 상태는 `level`(최근 봉우리 높이), `last_peak`(직전 봉우리 위치), 대기 중 후보 셋(`cand_i`, `cand_v`, `cand_min`)뿐이다.

| 단계 | 조건 | 상수 |
|---|---|---|
| 1. 후보 | 올라가다 꺾이는 샘플. `x[i-1] > x[i]`이고 직전에 상승 중 | |
| 2. 문턱 | `후보높이 × 5 ≥ level × 3` | THR = 3/5 |
| 3. 불응기 | 직전 봉우리로부터 96샘플(0.4초) 이상 | REFRACT = 96 |
| 4. 급하강 | 후보 뒤 24샘플(0.1초) 안에 `(후보높이 − 최솟값) × 2 ≥ 후보높이` 이면 확정. 24샘플 안에 안 떨어지면 버림. 더 높은 값이 오면 후보 교체 | DROP_WIN = 24, DROP = 1/2 |
| 5. 적응 | 확정 시 `level += (후보높이 − level) >>> 3` | LEVEL_SHIFT = 3 |

`level` 초기값은 0이다. 첫 봉우리부터 적응하므로 신호 이득에 무관하고, 시동 후 1초 안에 수렴한다. 확정은 후보보다 최대 24샘플 늦다. 확정 시점에 `지연 = i − cand_i`를 같이 내면 봉우리 위치를 복원할 수 있다. RR은 봉우리 위치 사이 샘플 수다.

**SQI 규칙.** 확정된 봉우리마다 RR을 계산하고 통과 여부를 정한다.

| 조건 | 상수 |
|---|---|
| 72 ≤ RR ≤ 360 (0.3~1.5초) | RR_MIN, RR_MAX |
| `\|RR − last_rr\| × 4 ≤ last_rr` (25% 이내) | JUMP = 1/4 |
| 첫 RR은 기준이 없으므로 탈락 | |

`last_rr`은 급변 판정과 무관하게 범위 안인 마지막 RR로 갱신한다. 급변 탈락한 RR을 기준에서 빼면 오검출 하나가 그 뒤 정상 RR 전부를 탈락시키는 연쇄가 생기기 때문이다.

**누산 규칙.** SQI 통과 RR만 더한다. `d = RR − rr_prev`이고 `rr_prev`는 직전에 누산된 RR로, 블록 경계를 넘어 이어진다. 첫 RR은 d 항에 넣지 않는다. 그래서 창 안의 d 개수는 N과 거의 같고 RMSSD² = Σd²/N으로 정의한다.

**왜 이 숫자인가.** MPD-DF 50명 심전도에 아날로그 프론트엔드 대역을 흉내 내고 240 Hz로 낮춰서 정했다. 불응기 72(0.3초)면 T파를 잡는 사람이 있었고(26번, 오검출 50%), 96(0.4초)으로 4%가 됐다. 광센서의 dicrotic notch도 봉우리 뒤 0.3~0.4초라 같은 값이 맞을 것으로 보며, 최대 심박 150이면 운전에 충분하다. 문턱은 3/5가 2/3보다 안전하다. 2/3은 진폭이 들쭉날쭉한 사람(47번)에서 놓침이 46%로 커졌고, 광센서는 접촉 압력으로 진폭이 더 흔들린다. 급변 25%는 정상 심박 변화(95%가 7% 이내)보다 여유롭다. 급하강 조건은 R파가 뾰족한 심전도에서는 항상 통과하므로 심전도로는 숫자를 정할 수 없었다. 하드웨어 팀이 측정한 광센서 파형에서 급한 하강이 100 ms 안에 일어나는 것을 보고 24샘플·1/2로 잡았다.

**결과.** 50명 pooled 놓침 1.0%, 오검출 3.2%. 사람별 중앙값은 놓침 0.33%, 오검출 0.41%, SQI 통과 99.9%다. 정답으로 쓴 neurokit2가 느린 심박에서 가짜 봉우리를 끼워 넣는 사례가 있어(38번) 실제 오차는 이보다 낮다. 240 Hz 샘플링이 RR에 주는 오차는 표준편차 2.2 ms로 RR 자체 변동(40~100 ms)의 2~5%이고, 보간은 필요 없다.

## 3. 칩 검출기의 상수와 `prev_idx` 규칙

칩 검출기의 상수 9개는 동결한다: REFRACTORY 48, DECAY_SH 8, THR_MIN 6, SEARCH_LEN 40, NOPEAK_LIM 400, GUARD_LEN 120, RR_MIN 72, RR_MAX 360, REJ_LIM 3. 이 문서와 이마 PPG 전이 검증의 수치는 이 값에서 나온 것이라, 하나라도 바꾸면 PPG 쪽 검증을 다시 해야 한다.

`rr_extractor`가 탈락한 봉우리를 다음 RR의 기준점으로 쓰면, 가짜 봉우리(RR < 72로 탈락)가 잡혔을 때 그다음 진짜 RR이 가짜 봉우리부터 재져 짧게 통과한다. 칩 검출기의 합성 자극 트레이스로 세면 탈락 56개 중 짧은 것 52개, 통과 RR 평균 196.2샘플(73.4 bpm) 대 되돌린 평균 238.0(60.5 bpm, 자극값)으로 −17.6%다. 심박을 중앙값으로 보면 드러나지 않지만 판정은 평균을 쓴다.

그래서 칩 검출기는 탈락 이유가 `rr < RR_MIN`이면 `prev_idx`와 `last_amp`를 갱신하지 않는다(가짜 봉우리 무시). `rr > RR_MAX`면 놓친 박동이므로 갱신한다. 이 규칙을 넣은 칩 검출기의 합성 자극 결과는 통과 RR 평균 238.4샘플 = 60.40 bpm(자극 60 bpm)이다. 200 bpm을 넘는 심박에서는 두 배 RR(< 144)이 RR_MAX에 안 걸려 절반 심박으로 보고되지만, 운전 범위(40에서 200 bpm) 밖이라 그대로 둔다.

## 4. 심전도 50명 (MPD-DF, neurokit 정답)

입력은 둘 다 AFE 대역(0.16~40 Hz) 심전도 → 240 Hz → ±2047 코드다. 채점은 봉우리 일치(±12샘플)와, 비겹침 60초 창마다 "통과 RR 평균 ÷ 정답 RR 평균 − 1"(판정식 `sum_rr60/n60`이 쓰는 값)이다. 첫 3분을 빼고 5,989창.

| 변형 | 놓침 | 오검출 | 창 편향 중앙값 | 편향 표준편차 | \|편향\|>1% 창 | 커버리지 |
|---|---|---|---|---|---|---|
| 학습 검출기 | 1.02% | 3.18% | 0.00% | 7.5% | 27.6% | 99.5% |
| 칩 검출기 전체 체인(8 Hz LPF 포함, `prev_idx` 규칙 없음) | 25.6% | 52.5% | −22.8% | 15.7% | 76.0% | 99.9% |
| 칩 검출기, LPF 없음, `prev_idx` 규칙 없음 | 0.85% | 13.4% | 0.00% | 11.8% | 36.4% | 99.9% |
| 칩 검출기, LPF 없음 | 0.85% | 13.4% | 0.00% | 9.2% | 27.7% | 99.9% |

8 Hz LPF 행은 심전도에서만 생기는 왜곡이다. R파(40 Hz 성분)를 T파 크기로 깎아 T파를 봉우리로 잡는다. 심전도에 저역 40 Hz를 쓰는 이유와 같고, PPG에는 없는 문제라 이 행은 비교에서 제외한다. 같은 대역이면 둘 다 박동을 거의 다 잡고 평균 편향도 없다. 칩 검출기의 오검출 13%는 24·26번(T파 이중 검출 45·53%)에 몰려 있고, `prev_idx` 규칙이 없으면 그 둘의 창 편향이 −28%·−21%다. 규칙을 넣으면 편향 표준편차가 11.8 → 9.2%, |편향|>1% 창이 36 → 28%로 학습 검출기와 같은 수준이 된다.

## 5. 이마 PPG (WildPPG, 참가자 2명 × 12시간)

이마 초록 채널 128 Hz → AFE 흉내(0.16~16 Hz) → 240 Hz → 하루 전체 2초 창 p-p 중앙값이 238코드가 되게 스케일 → ±2047. 정답은 흉골 심전도의 neurokit R 봉우리다. 야외 활동 기록이라 움직임이 많다. 정지창은 이마 가속도 표준편차 하위 절반이다.

| 참가자 | 극성 | 검출기 | 놓침 | 오검출 | 창 편향 중앙 | 커버리지 | 정지창 편향 | 정지창 커버리지 |
|---|---|---|---|---|---|---|---|---|
| an0 | − | 학습 검출기 | 99.9% | 78% | +6.9% | **0%** | −10.3% | **0%** |
| an0 | − | 학습 검출기 DROP_WIN=48 | 99.7% | 66% | +49.9% | 0% | +6.6% | 0% |
| an0 | − | 칩 검출기, `prev_idx` 규칙 없음 | 32.4% | 27.7% | −2.17% | 81% | −2.49% | 88% |
| an0 | − | 칩 검출기 | 32.4% | 27.7% | **−0.12%** | 83% | **−0.29%** | 89% |
| e61 | − | 학습 검출기 | 99.7% | 68% | +18.8% | **0%** | +53.4% | **0%** |
| e61 | − | 칩 검출기, `prev_idx` 규칙 없음 | 38.5% | 28.6% | −1.80% | 75% | −1.40% | 79% |
| e61 | − | 칩 검출기 | 38.5% | 28.6% | **−0.12%** | 77% | **−0.13%** | 81% |

극성 +는 둘 다 더 나빴다(an0 칩 검출기 놓침 44.8%, 학습 검출기 100%). 하드웨어 팀이 이마 실측으로 `PPG_INVERT=0`을 고른 것과 방향이 같다.

**학습 검출기는 이마 PPG에서 하루 종일 멈춰 있다.** 6.3분에 첫 포화(±2047) 아티팩트가 들어오고, `level`이 1,200~1,800으로 올라간 뒤 내려오지 않는다. 실제 맥파 p-p는 150~350이라 문턱(3/5·level ≈ 900)을 넘지 못하고, 시간당 확정 봉우리가 2~14개다.

```
시간별 확정 봉우리: [84, 4, 7, 4, 5, 6, 14, 2, 7, 2, 3, 10, 13]
시간별 level      : [0, 1267, 1487, 1545, 1677, 1691, 1733, 1765, 1626, 1788, 1765, 1599, 1255]
시간별 맥파 p-p   : [154, 170, 218, 160, 224, 251, 350, 192, 209, 247, 275, 312, 325]
```

`level`이 확정 봉우리에서만 갱신되는 구조라 큰 아티팩트 뒤에 스스로 복구할 길이 없다. 칩 검출기의 "400샘플 넘게 봉우리가 없으면 `spk` 감쇠"가 바로 이 상황을 위한 장치다. 심전도 2시간과 손목 PPG 5분에는 포화 아티팩트가 없어서 이 문제가 드러나지 않는다.

신호가 좋은 10분 정지 구간만 따로 보면(an0, 594분):

| | 놓침 | 오검출 |
|---|---|---|
| 학습 검출기 | 18.6% | 1.8% |
| 칩 검출기 | 6.2% | 5.0% |

락업이 없어도 학습 검출기는 5개 중 1개를 놓친다. "24샘플 안에 절반 하강" 확정 규칙이 이마 맥파의 넓은 봉우리(반치폭 100샘플 넘음)에서 걸리지 않기 때문이다. 놓친 박동은 RR을 두 배로 만들어 평균을 올린다.

## 6. 칩에 칩 검출기를 쓰는 이유

| 기준 | 학습 검출기 | 칩 검출기 |
|---|---|---|
| 심전도 50명, 평균 RR 편향 | 없음 | 없음 |
| 심전도 50명, 오검출 | 3.2% | 13.4% (두 사람의 T파) |
| 이마 PPG 실환경, 커버리지 | 0% (락업) | 77~83% |
| 이마 PPG 실환경, 평균 RR 편향 | 측정 불가 | −0.1% (정지창 −0.1~−0.3%) |
| 이마 PPG 정지 10분, 놓침 | 18.6% | 6.2% |
| 150 bpm 위 | 놓침(불응기 400 ms) | 잡음 |
| 진폭 변화 추종 | 느림(봉우리마다 1/8) | 빠름 |

학습 검출기는 심전도에서 더 깨끗하지만 실제 이마 신호에서는 첫 아티팩트 뒤 회복하지 못하고, 회복해도 넓은 봉우리를 놓친다. 둘 다 구조 문제라 상수 하나로 고쳐지지 않는다(DROP_WIN=48 행). 칩 검출기는 이마에서 동작하고, `prev_idx` 규칙이 있으면 평균 RR 편향이 판정에 무시할 수준(0.1~0.3%)이다.

실환경 놓침 32~38%는 야외 활동 데이터라 운전보다 훨씬 거친 조건이고, 정지창에서도 커버리지는 89%다. 이것은 검출기가 아니라 신호 문제이고 `n60 < 30` hold와 창 품질 규칙(`3 × bad60 ≤ n60`)이 받는다.

## 7. 문턱을 학습 검출기 RR로 잡는 이유

칩 검출기를 심전도에 돌려 RR·특징 표를 만들고 문턱을 잡으면 결과가 무너진다. 50명을 한데 모은 계산에서 이미 차이가 난다.

| | 학습 검출기 표 | 칩 검출기 표 |
|---|---|---|
| 50명: T(4회/h) | 1.06017 | 1.06720 |
| 50명: 사건·창 민감도 | 0.385 · 0.359 | 0.345 · 0.296 |
| 50명: T_FIX(10비트, 4회/h 이하 최소) | 1086 | 1093 |
| 24·26번 제외: T | 1.05668 | 1.06016 |
| 24·26번 제외: 사건·창 | 0.409 · 0.376 | 0.393 · 0.329 |

24·26번의 심전도는 T파가 커서 칩 검출기가 T파를 봉우리로 잡는다. T파는 R 뒤 약 300 ms(72샘플 이상)라 짧은 탈락이 아니고 급변 검사에서 탈락한다. 급변 탈락은 `prev_idx`를 갱신하므로 3절 규칙이 먹지 않고, 다음 진짜 RR이 짧게 통과한다(26번 mean_rb 차이 표준편차 78%, 창 편향 −22%). 급변 탈락이면서 새 봉우리 높이가 기준 봉우리의 절반 미만이면 가짜로 보는 진폭 규칙도 26번에는 듣지 않는다. T파 높이가 R의 79%(중앙값)라 절반 미만인 가짜 봉우리가 5%뿐이다. PPG의 중복맥(주봉우리의 15~30%)은 이 규칙으로 갈리겠지만 두 사람의 문제는 풀지 못한다.

같은 문턱 1.06017에서 칩 검출기 표의 헛경보는 330회(학습 검출기 표 300회)이고, 늘어난 30회 중 24·26번 몫은 13회다. 두 사람이 원인의 절반이 안 되고, 나머지는 칩 검출기가 심전도에서 전반적으로 조금 더 시끄러운 탓이다. 두 사람을 빼는 것은 이상치 제거가 아니라 "검출기가 거기서 시끄럽다"는 이유로 데이터를 빼는 것이라 근거가 서지 않는다.

사람을 분리한 교차검증에서는 차이가 더 크게 드러난다(로지스틱 60초).

| 4회/h 동작점 | 학습 검출기 표 | 칩 검출기 표 |
|---|---|---|
| 사건 민감도 | 0.401 | **0.237** |
| 창 민감도 | 0.340 | 0.093 |
| 실측 헛경보 | 3.71/h | **4.80/h** (상한 초과) |
| 창 AUC | 0.600 | 0.566 |

규칙 모델은 4회/h 문턱이 시험 피험자에서 6.65/h를 냈다. 학습 폴드에서 고른 문턱이 시험 피험자에게 옮겨가지 않는다는 뜻이다. 헛경보가 는 사람은 08·16·49·26·34·11·38번이고, 칩 검출기의 심전도 오검출률을 사람별로 보면 11명이 21~58%(06·16·18·24·25·26·30·32·36·39·47)다. 전부 T파를 봉우리로 잡는 사람들이다. 50명을 한데 모은 계산(위 표 0.345)은 사람 간 차이를 한 문턱으로 눌러 이것을 가린다.

따라서 PPG용 검출기에 심전도를 넣는 대리 시험은 50명 중 11명에서 무효다. "학습 검출기 = 칩 검출기"는 신호가 같을 때만 뜻이 있다. 학습은 심전도, 칩은 PPG이므로 검출기 코드를 같게 하면 심전도에만 있는 잡음(T파)을 학습에 넣게 된다. 그래서 문턱은 학습 검출기 RR로 잡고 `T_FIX` 1086을 쓴다.

## 8. 검출기가 달라도 되는 이유

`mean_rb`는 60초 평균 RR의 비율이다. 첫째, 봉우리 위치의 일정한 지연은 봉우리 사이 간격을 재는 빼기에서 사라진다. 둘째, 박동별 흔들림(실측 11 ms)은 70박 평균에서 0.2% 이하로 줄어든다. 셋째, 남는 것은 놓침·오검출뿐인데 이것은 각 신호에서 따로 재면 된다. 학습 검출기는 심전도에서 놓침 1.0%·오검출 3.2%이고, 칩 검출기는 이마 PPG에서 평균 RR 편향 −0.1%다. 두 조건을 같은 사람에게서 함께 본 것이 WildPPG 전이 검증이고, 그 결과는 첫머리에 적었다.

남는 약점이 하나 있다. 칩 검출기에서 급변 탈락 경로로 짧은 RR이 통과하는 기전(7절의 T파)이 PPG에서는 중복맥(250에서 350 ms)에 해당한다. 이마 PPG 2명에서는 규칙 적용 후 편향이 −0.1%라 드물지만, 중복맥이 큰 사람에게서는 같은 편향이 날 수 있다. 근본 대책은 진폭 기준 구분이다.
