albertjihyun/Busan-IDEC/docs/feature-rationale.md

# 특징 후보 선정 근거

모델 입력으로 쓸 특징 후보를 어떤 기준으로 골랐고 무엇을 왜 뺐는지 적는다. 후보 중 최종 모델에 남은 것은 7절 끝에 적었다.

## 1. 원칙

특징을 생리학적 직관으로 고르지 않는다. 이유는 둘이다.

- 졸음 상태에서 어느 지표가 어느 방향으로 변하는지 선행 연구가 합의하지 못했다. 운전 피로 연구 18편을 종합한 문헌고찰[L]의 결론은 "심박 감소는 6편 중 5편에서 일관되나, 다른 HRV 지표는 증가와 감소가 모두 보고되어 방향이 일관되지 않다"이다.
- 지도학습이므로 방향과 가중치는 모델이 데이터에서 찾는다. 우리가 보장할 것은 "정보가 있을 수 있는 후보를 빠뜨리지 않았고, 우리 조건에서 계산이 성립하지 않는 후보를 미리 걸렀다"는 것이다.

절차는 (1) 국제 표준에 정의된 지표 전체를 후보 공간으로 놓고 (2) 우리 조건 세 가지로 거른 뒤 (3) 남은 후보를 전부 계산해 모델 비교에서 데이터로 선택한다. 방향을 미리 주장하지 않는 것이 이 방법론의 명분이다. 문헌이 갈린다는 사실이 약점이 아니라 "그래서 우리가 확인했다"의 근거가 된다.

## 2. 거르는 기준

칩이 받는 정보는 PPG 파형(240 SPS)과 IMU 3축뿐이다. 학습 데이터는 ECG다. 여기서 기준 세 개가 나온다.

| 기준 | 내용 | 왜 지금 걸어야 하나 |
|---|---|---|
| A. 공통성 | ECG와 PPG 양쪽에 같은 정의로 존재하는 양이어야 한다 | 한쪽에만 있으면 ECG로 배운 것을 PPG로 옮길 수 없고, 두 신호의 차이도 잴 수 없다 |
| B. 창 길이 | 30초(비교용으로 60초) 안에서 계산이 성립해야 한다 | 채점 주기가 30초이고 창은 30초와 60초 중에서 고른다. 긴 기록이 필요한 지표는 값이 나와도 의미가 없다 |
| C. 샘플링 | 4.17 ms 시간 분해능에서 오차가 허용 범위여야 한다 | ADC가 240 SPS다 |

회로 비용과 구현 시간은 후보를 거르는 기준이 아니다. PC에서 계산하는 것은 공짜이므로 후보를 넓게 두고, 모델 비교에서 성능과 함께 비용을 보고 줄인다.

## 3. 후보 공간

파형 하나에서 뽑을 수 있는 것을 갈래별로 늘어놓는다. 라이브러리(neurokit2)는 HRV 지표만 91개를 제공한다.

| 갈래 | 지표 | 필요한 것 |
|---|---|---|
| 박동 타이밍, 시간영역 | mean NN, median NN, SDNN, RMSSD, SDSD, pNN50, pNN20, NN 범위, 분위수, CVNN, CVSD | 박동 시각만 |
| 박동 타이밍, 기하학적 | HRV 삼각지수, TINN | 간격 히스토그램 |
| 박동 타이밍, 주파수영역 | ULF, VLF, LF, HF, LF/HF, 정규화 LF·HF | 보간 + 스펙트럼 |
| 박동 타이밍, 비선형 | 포인카레 SD1·SD2·비율·면적, DFA α1·α2, 근사·표본 엔트로피, 심박 비대칭·분절화 | 긴 시계열 |
| 맥파 모양 | 진폭, 상승 시간, 펄스 폭, dicrotic notch 위치·깊이, 수축기·이완기 면적비, 2차 미분 지표 | PPG 파형 자체 |
| 변조 | 호흡수, 호흡성 부정맥 | 진폭·주기 변조 |

## 4. 근거 문헌이 각 기준에 답한 것

### [T] Task Force of the ESC and NASPE, 1996. HRV 표준 문서

Circulation 93(5):1043-1065. 시간영역 지표의 정의(Table 1), 권장 지표, 기록 길이, 샘플링 요건을 정한 문서다. 이 분야 논문이 공통으로 인용한다.

- **권장 시간영역 지표는 넷**: SDNN, HRV 삼각지수, SDANN, RMSSD. 이 중 SDANN은 24시간용, 삼각지수는 "최소 20분, 가급적 24시간"이 필요하며 "현재의 기하학적 방법은 단기 변화 평가에 부적절하다"고 명시. 따라서 짧은 구간에 남는 권장 지표는 **SDNN과 RMSSD**.
- **"RMSSD가 pNN50·NN50보다 선호된다. 통계적 성질이 더 좋기 때문이다."** (Summary and Recommendations)
- "시간영역 방법, 특히 SDNN과 RMSSD는 짧은 기록 조사에 쓸 수 있다."
- 주파수영역: 단기 스펙트럼은 2~5분 기록 기준. VLF는 "단기 기록에서 의심스러운 측정치이므로 피해야 한다".
- 샘플링: "최적 범위는 250~500 Hz 또는 그 이상. 더 낮은 샘플링(어떤 경우든 100 Hz 이상)은 R파 기준점을 다듬는 포물선 보간 알고리즘을 쓸 때만 만족스럽다."

### [H] Hejjel & Roth, 2004. ECG 샘플링 간격과 시간영역 HRV 오차

Physiol Meas 25:1405-1411. 5분 tachogram(375박동)을 1~10 ms로 재표본화해 mean, SDNN, RMSSD, pNN50의 상대 정확도 오차(RAE)를 쟀다. 원본 두 개: 건강인(SDNN 90 ms)과 저변동 심혈관 환자(SDNN 17.7 ms).

| 샘플링 간격 | 건강인 SDNN | 건강인 RMSSD | 저변동 SDNN | 저변동 RMSSD |
|---|---|---|---|---|
| 1 ms | 0.0% | 0.0% | 0.0% | 0.5% |
| 4 ms | 0.0% | 0.0% | 0.5% | 6.5% |
| 10 ms | 0.1% | 0.3% | 2.7% | 30.8% |

- 우리 4.17 ms는 건강한 운전자 기준 오차가 사실상 0이다. 변동이 아주 작은 사람만 RMSSD 오차가 커진다.
- mean RR은 모든 조건에서 오차 0.1% 미만.
- **pNN50**: "정확도와 정밀도가 나쁘다. 저변동 계열에서는 1 ms에서도 신뢰할 수 없다. 따라서 Task Force와 마찬가지로 이 지표를 권장하지 않는다." 이유는 50 ms 문턱 때문에 값이 이산적이라서.
- 결론: "건강한 집단이거나 샘플링 오차보다 훨씬 큰 변화를 재는 경우 더 긴 샘플링 간격도 문제없다."

### [B] Béres & Hejjel, 2021. PPG 최소 샘플링 주파수

Biomed Signal Process Control 68:102589. 건강인 57명의 5분 PPG(1 kHz, 오른쪽 귓불 클립 센서)를 2~500 ms로 데시메이션해 RAE를 쟀다. 합격 기준 RAE 5%.

| 샘플링 간격 | mean 오차 | SDNN 오차 | RMSSD 오차 |
|---|---|---|---|
| 2 ms | 0.00% | 0.17% | 0.50% |
| 5 ms | 0.00% | 0.22% | 0.57% |
| 20 ms | 0.01% | 1.28% | 4.25% |
| 50 ms | 0.02% | 6.61% | 24.2% |

- 우리 4.17 ms는 2와 5 사이. **RMSSD 오차 약 0.5%, SDNN 0.2%.** 보간 없이 합격 기준을 열 배 여유로 통과한다.
- 포인카레: SD1은 20 ms(50 Hz)까지, SD2는 50 ms까지 5% 이내.
- 보간이 필요해지는 건 20 ms보다 성길 때다. 포물선 보간이 3차 스플라인보다 계산이 훨씬 적으면서 효과는 비슷하다.
- 이 논문이 우리 조건과 제일 가깝다. ECG가 아니라 PPG이고, 건강인이다.

### [L] Lu, Sjörs Dahlman, Karlsson, Candefjord, 2022. 운전 피로 HRV 체계적 문헌고찰

Accid Anal Prev 178:106830. 18편.

- 정확도 범위 44~100%. "실험 설계의 핵심 요소 차이"가 원인.
- HR 감소(mean NN 증가)는 6편 중 5편 일치, 1편 유의차 없음. **다른 시간·주파수 지표는 증가와 감소가 모두 보고됨.**
- 갈리는 이유로 제시된 가설: "피로는 부교감을 활성화해 HF를 높이지만, 졸음을 이기려 애쓰는 경우 교감 활성화로 LF가 높아진다. 실도로에서는 시뮬레이터보다 졸음에 저항하려는 의도가 강할 수 있다." 수면 연구에서는 졸린 피험자의 SDNN 증가, 수면부족에서는 VLF·LF 증가가 보고됨. 잠들면서는 HRV 감소.
- LF/HF의 생리학적 근거는 "불분명"하며 교감·부교감 균형으로 해석하는 것이 도전받고 있다.
- **"피험자 독립 모델링과 대규모 실도로 실험에서 성능 저하."** 개인 기준선(Vicente 2016, Persson 2021)이나 개인별 이상 탐지 모델로 개인차에 대응한 연구들이 있다. "개인화 알고리즘이 정확한 HRV 기반 피로 감지의 핵심 요소일 수 있다."
- 향후 방향: 개인화 전략, 시간 의존 모델링, 다른 정보와의 결합.

### [V] Vicente, Laguna, Bartra, Bailón, 2016. HRV 기반 운전 졸음 검출

Med Biol Eng Comput 54:927-937. 학회판은 Computing in Cardiology 2011;38:89-92. 시뮬레이터(수면부족) 2세트와 실도로(전문 운전사, 6시간) 1세트, 외부 관찰자가 1분 단위로 각성/피로/졸음 주석. 5분 창을 1분마다 밀며 LDA로 분류, LOSO.

- **개인 기준선**: "첫 3분의 특징 평균값을 기준선으로 삼아 이후 값에서 뺀다." 라벨을 보지 않고 시간으로 잡은 유일한 선례라 우리가 따른다. 우리 기준선 길이 3분의 출처.
- **직전 대비 변화**: "3분 정규화 외에 직전 1분 값과의 차이도 계산했다." 우리 "직전 창 대비"의 출처. 출력 주기가 1분이라 직전 = 1분 전. 우리는 30초.
- 결과: 상위 특징 5개에 "3분 기준선 대비" 계열이 여러 개 들어갔고(RF3Min, mHR3Max, LF3nuMed), 직전 1분 대비 계열은 하나도 없었다. 기준선 대비는 효과가 있었고 직전 대비는 확인되지 않았다는 뜻으로 읽는다.
- 특징은 시간-주파수 분석(SPWVD)으로 낸 순간 심박·LF·HF·호흡수라 우리 조건(30초, 합계 재료)에는 못 옮긴다. 방법론(기준선·차분)만 가져온다.

### [P] Persson 등, 2021. 실도로 각성 대 수면부족 운전자 분류

IEEE T-ITS. 86명 실도로. 리뷰 [L]의 요약표에 따르면 개인 기준선은 "KSS 5 미만 구간"으로, 즉 **졸림 자기보고가 낮은 구간을 골라** 잡았다. 라벨을 보고 기준선을 고르는 방식은 사후 분석에서만 가능하고 칩은 할 수 없으므로 우리는 채택하지 않는다. 선례가 있었고 배치 조건 때문에 안 썼다고 적는다. 원문은 미확보.

### 요약만 확인한 것 (원문 미확보)

- **초단기 타당성, 3,387명(PREVEND, PLOS One 2015)**: 10초 RMSSD도 5분 값과 r 0.85, 30초면 0.93. SDNN은 30초에서 r 0.86. 결론 "RMSSD는 10초, SDNN은 최소 30초".
- **초단기 규범 연구 비판적 리뷰(PMC7710683)**: 더 엄격한 기준(편향 통제)으로 SDNN·RMSSD·pNN50은 60초, LF·SD1·SD2·TINN은 90초, HF·LF/HF·DFA·엔트로피는 180초 이상 필요. 기존 연구 11편 중 8편이 상관계수만 써서 편향을 통제하지 않았다고 비판.
- **손목 PPG 초단기 HRV(PMC9611389)**: 5명, 손목 PPG 대 가슴 ECG. 90초에서 mean·median·SDNN·pNN50은 유지, RMSSD는 탈락. 단 SD1(= RMSSD/√2)은 유지로 나와 자기모순이므로 표본 5명의 통계 잡음으로 본다. 방향만 참고.
- **수면부족 HRV 메타분석(PMC12394884)**: RCT 11편 549명. RMSSD 감소(SMD −0.24, 유의), LF/HF 증가(+1.47, 유의), LF 증가(+0.39, 유의), SDNN·HF 유의차 없음. 수면부족은 교감 우세 방향. [L]의 두 상태 가설과 맞는다.

## 5. 우리 데이터가 어느 상태인가

[L]의 가설을 우리 데이터에 대면 이렇다.

| 데이터 | 조작 | 예상 방향 |
|---|---|---|
| MPD-DF (학습) | 수면부족 없음, 시뮬레이터 2시간 단조 운전, 뇌파 판정 피로 | 졸음 진행 → 부교감 우세 → HR 감소, 변동 증가 |
| 수면부족 조건 (예: 절반을 6시간 미만 수면으로 데려온 실험) | 수면부족 | 교감 우세 성분이 섞임 |

수면부족 조건에서는 반대 방향이 나올 수 있고, 그건 모델이 틀려서가 아니라 상태가 달라서일 수 있다. 이 조건의 데이터로는 검증하지 않았다. 실도로 운전자가 졸음에 저항하는 경우도 교감 방향이라 시뮬레이터 학습의 한계로 적는다.

## 6. 판정

| 지표 | A 공통성 | B 30초 | C 4.17 ms | 판정 |
|---|---|---|---|---|
| mean NN | 예 | 예. 가장 안정 | 오차 0.1% 미만 [H][B] | 후보. [L]에서 유일하게 방향 일치 |
| median NN | 예 | 예 | 예 | 파이썬 비교에만. **회로 후보 제외.** 합계 재료로 만들 수 없다 |
| SDNN | 예 | 경계. 30초 r 0.86, 엄격 기준 60초 | 0.2% [B] | 후보 |
| RMSSD | 예 | 예. 10초에서도 유효 | 0.5% [B] | 후보. 손목 PPG에서 약하다는 보고 있음 |
| SDSD | 예 | 예 | RMSSD와 같음 | 후보. RMSSD와 상관 매우 높음, 모델 비교에서 정리 |
| CVNN, CVSD | 예 | 위와 같음 | 위와 같음 | 후보. 개인 기저 심박을 일부 상쇄 |
| SD2, SD1/SD2 | 예 | SD2 50 ms까지 안정 [B] | 예 | 후보. SD1은 RMSSD/√2라 정보 없음, 제외 |
| 개인 기준선 대비 | 예 | 예 | 예 | 후보. [L]이 개인화를 핵심으로 지목, 방식은 [V](첫 3분, 라벨 무관) |
| 직전 창 대비 변화 | 예 | 예 | 예 | 후보. [L]이 시간 의존 모델링 권장, [V]가 직전 1분 차이로 구현(효과는 미확인) |
| pNN50, pNN20 | 예 | 값이 0으로 깔릴 위험 | **나쁨** [H] | **제외.** [T][H] 모두 비권장 |
| NN 범위(max−min) | 예 | 예 | 예 | 제외. 박동 하나에 휘둘리고 근거 없음 |
| 삼각지수, TINN | 예 | **불가.** 최소 20분 [T] | | 제외 |
| SDANN, SDNN index | 예 | **불가.** 24시간용 [T] | | 제외 |
| VLF, ULF | 예 | **불가.** "피하라" [T] | | 제외 |
| LF, LF/HF | 예 | **불가.** 2~5분 [T], 90~180초 | | 제외. 생리학적 근거도 의심 [L] |
| HF | 예 | 90초 이상 필요 | | 제외. 60초 창에서도 모자란다 |
| DFA, 엔트로피 | 예 | 120~240초 필요 | | 제외. 회로 비용도 큼 |
| 맥파 모양 전부 | **아니오.** ECG에 대응물 없음 | | | 제외 |
| 호흡수 | 아니오. 추출 방식이 신호마다 다름 | | | 제외 |

## 7. 모델 비교에 넘긴 후보 14개 (+ 파이썬 비교용 median)

**1차 8개** (창 하나 안에서 계산)

mean NN, SDNN, RMSSD, SDSD, CVNN(SDNN/mean), CVSD(RMSSD/mean), SD2, SD1/SD2

median NN은 파이썬 비교표에는 넣어 mean 대비 이점을 기록하되 회로에는 올리지 않는다. 재료 5개(N, ΣRR, ΣRR², Σd, Σd²)로 만들 수 없기 때문이다.

**파생 6개** (창끼리 비교)

mean NN, SDNN, RMSSD 각각에 대해 개인 기준선 대비값과 직전 창 대비 변화량. 기준선 = 첫 3분 창 특징값의 평균(라벨 무관, [V]), 비교는 비(차는 비교용 열). 직전 창 = 30초 전. 첫 3분은 판정 보류(특징 표 규칙. 칩은 좋은 1분 창 3개로 기준선을 만든다). 기준선을 3분치 재료로 한 번에 계산하지 않고 창 특징값의 평균으로 잡는 것은, 3분짜리 SDNN이 30초짜리보다 체계적으로 커서 같은 종류의 값이 아니기 때문이다.

후보 단계의 회로 관점: 1차 8개는 누산기 다섯 개(N, ΣRR, ΣRR², Σd, Σd²)에서 전부 나온다. 특징 개수가 아니라 누산기 개수가 비용이다. 파생 6개는 과거 재료를 보관하는 레지스터 몇 개다.

후보는 모델 비교에서 학습 폴드 안에서만 고른다. 사람을 분리한 교차검증에서 새 사람에게 통한 특징은 `mean_rb`(창 평균 RR ÷ 기준선 평균 RR) 하나였고, 창은 60초로 정했다. 이 특징에는 N과 ΣRR만 들어가므로 칩이 받는 심박 재료는 60초 창의 박동 수 `o_n60`, RR 합 `o_sum_rr60`, 그리고 이마 PPG의 창 품질을 거르는 탈락 박동 수 `o_bad60` 셋이다.

## 8. 문헌이 메우지 못하는 것

- **시뮬레이터에서 배운 것이 실도로에서 통하는가.** [L]이 실도로·대규모·피험자 독립 조건에서 성능 저하를 보고했다. 우리는 그 셋 중 둘(시뮬레이터 학습, 피험자 독립 평가)에 해당하고 실도로 검증은 불가능하다.
- **피로1이 전조인가.** MPD-DF 사건 445건 중 피로1에 머물다 각성으로 돌아간 것이 79.8%다. "예측"이 아니라 "각성도 저하 감지"로 쓴다.
- **이마 PPG의 특성.** [B]는 귓불, PPG-DaLiA는 손목, 팀 벤치 측정은 손가락이다. 귓불은 머리 쪽 반사형이라 [B]의 샘플링 결과는 이마에도 비교적 가깝게 적용될 것으로 본다. 이마 PPG에서 `mean_rb`가 심전도와 같게 나오는지는 WildPPG(흉골 심전도와 이마 PPG 동시 기록)로 확인했지만, 이 데이터에는 졸음 라벨이 없어 이마 PPG로 졸음을 직접 채점하지는 못했다.
- **개별 지표의 민감도.** 문헌은 후보를 정하는 데까지만 쓴다. 어느 지표가 우리 데이터에서 실제로 가르는지는 모델 비교가 답한다.

## 9. 우리 데이터에서 확인한 것

[L]의 방향(HR 감소, 변동 증가)은 특징 표의 사람 안 짝 비교에서 재현됐다. 각성·피로 창이 각 5개 이상인 45명에서 30초 창 mean NN +1.4%(32/45, Wilcoxon p 1.5e-5), SDNN +8.7%(39/45), RMSSD +4.6%(31/45)다. 샘플링 쪽은 240 Hz가 RR에 주는 오차가 표준편차 2.2 ms로 RR 자체 변동(40~100 ms)의 2~5%라, [H][B]가 말한 대로 보간이 필요 없다. 특징 표의 기준선은 [V]를 따라 첫 3분·라벨 무관으로 잡았고, 비교는 비를 썼다(차는 비교용). 칩은 좋은 1분 창 3개로 기준선을 만든다.
