albertjihyun/Busan-IDEC/docs/ml-plan.md

# ML 파트 구성

프로젝트: PPG 기반 온디바이스 졸음 감지 SoC (팀 쿵쿵딱)

---

## 목표

PPG에서 추출한 심박 간격(RR) 특징으로 각성도 저하를 판정하는 모델을 만들고, FPGA에 올릴 수 있는 정수 판정 회로로 확정한다. 고개 떨굼은 IMU 규칙으로 따로 잡아 경보에 합친다. ML 파트의 결과물은 판정 블록(`infer_top` = `classifier` + `imu_rule`) Verilog와, 그것을 비트 단위로 검증하는 파이썬 정수 기준 모델이다.

## 문제 정의와 평가 지표

잡는 것은 "각성도가 떨어지고 있는 상태"다. 이미 잠든 상태(N1·N2)는 학습 데이터가 60에폭뿐이라 대상이 아니다. MPD-DF의 피로1 구간 중 79.8%는 더 깊어지지 않고 각성으로 돌아가므로 "졸음을 예측한다"가 아니라 "각성도 저하를 실시간 감지한다"고 쓴다. 실제로 깊어진 90건은 따로 추적해 "더 나빠지기 전에 잡았는가"를 본다.

놓침 방지를 우선한다. 사건 민감도(사건 구간 안에서 한 번이라도 경보했는가)와 창 민감도를 둘 다 주 지표로 보고, 짝 지표는 시간당 헛경보 횟수다. 모델 비교 수치는 헛경보를 목표값에 정확히 맞춘 뒤 계산한다. 칩 수치는 정수 `T_FIX` 하나로 낸 실제 헛경보를 함께 적는다. 정확도는 전부 각성이라 찍어도 76.8%라 쓰지 않는다. 이진화는 0 대 1 이상, 즉 피로1부터 양성이다.

창은 60초, 갱신은 5초, 채점은 30초다. 갱신을 5초로 하면 창 경계가 사건과 어긋나는 문제가 없고 회로 비용은 5초 블록 누산기 12벌뿐이다. 채점은 라벨이 30초 단위라 30초 시점의 판정만 본다. 고개 떨굼 같은 초 단위 사건은 IMU가 즉시 처리한다.

연속 N회 경보 규칙과 이력(hysteresis)은 판정에 쓰지 않는다. 30초짜리 사건이 23%라 놓침이 커지고, 판정마다 각각 판단해야 하기 때문이다. 헛경보는 모델과 문턱으로 줄인다. 경보는 첫 졸림 판정에서 바로 내고, 졸림이 이어지면 30초(60초 창의 절반)마다 다시 낸다. 판정 하나가 최근 60초를 보아 연달아 나온 판정은 대부분 같은 데이터이기 때문이다.

모델 입력은 파형에서 나온 것만 쓴다. 뇌파·안구·호흡·수면시간·피험자 번호·경과 시간은 입력으로 쓰지 않는다. 경과 시간은 기준선 구간을 정하는 절차에만 쓴다.

## 사용 데이터

| 데이터셋 | 용도 | 라벨 간격 | 내용 |
|---|---|---|---|
| **MPD-DF** (figshare) | 학습·평가 | 30초 | 수동 운전 시뮬레이터 2시간, ECG 1024Hz, 의사가 뇌파로 판정한 피로 5단계, 50명 |
| **WildPPG** (ETH) | 이마 PPG 전이 검증 | 졸음 라벨 없음 | 흉골 ECG + 이마 PPG + 이마 가속도, 야외 활동, 16명(ECG 불량 1명을 빼고 15명 비교) |
| **PPG-DaLiA** (UCI) | ECG↔PPG 비교, 움직임 분석, IMU 규칙 헛울림 확인 | 졸음 라벨 없음 | 손목 PPG + 가슴 ECG + 가속도 동시 기록, 운전 활동 포함, 15명 |

PPG와 졸음 라벨이 함께 있는 공개 데이터는 없다. 그래서 RR 간격이라는 공통 표현으로 ECG에서 학습하고, PPG에서도 같은 특징값이 나오는지는 WildPPG와 PPG-DaLiA로 따로 확인한다. 라벨이 30분 간격인 AdVitam과 ECG가 128 Hz인 DD-DB는 검토했으나 쓰지 않는다.

---

## 1. RR 간격 추출

학습용 RR은 학습 검출기로 뽑는다. ECG를 보드 AFE와 같은 방식으로 거르고(단, ECG는 저역 40 Hz) 240 Hz로 낮춘 뒤, 꺾임 → 문턱 3/5 → 불응기 96샘플 → 급하강 24샘플 1/2 → level `>>>3` 순서의 단순 규칙으로 봉우리를 찾는다. neurokit2 결과를 정답으로 비교하면 50명 pooled 놓침 1.0%·오검출 3.2%, 사람별 중앙값 0.33%·0.41%, SQI 통과 99.9%다. 240 Hz 샘플링에 따른 RR 오차는 표준편차 2.2 ms다.

칩에서는 이 검출기가 아니라 신호처리 블록의 검출기가 이마 PPG에서 RR을 뽑는다. 학습과 칩을 잇는 것은 특징 `mean_rb`(창 평균 RR ÷ 기준선 평균 RR)이고, 칩 검출기로 학습하면 사람 분리 교차검증 성능이 떨어져 학습은 학습 검출기로 한다. 두 경로의 `mean_rb`가 같은지는 5절에서 확인한다.

## 2. 특징 표

행 하나는 30초 에폭 하나이고, 정답은 그 에폭의 라벨이다. 60초 창은 정답을 합치는 것이 아니라 같은 에폭을 맞히기 위해 앞 에폭의 심박까지 입력으로 보는 것이다. 30초와 60초 표를 둘 다 만들어 같은 정답으로 비교한다.

특징은 5초 블록 누산 재료 5개(N, ΣRR, ΣRR², Σd, Σd²)만 거쳐 계산해, 파이썬 표와 회로 출력이 같은 값이 되게 한다. 단위는 샘플 수다. 후보는 14개다. 1차 8개(mean NN, SDNN, RMSSD, SDSD, CVNN, CVSD, SD2, SD1/SD2)와 파생 6개(mean NN·SDNN·RMSSD 각각의 개인 기준선 대비 비와 직전 창 대비 변화량)이고, median NN은 파이썬 비교용으로만 따로 계산한다. 후보는 국제 표준 문서의 시간영역 지표 전체에서 30초 창에서 계산이 성립하는지, ECG와 PPG 양쪽에 존재하는지, 240 SPS 분해능에서 오차가 허용 범위인지로 거른다. pNN50·pNN20은 표준 문서와 샘플링 연구가 통계적 성질을 이유로 비권장해 뺀다. 주파수영역(LF/HF)은 표준 문서가 2~5분 창을 요구해 30초·60초 창에서 성립하지 않으므로 뺀다.

무효 창은 아티팩트 에폭, 유효 박동이 30초 창 15개(60초 창 30개) 미만인 창, 기준선 준비 중인 창이다. 행은 남기고 표시만 하며, 학습과 채점은 유효 행만 쓴다.

## 3. 모델 비교

규칙 기반 단일 문턱, 결정트리(깊이·노드 제한), 로지스틱 회귀, 랜덤포레스트, 부스팅 트리를 MPD-DF 50명에서 사람 단위 분할(leave-one-subject-out)로 비교했다. 특징 선택은 학습 폴드 안에서만 한다. 42·49번은 피로 0, 22번은 각성 0이라 폴드별 평균을 내지 않고 전체를 모아(pooled) 계산한다. 모델마다 파라미터 크기와 곱셈 횟수를 함께 적고, 예산은 FPGA 용량이 아니라 양산 칩 기준(곱셈기 시분할 1개, 파라미터 4KB, 추론당 곱셈 1만 회)으로 둔다.

결과는 로지스틱 회귀, 특징 1개 `mean_rb`다. 특징이 1개면 로지스틱은 단조 함수라 `mean_rb ≥ T`라는 문턱 규칙과 같고, 칩에 들어가는 파라미터는 T 하나다. 크기가 작을수록 새 사람에게 나았다(헛경보 2회/h 사건 민감도, 30초 / 60초: 로지스틱 0.262 / 0.265 (2 B), 규칙 0.212 / 0.188, 얕은 트리 0.212 / 0.181, 랜덤포레스트 0.156 / 0.206 (45 KB), 부스팅 0.144 / 0.188). 랜덤포레스트가 예산 11배를 쓰고도 꼴찌라 더 무거운 RBF SVM과 MLP는 돌리지 않는다. 개인화 강화 변형도 모두 손해였다.

창은 60초다. 사건 민감도는 30초와 같지만 창 민감도와 커버율이 60초에서 일관되게 높다. 동작점은 헛경보 시간당 4회 하나를 칩에 넣는다. 2회/h는 폴드 간 문턱이 불안정해 참고로만 적는다.

| 헛경보 | 사건 민감도 | 창 민감도 | 깊은 사건(피로2+) |
|---|---|---|---|
| **4회/h (칩에 넣은 동작점)** | **0.413 [0.28–0.53]** | **0.368** | **0.633 [0.48–0.80]** |
| 2회/h (참고) | 0.265 | 0.225 | 0.456 |

괄호는 피험자 부트스트랩 95% 구간이다.

성능이 이 정도인 이유는 신호 자체에 있다. 졸음이 만드는 `mean_rb` 변화는 1.3%인데 같은 사람이 깨어 있을 때의 흔들림이 4.0%라 신호대잡음비가 0.33이고, 여기서 나오는 이론 AUC 0.59와 실측 0.60이 같다. 특징 14개를 다 쓰고 학습 데이터로 채점하는 상한도 0.647이다. 사람을 분리해 평가한 심박 단독 문헌도 0.6 언저리이고, EU 규정의 민감도 합격선 자체가 40%다.

## 4. 정수 판정

`mean_rb ≥ T`의 양변에 `n60 × N_base × 1024`를 곱해 나눗셈을 없앤다.

```
(sum_rr60 × N_base) << 10  ≥  (T_FIX × ΣRR_base) × n60
```

근사는 T를 소수 10비트로 반올림한 것 하나다. 소수 8·10·12비트를 비교해 10비트를 쓴다. T_FIX = 1086(T = 1.0605)은 50명에서 헛경보 4회/h 이하를 지키는 최소 정수다. 창 품질 규칙을 넣기 전 기준으로, 판정된 블록 73,009개 중 실수 T와 판정이 갈리는 것은 120개(0.16%)이고 사건 민감도는 50명 공통 실수 T의 0.385에서 0.381이 된다. 창 품질·기준선 규칙까지 넣은 칩의 최종값은 50명에서 사건 민감도 0.379(판정 가능 사건 441건 중 167건), 깊은 사건 0.567, 헛경보 3.94/h다(모델 비교와 같이 30초 라벨마다 끝 판정으로 채점, 헛경보는 경보 덩어리 수). 휴대폰이 실제로 받는 경보는 30초 간격 규칙 뒤 깨어 있을 때 시간당 26번, 피로1 이상일 때 45번이다.

기준선은 새 신호 없이 60초 창 합을 더해 만든다. 12·24·36·…번째 블록(서로 안 겹치는 1분 창)마다 그 창이 좋은 창이면 더하고, 좋은 창 3개가 모이면 완성한다(최소 3분, 재시작 없음). 좋은 창은 박동 30개 이상이고 살린 박동이 75% 이상(`3 × bad60 ≤ n60`)인 창이다. 기준선 완성 전(완성되는 블록 포함)이거나 좋은 창이 아니면 판정을 보류(hold)한다.

## 5. 이마 PPG 전이 검증

ECG로 잡은 문턱이 이마 PPG 칩에서도 맞는지 WildPPG 15명으로 확인했다. 같은 사람, 같은 시각에 ECG(학습 검출기)로 낸 `mean_rb`와 이마 PPG(칩 검출기 재현 + 모션 게이트)로 낸 `mean_rb`를 칩 판정 절차로 비교한다. 착용 직후 20분은 뺀다.

박동을 많이 버린 창과 기준선이 판정을 틀리게 한다. 그래서 4절의 좋은 창 조건(살린 비율 75% 이상)을 기준선과 판정 양쪽에 둔다. 이 두 규칙에서 PPG와 ECG의 `mean_rb` 차이는 중앙값 −0.1%, 표준편차 1.7%(앉은 구간 1.5%)이고, 2% 넘게 어긋난 창은 17%, 판정 일치는 97.4%(사람별 92~100%)다. 규칙이 없으면 차이 표준편차 7.4%, 판정 일치 사람별 50~97%다. PPG 쪽 흔들림 1.7%는 각성 중 생리적 흔들림 4.0%보다 한참 작다.

MPD-DF 50명에 두 규칙을 넣어도 판정 블록 99.8%가 남고 T_FIX는 1086 그대로다. 대가는 판정 빈도다. 두 규칙에서 남는 판정 창은 WildPPG(이마, 야외 활동) 약 38%, PPG-DaLiA(손목, 실제 운전) 26%이고, 이마로 운전하는 조건의 데이터는 없다. 살린 비율 문턱은 파라미터 `KEEP_K`(3 = 75%, 2 = 67%, 1 = 50%, 0 = 끔)로 두고 보드 실측 후 조정한다.

## 6. IMU 규칙

고개 떨굼은 심박과 무관하게 즉시 경보한다. 가속도를 2 Hz IIR로 거른 뒤 중력 투영으로 자세를 본다. 앞축 ≥ sin35° 그리고 세로축 ≤ cos35°가 0.5 s 이어지면 펄스를 내고, 숙인 채 있으면 5 s마다 반복한다. 세로축 조건이 급제동과 구별해 준다. 이 규칙은 천천히 처져 그대로 있는 경우를 맡고, 빨리 떨어졌다 돌아오는 꾸벅임은 신호처리 블록의 자이로 끄덕임 검출(25°)이 맡아 둘을 OR로 합친다.

움직임이 많을 때 판정을 보류하는 규칙은 두지 않는다. PPG-DaLiA 15명 분석에서 이득이 작았고, 신호처리 블록 SQI의 모션 게이트가 박동 단위로 이미 거른다. 문헌의 축별 가속도 문턱은 설정 범위를 넘는 값을 보고하는 등 근거로 쓸 수 없어, 구조는 중력 투영 + 2 Hz 저역 + 지속시간 방식을 따른다.

검증은 합성 16 시나리오 11,590샘플(RTL)과 PPG-DaLiA 가슴 가속도 15명 35.9 h(파이썬, 그중 1명 921,200샘플은 RTL 대조)로 한다. 가슴 15명 운전 3.8 h에서 자세 규칙 펄스는 0회다. 착용 녹화 검증은 보드가 없어 후속 과제다.

## 7. 판정 블록 Verilog

`classifier`는 좋은 창 판정, 기준선 누산, 교차 곱셈 비교를 하고 5초마다 `hold`·`drowsy`를 낸다. `imu_rule`은 6절의 자세 규칙이다. `infer_top`은 둘을 감싸고 경보를 하나로 합친다.

`alert`는 심박 판정(30초 간격), 가속도 자세 규칙, 부호 확정 뒤의 자이로 끄덕임을 OR 한 펄스 하나다.

입력은 신호처리 블록의 60초 창 합 3개(`o_n60`, `o_sum_rr60`, `o_bad60`)와 IMU 신호(가속도 3축, `o_imu_valid`, `o_nod_event`, `o_nod_sustained`, `o_pitch_sign_ok`)다. 출력은 `alert` 펄스 하나이고, 통신 블록이 펄스마다 1바이트를 보낸다.

파이썬 정수 기준 모델이 만든 정답과 대조해 MPD-DF 50명의 5초 블록 전부(75,186)와 경계 사례 278블록에서 불일치 0이다. 판정 블록에 통신 블록을 붙여 같은 벡터를 넣으면 경보 3,154개가 UART 바이트 3,154개로 나간다. `imu_rule`도 6절의 벡터 전부에서 불일치 0이다. Vivado 합성·구현(xc7a35t, out-of-context, 12 MHz)에서 `infer_top`은 LUT 305, FF 107, DSP 3, BRAM 0, WNS 72.3 ns다(단독 합성. 칩 최상위에 통합하면 LUT 207). 실제 보드 데이터와의 대조는 보드가 없어 후속 과제다.

---

## 실험 원칙

- 피험자 단위 분할로만 평가한다. 랜덤 분할은 정확도를 부풀린다.
- 정확도만 보고하지 않는다. 민감도·커버리지·모델 크기를 함께 본다.
- "95% 가능"이라고 쓰지 않는다. "선행 연구 사례가 있고, 우리 조건에서 검증한다"고 쓴다.
- 모델은 처음부터 하나로 정하지 않고 비교 결과로 정한다.
- 하드웨어 비용을 모델 선정 기준에 포함한다.
- 특징은 생리학적 직관이 아니라 조건(공통성·창 길이·샘플링)으로 거르고 데이터로 고른다. 개별 지표의 변화 방향은 미리 주장하지 않는다.
- 커버리지(SQI와 창 품질 규칙으로 버리는 구간 비율)를 성능과 함께 보고한다.
- "하드웨어라서 큰 모델 못 돌린다"고 쓰지 않는다. 작게 가는 이유는 데이터 크기·양산 면적·구현 시간이다.

---

## 참고 문헌

원문을 읽은 것:

- HRV 표준 문서 — Task Force of the ESC and NASPE, Circulation 93(5):1043-1065, 1996. https://doi.org/10.1161/01.CIR.93.5.1043
- 운전 피로 HRV 체계적 문헌고찰(18편, 정확도 44~100%) — Lu et al., Accid Anal Prev 178:106830, 2022. https://doi.org/10.1016/j.aap.2022.106830
- ECG 샘플링 간격과 시간영역 HRV 오차 — Hejjel & Roth, Physiol Meas 25:1405-1411, 2004. https://doi.org/10.1088/0967-3334/25/6/006
- PPG 최소 샘플링 주파수(240 SPS에서 RMSSD 오차 0.5%) — Béres & Hejjel, Biomed Signal Process Control 68:102589, 2021. https://doi.org/10.1016/j.bspc.2021.102589
- PPG-HRV 졸음 감지 — AlArnaout et al., Scientific Reports 2025, https://www.nature.com/articles/s41598-025-08582-2 (10명 운전 스트레스 데이터 재활용, 라벨은 심박수 문턱, 사람 분리 없음. 직접 비교 대상이 아니다)

요약만 확인한 것:

- 수면부족 HRV 메타분석(11편 549명, RMSSD 감소·LF/HF 증가) — https://pmc.ncbi.nlm.nih.gov/articles/PMC12394884/
- 초단기 HRV 타당성, 3,387명(RMSSD 10초, SDNN 30초) — PLOS One 2015, https://pmc.ncbi.nlm.nih.gov/articles/PMC4586373/
- 초단기 HRV 규범 연구 비판적 리뷰(엄격 기준: SDNN·RMSSD 60초) — https://pmc.ncbi.nlm.nih.gov/articles/PMC7710683/
- 손목 PPG 초단기 HRV 타당성(5명) — https://pmc.ncbi.nlm.nih.gov/articles/PMC9611389/
- PPG-HRV + SVM 95% / 단일 임계값 68.8% — https://pmc.ncbi.nlm.nih.gov/articles/PMC3892817/ (4명 80표본을 표본 단위로 나눈 교차검증이라 피험자 독립 평가가 아니다. 직접 비교하지 않는다)
- IMU 임계값 기반 고개 떨굼 감지 (MPU-6050) — Nurnaningsih et al. 2025, https://journal.uinjkt.ac.id/index.php/ti/article/view/45271
- 머리 착용형 생체신호 + 머리 움직임 결합 (82.71% → 96.24%) — Sensors 2015, https://www.ncbi.nlm.nih.gov/pmc/articles/PMC4570452/
- PPG + 움직임 센서 증거 결합 (FDWatch) — ACM TOSN 2023, https://pure.bit.edu.cn/en/publications/towards-reliable-driver-drowsiness-detection-leveraging-wearables/

데이터셋:

- MPD-DF — Scientific Data 2026, https://www.nature.com/articles/s41597-026-06634-4
- PPG-DaLiA — https://archive.ics.uci.edu/dataset/495/ppg+dalia
- WildPPG — Meier et al., NeurIPS 2024 Datasets and Benchmarks, https://arxiv.org/abs/2412.17540
