albertjihyun/Busan-IDEC/docs/stage5-ppg-transfer.md

# 이마 PPG 전이 검증: ECG로 잡은 문턱이 이마 PPG 칩에서도 맞는가

문턱 T는 ECG 50명(MPD-DF)에서 학습 검출기로 뽑은 RR로 잡았고, 칩은 이마 PPG를 칩 검출기로 본다. 둘을 잇는 것은 특징 `mean_rb`(60초 평균 RR ÷ 기준선 평균 RR)다. 검출기를 신호마다 따로 두는 이유는 각자 자기 신호에서 참값에 가까운 RR을 내기 때문이다. 칩 검출기는 ECG에서 T파를 봉우리로 잡는 사람이 50명 중 11명이고, 학습 검출기는 이마 PPG에서 첫 포화 아티팩트 뒤 문턱이 내려오지 않는다. 여기서 확인할 것은 하나다. **같은 사람, 같은 시각에 ECG로 낸 `mean_rb`와 이마 PPG로 낸 `mean_rb`가 같은가.**

## 1. 데이터와 절차

- **WildPPG**(ETH): 16명, 1명당 12~15시간. 흉골 ECG와 이마 PPG(초록, 128 Hz), 이마 가속도를 같은 시간축에 기록했다. 야외 활동(걷기·등산·일상) 기록이라 운전보다 거칠다. 졸음 라벨은 없다. fex는 ECG가 불량이라 비교에서 뺐다(15명).
- ECG 경로: 학습과 같은 대역(0.16~40 Hz) → 240 Hz → 학습 검출기·SQI → 5초 블록 → 60초 창.
- PPG 경로: 보드 AFE 흉내(0.16~16 Hz) → 240 Hz → ADC 코드 크기 맞춤(2초 봉우리-골 중앙값 238) → 칩 검출기의 비트 정확 파이썬 모델 + 모션 게이트(이마 가속도로 신호처리 블록의 정수 연산 재현, `MOTION_TH` 4000) → 5초 블록 → 60초 창.
- 두 경로 모두 칩 판정 절차(파이썬 정수 기준 모델, T_FIX 1086)를 돈다. 비교는 둘 다 판정한 블록에서 `mean_rb_PPG ÷ mean_rb_ECG − 1`과 판정 일치율이다. 기준선 시점을 맞추려고 ECG는 PPG가 기준선에 쓴 것과 같은 1분 창으로 기준선을 잡는다.
- 착용 직후 20분은 뺐다(센서 자리잡기 전. 빼지 않으면 기준선이 10% 틀어진다).

## 2. 박동 수만 보면 무엇이 틀리나

첫 3분을 그대로 기준선으로 쓰고 창의 박동 수(30개 이상)만 보는 규칙에서는 다음 두 가지가 틀린다.

| 원인 | 증상 | 확인 |
|---|---|---|
| 기준선(첫 3분)에 접촉이 나빠 박동 절반 이상을 버림 | 남은 박동이 한쪽으로 쏠려 기준선이 10~26% 틀어지고, 그 사람의 판정이 하루 종일 한쪽으로 기움 | n31 참값 171 vs PPG 145 (−15%), trh 182 vs 135, qm9 141 vs 164. ECG 쪽은 전원 참값과 같음 |
| 창 안에서 박동을 많이 버림 | 그 창 평균 RR이 흔들림 | 앉은 구간: 살린 비율 95% 이상이면 오차 표준편차 0.4%, 50% 미만이면 8.5~13.9% |

ECG(학습 검출기)는 neurokit 참값 대비 창 평균 오차 표준편차가 0.2~0.3%라 흔들림은 전부 PPG 쪽이다. 박동 수만 보면 절반 넘게 버린 창도 통과한다.

## 3. 규칙 두 개

1. **기준선**: 1분마다 60초 창 하나를 보고, 박동 30개 이상이고 살린 비율 75% 이상(`3 × bad60 ≤ n60`)인 창만 기준선에 더한다. 좋은 창 3개가 모이면 완성한다. 처음 3분이 전부 좋으면 첫 3분 합과 같다.
2. **창**: 판정 때도 같은 조건을 본다. `3 × bad60 > n60`이면 hold.

`bad60`은 신호처리 블록의 `o_bad60`(60초 창 탈락 박동 수)이다. 문턱은 파라미터 `KEEP_K`(3 = 75%, 2 = 67%, 1 = 50%, 0 = 끔)로 두고 보드 실측으로 조정한다.

## 4. 결과 (WildPPG 15명)

| | 박동 수 조건만 | 기준선 규칙만 | **두 규칙** |
|---|---|---|---|
| 치우침(차이 중앙값) | −3.1%, 사람별 −11~+4% | 0.0% | **−0.1%** |
| 흔들림(차이 표준편차) | 7.4% | 5.8% | **1.7%** (앉은 구간 1.5%) |
| 2% 넘게 어긋난 창 | 74% | 45% | **17%** |
| 판정 일치(문턱 1.0605) | 사람별 50~97% | 94.9% | **97.4%** (사람별 92~100%) |

기준선 완성까지 걸린 시간은 9명 4~15분, 5명 22~40분, 1명(n31) 387분이다.

비교 기준은 졸음이 만드는 `mean_rb` 변화 1.3%와 각성 중 사람 안 흔들림 4.0%다. 두 규칙에서 PPG 쪽 흔들림(1.7%)은 생리적 흔들림보다 한참 작다.

## 5. 증명된 것과 모르는 것

**증명된 것.** 박동을 많이 버린 창은 판정이 틀린다. 세 데이터(WildPPG 이마 등산, PPG-DaLiA 손목 운전, 합성)에서 같은 방향이다. 두 규칙은 PPG 판정을 ECG 판정에 97% 맞춘다.

**학습 쪽 영향은 작다.** MPD-DF 50명(ECG)에 두 규칙을 넣으면 판정 블록 73,009 → 72,840(99.8%), 기준선이 첫 3분과 달라지는 사람 3명(26·32·40번, 최대 5분)이다. 헛경보 3.95 → 3.94/h, 사건 168 → 167/441이고, T_FIX를 다시 잡아도 1086 그대로다.

**모르는 것: 운전 중 이마에서 판정이 얼마나 남는가.** 규칙은 신호가 나쁜 창을 판정하지 않으므로 판정 빈도가 준다. 칩 조건(이마 + 운전)과 같은 데이터가 없다.

| 데이터 | 조건 | 두 규칙에서 남는 판정 창 |
|---|---|---|
| MPD-DF | ECG, 운전 시뮬 | 99.8% (ECG는 박동을 거의 안 버림) |
| WildPPG | 이마 PPG, 야외 활동 | 약 38% |
| PPG-DaLiA | 손목 PPG, 실제 운전 | 26% |

PPG-DaLiA 운전 구간에서 문턱별로 보면 판정 창과 정확도가 맞바뀐다(창 평균 RR 오차, 정답 가슴 ECG).

| 살린 비율 조건 | 판정 창 | 오차 표준편차 | 2% 넘게 틀린 창 |
|---|---|---|---|
| 없음 | 92% | 10.5% | 58% |
| 50% | 82% | 8.5% | 55% |
| 60% | 63% | 5.2% | 48% |
| 70% | 37% | 2.9% | 34% |
| 75% | 26% | 2.2% | 26% |

손목은 핸들 조작 때문에 최악의 경우이고 이마는 이보다 나을 것으로 보이나 확인하지 못했다. 조건 없이 두면 판정은 많지만 창 절반 이상이 졸음 신호(1.3%)보다 크게 틀린 상태라, 규칙은 판정을 잃는 것이 아니라 원래 믿을 수 없던 판정을 드러내는 것이다. 기본값 75%는 정확도 근거로 정했고, 판정 빈도는 보드 실측 뒤 `KEEP_K`로 조정한다.

접촉이 나쁜 동안은 경보가 울리지 않는다. 출력은 졸음 경보 하나만 둔다. 사용자가 알아야 할 것은 졸음 여부뿐이기 때문이다.

## 6. 구현

`classifier`는 1분 창 카운터와 좋은 창 카운터(2비트)로 기준선을 모으고, 입력 `i_bad60`(8비트)과 파라미터 `KEEP_K`, `BASE_WINS`를 둔다. `KEEP_K × bad60`은 시프트·덧셈이다. `infer_top`에는 `i_bad60` 포트가 있고, 신호처리 블록의 `o_bad60`을 여기에 연결한다.

테스트 벡터에는 `bad60` 열과 경계 사례(판정 경계, 창 품질 경계, 나쁜 창을 건너뛰는 기준선, 최대값, 경보 간격)가 들어 있다. 시뮬레이션에서 75,464블록의 `hold`·`drowsy`·`alert`가 파이썬 정수 기준 모델과 불일치 0이고, 상수를 일부러 틀리면 잡는다(`KEEP_K` 3 → 2: 567블록, `BASE_WINS` 3 → 2: 4,772블록).

## 7. 별도 과제 (범위 밖)

- **출발부터 졸린 운전자**: 기준선이 졸음 상태로 잡혀 감지하지 못한다. 야간 근무 뒤 통근 운전자 19%, 교대 근무 트럭 첫 야간 37.8%가 KSS 7 이상이다. 그래서 대상을 "출발 시 각성" 운전자로 한정한다.
- **시간 경과 심박 하강**: 깨어 있어도 오래 앉아 있으면 RR이 길어진다. MPD-DF 각성 창에서 90분 뒤 `mean_rb` 중앙값 1.025, 각성 창의 31%가 문턱을 넘는다(시작 20분 안은 4~8%). 버스 기사 실차 6시간 85 → 78 bpm과 시간당 기울기가 비슷하다. 헛경보가 후반에 몰린다는 뜻이고, 기준선을 천천히 갱신하면 줄일 수 있으나 졸음이 기준선에 스며드는 위험과 맞바꾼다.
