albertjihyun/Busan-IDEC/docs/figures/feat_corr_30s.png

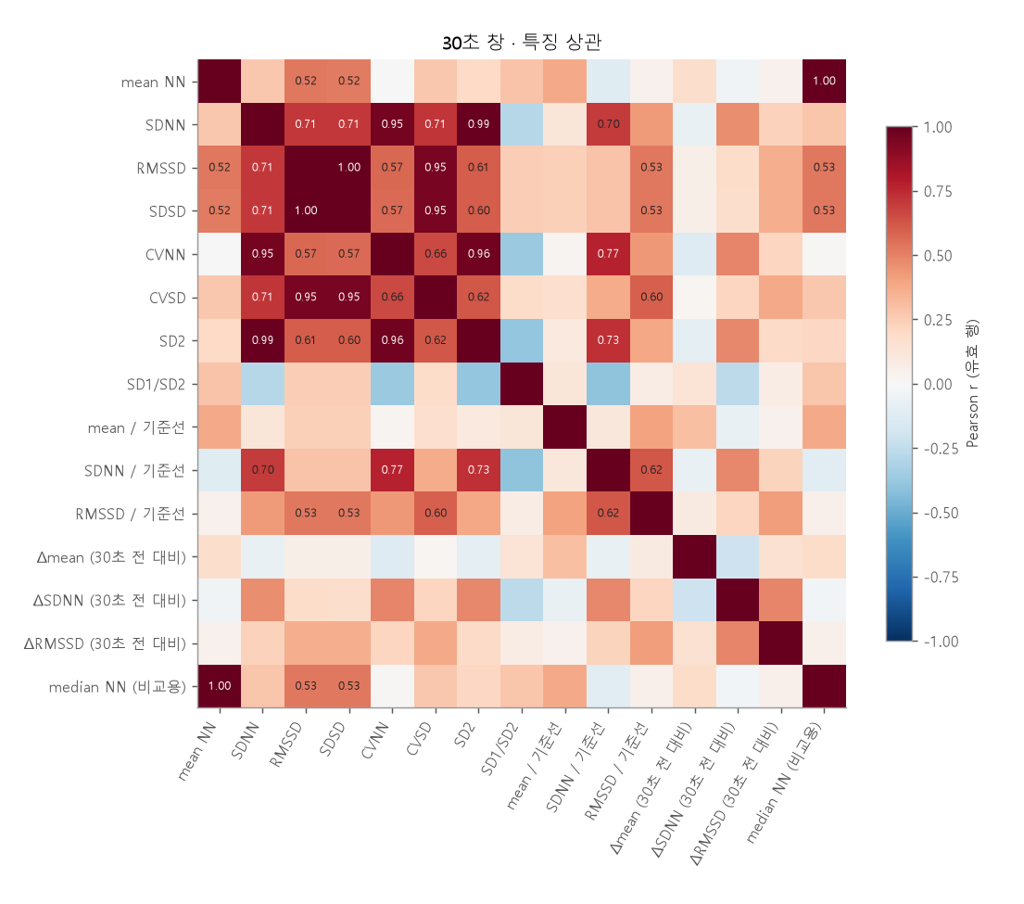
docs/figures/feat_corr_30s.png
