albertjihyun/Busan-IDEC/docs/figures/feat_hist_30s.png

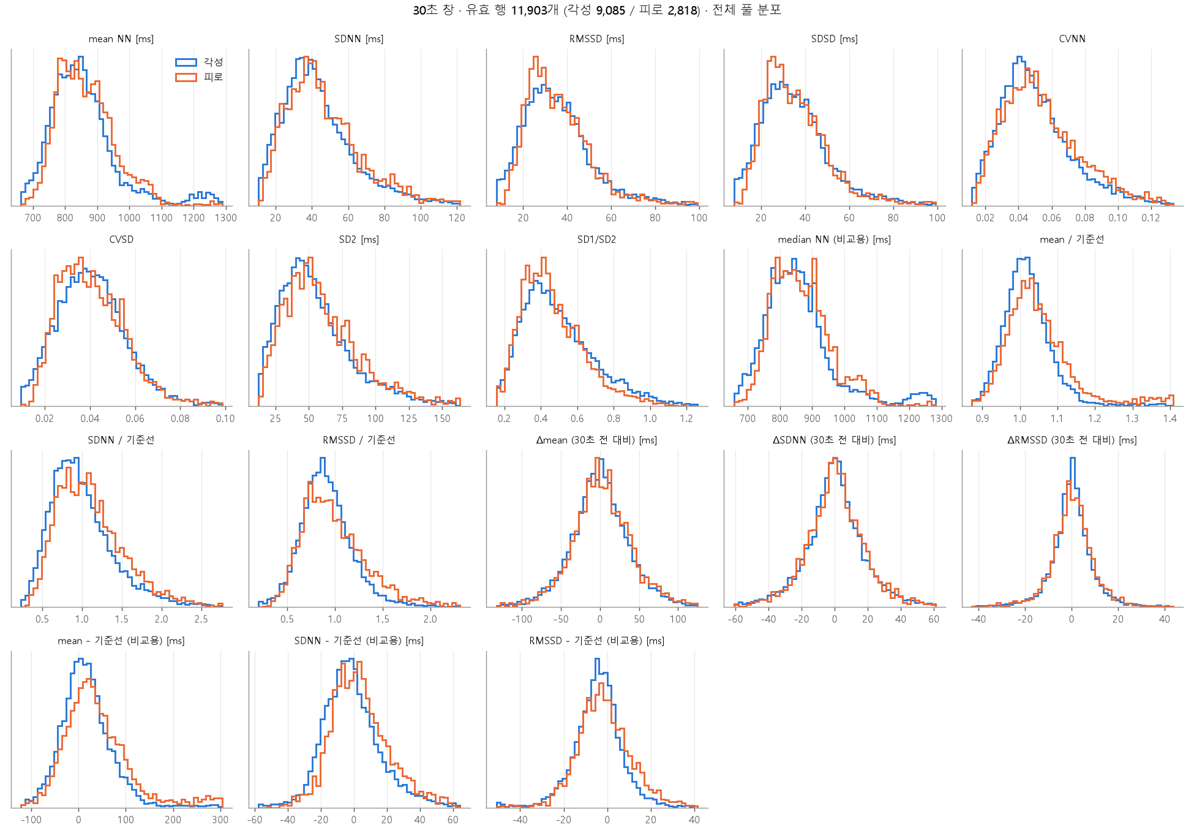
docs/figures/feat_hist_30s.png
