albertjihyun/Busan-IDEC/docs/figures/feat_hist_60s.png

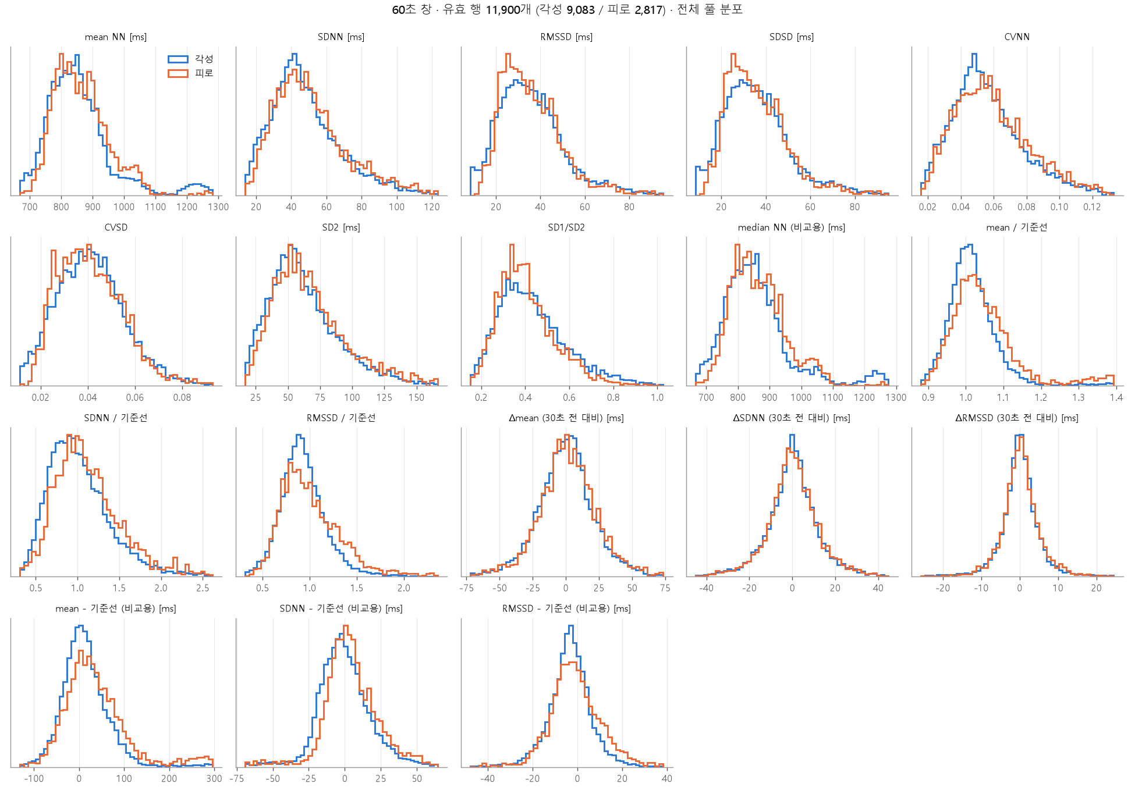
docs/figures/feat_hist_60s.png
