albertjihyun/Busan-IDEC/(commit log)

2026-09-07 프로젝트 초기 설정: 개요 및 진행 현황 정리
2026-09-07 README를 ML 파트 중심으로 재작성하고 구현 계획 문서 추가
2026-09-07 README 축약, 데이터셋 다운로드 스크립트와 의존성 추가
2026-09-07 gitignore 정리: data 디렉터리 전체 제외, csv 일괄 제외는 해제
2026-09-07 AdVitam Exp4 데이터 포맷 조사 결과 정리
2026-09-07 ECG 포맷 검증 결과와 샘플링 주파수 주의사항 추가
2026-09-07 다운로드 스크립트 수정: 완결성 검증, 재시도, 필요한 항목만 선택 수신
2026-09-07 라벨 시간 해상도 기준으로 데이터셋 비교 정리
2026-09-07 다운로드 중 연결 끊김 처리: Range 요청 단위 재시도
2026-09-07 MPD-DF 추가: 심전도와 30초 라벨만 선택 수신, md5 검증
2026-09-07 figshare 다운로드 주소 수정: ndownloader.figshare.com이 403이라 figstatic.com 사용
2026-09-07 MPD-DF 신호와 라벨 포맷 조사 결과 추가
2026-09-07 학습 데이터 역할 교대: MPD-DF 주 학습, AdVitam 외부 검증
2026-09-07 데이터 조사 문서에 역할 교대 결정 반영
2026-09-07 MPD-DF 라벨 50명치 집계와 2단계 반영 사항 정리
2026-09-07 윈도우 파일 잠금 대응: 이름 변경 재시도
2026-09-07 다운로드 중복 실행 방지: 다른 프로세스가 쓰는 중인 파일은 건드리지 않는다
2026-09-08 ML 파트 범위에 Verilog 구현 포함
2026-09-08 docs: README의 데이터셋 역할과 모델 비교 방식을 ml-plan에 맞춤
2026-09-10 Verilog 구현 설계 문서 추가와 9/30 완성 기준 일정 반영
    - docs/hw-design.md: 경계 신호, 샘플 단위 비트 폭, 제곱근·나눗셈 없는 비교식,
    버퍼 없는 30초 절반 누산 윈도우, 블록 목록, 검증 흐름, 도구, 20일 일정
    - ml-plan.md: 9/30 전부 완성 기준 명시, AdVitam 외부 검증은 범위에서 제외,
    7단계를 Verilog 구현 포함으로 수정
    - README: hw-design.md 링크, 진행 상황 갱신
2026-09-10 도구 표 갱신: OSS CAD Suite 설치 완료와 한글 경로 대응 실행 조건
    - iverilog·yosys·gtkwave를 C:\oss-cad-suite에 설치하고 시뮬레이션과
    synth_xilinx 합성 리포트까지 동작 확인
    - 사용자 폴더가 한글이라 lib PATH, 임시 폴더 ASCII 경로 설정이 필요함을 기록
    - 확인용 명령과 기대 출력 추가
2026-09-10 도구 표 갱신: Vivado 2026.1 설치와 BASIC 라이선스 설정 기록
    - Vivado 2026.1을 Artix-7만 선택해 설치하고 xc7a35t 배치 합성 확인
    - 2026.1부터 무료 BASIC 티어도 라이선스 파일이 필요함과 발급 절차 기록
    - 기본 라이선스 경로가 한글이라 인식되지 않아 C:\Xilinx로 옮기고
    XILINXD_LICENSE_FILE로 지정한 내용, 배치 실행 예와 run.tcl 추가
2026-09-13 설계 개요와 특징 선정 근거 문서 추가, 9/12~13 결정 사항을 계획서 전반에 반영
    새 문서
    - docs/design-overview.md: 제출용 설계 개요 초안. 팀 문서(04)를 옮기며
    ML 관련 문장을 고침. 특징 4종 고정 → 표준 지표 후보를 조건으로 걸러
    데이터로 선택, 선행 연구 95% 인용 → 문헌고찰의 44~100% 편차와 피험자
    독립 평가 한계 명시, "행동 발현 이전 감지" → "각성도 저하 감지",
    검증 절을 완료/시뮬레이션/미수행 3층으로, PCB 미제작 전제 반영,
    참고문헌 [33]~[36] 추가
    - docs/feature-rationale.md: 특징 후보 15개의 선정 기준(공통성·창 길이·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
2026-09-14 데이터패스 요청서 추가, 9/14 분담·일정 변경 반영
    - docs/datapath-request.md 신설: 하드웨어 팀이 만들 재료 5개(N, ΣRR, ΣRR²,
    Σd, Σd²) 정의와 비트 폭, 5초 블록 누산기 12벌 구조(30초·60초 창 둘 다),
    신호 인터페이스, 피크 검출 규칙 자리(9/15), 날짜별 인계 일정
    - hw-design.md: 분담 변경(피크·RR·누산은 하드웨어 팀, 규칙은 ML), 경계 신호를
    요청서로 위임, 5초 블록 구조, 블록 목록에 담당 열, 검증 벡터 두 종류,
    9/19 완료 기준 일정
    - ml-plan.md: 갱신 주기 5초 결정과 근거, 9/19 완료 기준, 7단계 범위 조정
    - README: 파이프라인 분담 표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
2026-09-14 median NN을 회로 후보에서 제외, 재료 5개로 확정
    하드웨어 팀이 재료 5개 구조로 설계 중이라 나중에 추가 요청하지 않기로 함.
    median은 합계로 만들 수 없고 mean과 정보가 겹치며 표준 권장 지표도 아니다.
    파이썬 비교표에는 남겨 mean 대비 이점만 기록한다. 회로 후보 14개.
2026-09-14 요청서를 하드웨어 담당 관점으로 재구성
    신호 경로 5단계와 분담을 앞에 두고, 언제 뭘 받는지만 표로 남김.
    ML 내부 일정은 hw-design.md로 옮기고 요청서에서는 뺌.
2026-09-15 feat(rr): 단순 봉우리 검출·SQI 규칙 확정, 50명 RR 추출, 채점 파일
    회로로 옮길 수 있게 한 샘플씩 정수 연산으로 짠 검출기. 꺾임 + 적응
    문턱 3/5 + 불응기 96샘플 + 급하강 확인. SQI는 RR 범위와 직전 대비 25%.
    MPD-DF 50명에서 pooled 놓침 1.0%, 오검출 3.2%. 정답(neurokit2)이
    깨진 4명은 elgendi2010으로 대체. 240 Hz 샘플링 RR 오차 2.2 ms.
    하드웨어 팀 채점 파일(sim/vectors)과 테스트벤치 뼈대 포함.
2026-09-15 feat(rr): 하드웨어 아날로그 프론트엔드 대역을 흉내 내서 평가
    준용 회로(AC 결합 0.16 Hz, 저역 16 Hz)를 지난 신호가 실제 입력이므로
    심전도에도 같은 처리를 건 뒤 규칙을 평가하고 채점 파일을 만든다.
    저역은 16이 아니라 40 Hz. 16 Hz는 ECG R파를 깎아 16번 피험자에서
    검출기가 T파에 붙었다(53%). PPG 봉우리는 넓어서 안 생기는 왜곡이라
    "봉우리 성분 대비 여유로운 차단"으로 조건을 맞췄다. 50명 결과는
    놓침 1.0%·오검출 3.2%로 동일. FPGA FIR은 노치만 넣을 예정이라 미반영.
2026-09-15 feat(rtl): 봉우리 검출·SQI·5초 누산 Verilog 참조 구현
    파이썬 설계도를 한 줄씩 옮긴 peak_detect, sqi, window_acc 와 묶음
    rr_frontend. 채점 파일로 02·16·26·47번 네 명 모두 봉우리 위치·RR·
    창 합이 파이썬과 비트 일치. Vivado out-of-context 합성 결과 LUT 852,
    FF 746, DSP 2(RR²·d²), BRAM 0, 12 MHz에서 여유 66 ns. 리포트와 tcl 포함.
    파이썬 5초 블록 경계를 0..1199 카운터 방식으로 맞추고 채점 파일 재생성.
2026-09-17 chore: CLAUDE.md를 git에서 제외
    세션 인계 노트로 쓰는 개인 파일이라 레포에 올리지 않는다.
2026-09-17 docs(ml): 2단계 특징 표 설계서 작성, 기준선 방식 확정
    Summary
    - 특징 표(features_{30,60}s.csv)를 만드는 규칙을 docs/feature-table-design.md에 적음
    - 개인 기준선은 첫 3분 창 특징값 평균, 라벨 무관, 비(차는 비교용). 첫 3분은 판정 보류
    - 정답은 창 길이와 무관하게 해당 에폭 라벨 하나. 60초 창의 라벨 합치기 규칙 삭제
    Changes
    - docs/feature-table-design.md 신규. 행·창·특징 식·파생 특징·유효성·CSV 열·검토 쟁점
    - docs/ml-plan.md 2단계 절을 설계서 요약으로 교체
    - docs/feature-rationale.md 4절에 Vicente 2016, Persson 2021 추가. 9절 기준선 확인 항목 닫음
    Note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
2026-09-17 feat(features): 2단계 특징 표 생성과 사전 확인
    - npz 50명 → WindowAcc 5초 누산 → 30초·60초 창 → 특징 14개(+비교용) → features_{30,60}s.csv
    - 표를 모델에 넣기 전에 계산 검증·사람 안 짝 비교·상관·정답 봉우리 대조를 그림과 표로 확인
    - 문헌 방향 재현: 졸릴 때 mean NN +1.4%(32/45, p 1.5e-5), SDNN +8.7%(39/45), SD2 +11%
    - src/features.py: 재료 5개 → 1차 특징 8개. N 나눔, SD2 음수 절단, SD1/SD2 분모 하한
    - scripts/make_features.py: 행·라벨·기준선(첫 3분 창 평균)·직전 창 대비·유효성. --gt로 정답 봉우리 표
    - scripts/plot_features.py: 히스토그램, 짝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
2026-09-19 feat(ml): 3단계 모델 비교 완료, 로지스틱 특징 1개·창 60초 확정
    - 후보 7종(규칙·얕은 트리·로지스틱·랜덤포레스트·부스팅, 비교선 RBF SVM·MLP는 근거 있는 생략)을
    피험자 50명 한 명씩 빼는 겹친 교차검증으로 같은 채점기에서 비교했다.
    - 같은 헛경보에서 로지스틱 회귀 특징 1개(mean_rb)가 1위. 파라미터 2바이트, 곱셈 1회.
    트리 앙상블은 예산(4 KB)의 2~11배를 쓰고도 더 낮았고, 특징을 늘리거나 개인화를 더해도 낮아졌다.
    - 확정: 창 60초, 동작점 헛경보 4회/h 주·2회/h 보조. 60초 창 4회/h에서 사건 민감도 0.413,
    창 민감도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
2026-09-19 feat(ml): 3단계 기준선을 칩 방식(첫 3분 ΣRR÷N)으로 통일 확인
    - 2단계 표에 mean_rb_chip·base_ok_chip·base_n_chip·base_sum_rr_chip 4열 추가. 기존 34열은 비트 동일
    - src.stage3.run --chip-baseline 으로 로지스틱 60초를 다시 돌려 기존 기준선과 성적이 오차 안에서 같음을 확인
    - scripts/make_features.py: 칩 방식 기준선 열 4개
    - src/stage3/data.py: load_table(win, chip_baseline)
    - src/stage3/run.py: --chip-baseline 플래그
    - docs/model-comparison-design.md: 10절 확인 결과
    Notes
    - 결과 data/processed/stage3/logreg_60s_chipbase/ (git 제외)
    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
2026-09-19 feat(infer): 4단계 정수 판정·정답지와 7단계 판정 Verilog, 시뮬·합성 완료
    - 판정식 mean_rb ≥ T 를 교차 곱셈으로 바꿔 나눗셈 없이 정수화. T_FIX=1086 (소수 10비트, T=1.0605, 50명 헛경보 4회/h 이하 최소 정수)
    - 기준선은 새 신호 없이 12·24·36번째 블록의 60초 창 합 셋을 더해 만든다. N_base<45 면 워밍업 재시작
    - 정답지 50명 × 5초 블록 75,186행 + 경계 사례. 2단계 표와 재료·기준선·mean_rb 전부 일치 확인
    - rtl/classifier.v, rtl/infer_top.v. 테스트벤치 75,382블록 불일치 0, changed 펄스도 일치
    - Vivado xc7a35t: LUT 117, FF 65, DSP 3, BRAM 0, 12 MHz 타이밍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
2026-09-22 feat(infer): ML 블록 출력을 alert 펄스 하나로 정리, UART 인계 절 추가
    - infer_top 출력 drowsy·hold·head_nod·changed 넷을 alert 1클럭 펄스 하나로 바꿈
    - combine 규칙: (판정 갱신 AND 졸림 AND 보류 아님 AND 움직임 과다 아님) OR 떨굼 펄스. IMU 항은 6단계까지 0
    - datapath-request.md ⑧ 절: UART 담당에게 넘기는 인계 메모(펄스마다 바이트 하나, pending 플래그, 경보 반복 규칙 없음)
    - rtl/infer_top.v: alert·ready 포트, combine 한 줄
    - sim/tb_classifier.v: hold·drowsy는 classifier 계층 참조로 대조, alert 펄스 수 = drowsy 확인. 75,382블록 불일치 0
    - sim/reports/infer_to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
2026-09-22 docs(hw): 9/21 회로도 검토 반영, ADC 12비트 진폭 하한 시험 추가
    - 회로도·넷리스트를 설계 가정과 대조. 240 SPS·0 중심·필터 대역·IMU 주소·I2C 공유 전부 일치
    - MCP3421이 240 SPS에서 12비트라 봉우리 검출의 진폭 하한을 50명으로 측정: 봉우리 높이 50코드 이상이면 16비트와 같은 성적(놓침 1.0%, 오검출 3.2%), 10코드에서 깨짐
    - 준용 확인 목록: 보드 35T 여부, 포토다이오드 극성·TIA DC 실측, IMU 풋프린트(QMI8658A 이름), PWRC 극성, PGA 값
    - scripts/quant_test.py: 12비트 재양자화 시험. 결과 data/processed/stage1/quant12.csv (git 제외)
    - docs/datapat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
2026-09-22 docs: 4단계 검토 ④ 곱셈기 그대로 확정, 12비트 포트 변경은 보류로 기록
2026-09-22 feat(rtl): rr_frontend 입력 폭을 보드 ADC에 맞춰 12비트로, 채점 파일 12비트 형식
    - MCP3421이 240 SPS에서 12비트라 참조 RTL 입력 폭을 16→12비트 파라미터(W_SAMPLE, 기본 12)로 바꿨다
    - 채점 파일 in.hex를 12비트 2의 보수(3자리)로 다시 뽑았다. 값은 그대로(±2047 안), 봉우리·RR·창 합 정답 파일은 변화 없음
    - 시뮬 재통과(봉우리 147·RR 146·창 24 불일치 0, 판정 블록 75,382 불일치 0). Vivado LUT 852→801, FF 746→730, DSP 2
    - rtl/rr_frontend.v: 파라미터 W_SAMPLE=12, peak_detect에 전달
    - rtl/peak_detect.v: 기본 W=12
    - sim/tb_rr_frontend.v: 12비트 메모리·입력
    - sc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
2026-09-23 feat(imu): 6단계 고개 떨굼 규칙 imu_rule 구현, infer_top에 준용 끄덕임과 OR 결합
    - 가속도 중력 투영으로 "35° 넘게 숙인 채 0.5 s" 를 잡는 imu_rule 을 만들고, 준용 imu_feature 의
    자이로 끄덕임(o_nod_event, o_nod_sustained)과 함께 infer_top 의 alert 에 OR 로 붙였다.
    - 움직임 과다 보류(m_busy)는 PPG-DaLiA 15명 분석 결과 이득이 작아(판정 뒤집힘 3.2→2.9%) 넣지 않았다.
    준용 SQI 의 모션 게이트가 이미 그 일을 한다.
    - rtl/imu_rule.v: 앞축(Z, 부호 −1)·세로축(Y, 절댓값) IIR(>>>3, 약 2 Hz) → sin35°/cos35° 비교 → 50샘플 연속이면 펄스,
    숙인 채 있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
2026-09-23 chore(sim): tb_imu_rule 주석 줄바꿈 정리
2026-09-23 feat(stage4): 봉우리 검출기를 준용 v14 기준으로 통일하고 T_FIX 1093으로 재계산
    - 학습(문턱 계산)에 쓴 검출기와 칩 검출기가 달라 같은 데이터로 둘을 비교했다. 심전도 50명에서는 비슷하지만 이마 PPG 12시간(WildPPG 2명)에서 우리 peak_detect는 첫 포화 아티팩트 뒤 문턱이 내려오지 않아 하루 종일 죽고(커버리지 0%), 준용 검출기는 커버리지 75~83%로 동작했다. 준용 검출기를 기준으로 삼는다.
    - 준용 rr_extractor의 "탈락 봉우리가 다음 RR 기준점이 되는" 편향(합성 자극 −17.6%)을 찾아 수정을 요청했고 v14에 반영됐다. 수정 후 이마 P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
    [classifier.v, infer_top.v]
2026-09-23 fix(stage4): 학습 RR을 우리 검출기로 되돌리고 T_FIX 1086 원복, 검출기는 신호별 역할 분리
    - PR #16에서 1단계 RR을 준용 v14 검출기 출력으로 바꿔 T_FIX 1093을 잡았는데, 같은 표로 3단계 LOSO를 다시 내니 로지스틱 60초 4회/h 사건 민감도 0.401 → 0.237, 실측 헛경보 4.80/h로 무너졌다.
    - 원인: PPG용 검출기가 ECG의 T파를 봉우리로 잡는 사람이 50명 중 11명(오검출 21~58%). PPG에는 없는 왜곡이라 학습에 넣으면 잡음만 는다. 4단계 pooled 계산은 이걸 가렸다.
    - 결론: 검출기는 신호별로 둔다. 학습·문턱은 ECG에서 검증된 우리 검출기 RR(T_FIX 1086)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
    [classifier.v, infer_top.v]
2026-09-24 feat(stage5): 이마 PPG 전이 검증과 기준선·창 품질 규칙, 새벽배송 타깃 제외
    - WildPPG 15명(흉골 ECG + 이마 PPG 동시 기록)으로 ECG(우리 검출기)와 PPG(준용 v14 검출기)의 칩 방식 mean_rb를 나란히 비교했다. 지금 칩 규칙에서는 사람별 치우침 −11~+4%, 판정 일치 50~97%. 원인은 접촉이 나쁠 때 박동을 많이 버린 기준선·창.
    - 규칙 두 개를 넣었다. 기준선은 좋은 1분 창(박동 30개 이상, 살린 비율 75% 이상) 3개를 모아 완성, 판정도 같은 조건이 아니면 hold. 결과 치우침 −0.1%, 흔들림 1.7%, 판정 일치 97.4%.
    - 학습 쪽 영향 없음: MPD-DF 판정 블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
2026-09-24 docs: 통신 모듈 수정본 확인 결과 반영, 무선 웨이크 저전력 주장 수정
    - 요청서 ⑧절: BLE_WAKE는 항상 High, 통신 모듈 확인(펄스+pending 동작, 검증, 크기) 추가
    - 요청서 ⑨절: PWRC 질문을 JDY-23 매뉴얼로 닫고, PGA·극성 질문은 준용 v9로 닫음
    - 설계 개요: "이벤트 시 웨이크" 저전력 문구를 "칩 안에서 판정, 경보당 1바이트"로 교체
2026-09-24 docs(stage7): bad60 반영 후 infer_top Vivado 재합성, 옛 기준선 규칙·재료 문구 정리
    - infer_top(판정 + IMU 규칙) Vivado 2026.1 재합성: LUT 271 -> 299, FF 107 -> 103, DSP 3, WNS 72.1 ns
    - datapath-request ⑦ 판정식 블록을 9/24 규칙(좋은 1분 창 3개, 탈락 25% 초과 hold)으로 교체
    - 받는 신호를 60초 창 넷(win_valid, n60, sum_rr60, bad60)으로 명시, 재료 5개 문구 정리
    - 벡터 형식(bad60 열), 테스트 블록 수(75,389), iverilog 명령(imu_rule.v 누락) 수정
2026-09-24 docs: 현재와 안 맞는 문서 정리 (README 진행 상황·구조, AdVitam 범위 제외, 검출기 비교 결론)
    - README: 경로 그림·데이터 표·모델 문단·파일 목록·진행 상황을 3~7단계 결과에 맞게 갱신
    - data-notes, ml-plan: AdVitam 외부 검증을 범위에서 뺐고 데이터도 지웠다고 명시, WildPPG 추가
    - hw-design: 완성의 정의 1번을 실제로 한 검증으로, 일정 절에 완료 메모
    - detector-comparison: 맨 위에 최종 결론(7절, 학습은 우리 검출기·칩은 준용 검출기) 요약
2026-09-24 docs: 재료 축소 B안 적용(준용 v16)과 o_bad60 255 포화를 인계서에 기록
2026-09-24 docs: 제출용 정리 (작업 기록·경로·문서 간 참조 제거, 인계서를 인터페이스 명세로 교체)
    - 참조 RTL(peak_detect·sqi·window_acc·rr_frontend)과 딸린 테스트벤치·벡터·합성 리포트·스크립트 삭제
    - datapath-request.md를 interface-spec.md로 새로 작성하고 삭제, hw-design.md는 도구 절을 README로 옮기고 삭제
    - 문서 전체에서 날짜·PR 번호·취소선·번복 경위·팀원 이름·패키지 버전·폴더 경로·문서 간 링크 제거
    - 코드 주석과 보고서 라벨에서 같은 흔적 정리, 동작 변경 없음
2026-09-24 docs: 설계 개요에 WildPPG 이마 PPG 전이 검증 결과 반영
    - 2.3.3과 검증 방법의 ECG-PPG 간극 문장을 WildPPG 결과(판정 일치 97.4%)로 교체, PPG-DaLiA는 운전 중 신호 품질 확인으로 역할 정정
    - 한계 문장을 '이마 미검증'에서 '운전 중 이마 판정 비율 미확인'으로 수정
    - 참고문헌 [37] WildPPG 추가
2026-09-25 feat: 자이로 부호 확정 전 끄덕임을 판정에서 무시
    - infer_top에 i_pitch_sign_ok 입력을 두고 신호처리 블록의 끄덕임(o_nod_event)과 떨군 채 유지(o_nod_sustained 상승 에지)를 부호 확정 뒤에만 alert에 OR한다.
    - rtl/infer_top.v: 입력 추가, m_nod 게이트, 머리 주석
    - sim/tb_classifier.v: 새 입력을 1로 묶음 (벡터 51개 불일치 0 유지)
    - docs/interface-spec.md: 3.2 표에 o_pitch_sign_ok, 62행 근거, 5절 alert 식, o_sum_rr60 상한 14,760으로 정정, 자원 표에 통합 시 값
    - docs/imu-rule-design.md, integer-inference-design.md, ml-plan.md: alert 식과 입력 목록
    - docs/ml-plan.md, stage5-ppg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
2026-09-25 feat: 심박 경보를 30초 간격으로 내고 칩 기준 성능 숫자 정리
    - 판정 하나가 최근 60초를 보므로 5초마다 연달아 나온 판정은 55초가 같은 데이터다. 심박 경보는 첫 졸림 판정에서 바로 내고, 그 뒤 블록 6개(30초, 창의 절반) 동안은 내지 않는다. 졸림이 이어지면 30초마다 다시 낸다.
    - 판정(hold, drowsy)과 판정 지표는 그대로이고 휴대폰이 받는 경보 수만 줄어든다. MPD-DF 50명에서 깨어 있을 때 시간당 139회에서 26회, 피로1 이상일 때 246회에서 45회.
    - src/infer_ref.py: AlertGate (REPEAT_BLOCKS 6)
    - scripts/make_infer_vectors.py: 벡터에 alert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
2026-09-25 docs: 판정 성능 숫자와 실제 울리는 경보 수를 구분해 적기
    - 헛경보 3.94회/h는 모델 비교와 같이 30초 라벨마다 끝 판정 하나로 채점하고 60초 안의 경보를 한 덩어리로 센 값이다. 휴대폰이 받는 경보 수(깨어 있을 때 시간당 26번)와 세는 대상이 달라서, 문서마다 무엇을 셌는지 적었다.
    - README: 결과 표 항목 이름을 판정 성능(처음 보는 사람, 칩 재현)과 실제로 울리는 경보로 나누고, 표 아래에 채점 방식 설명
    - docs/model-comparison-design.md, docs/feature-table-design.md: "5초 판정이면 헛경보가 다를 수 있다"는 메모에 실측으로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
2026-09-25 docs: 문서 통독 정리 (지금 결정과 어긋난 문장, 숫자, 중복, 문서 간 참조)
    - 문서 15개와 README를 처음부터 끝까지 읽고 지금 결정과 어긋나는 문장, 틀린 숫자, 결정이 바뀐 흔적, 여러 곳에 되풀이된 문단, 문서 간 참조를 정리했다.
    - 어긋난 문장: 경보가 판정마다 울린다는 서술, 칩 기준선을 첫 3분으로 적은 곳, 칩에 누산기 다섯 개가 있는 것처럼 읽히던 곳, 판정 재료를 둘로 적은 곳, 정답이 60초 창마다 붙는다는 곳, alert 수를 drowsy 수와 대조한다는 시험 설명, 기준선 전에 판정 펄스가 안 나온다는 문장, 설계 개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
2026-09-26 docs: 설계설명서 절별 초안과 그림 추가
    3.4와 3.5를 판정 블록 하나로 합친 목차(2장, 3.1~3.8)에 맞춰 절마다 파일을
    나눈 초안을 docs/submission/에 둔다. 그림 6장은 docs/figures/에 있다.
    - 2장: 기존 설계 개요를 2.1~2.6으로 재배치. 전용 하드웨어의 근거에서
    전력을 빼고 연산량·결정적 지연·펌웨어 불필요·ASIC 이식성으로 바꿈
    - 3.1, 3.6~3.8: 전체 구조, 칩 전체 시험·구현 결과·종합, 기대 효과, 한계
    - 3.2, 3.3, 3.5: 담당 확정 전 설계 자료로 채운 초안
    - 3.4: 판정 블록(심박 판정, 판정 규칙, 고개 떨굼, 정수 구현과 검증)
    - 그림: 전체 구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
2026-09-26 docs: 설명서 초안을 담당 범위로 정리하고 2장을 절마다 나눔
    - 2장을 2.1 배경 ~ 2.6 차별점 파일 여섯 개로 나눔 (내용 그대로)
    - 팀원 담당 절 초안(3.2 아날로그 프론트엔드, 3.3 신호처리, 3.5 통신)을
    지움. 각 담당이 쓴다
    - README 목차를 새 파일 구성에 맞추고, 3.3 실측 기록 서지 메모를 참고문헌에서 뺌
2026-09-27 docs: 설명서 초안 문서·그림 파일명을 목차 번호로 시작하게 바꿈
    - 문서: 2-1-background.md → 2.1_background.md 식으로 절 번호를 그대로 앞에
    - 그림: 쓰는 절 번호를 앞에 붙임 (3.1_sys_architecture, 3.4.1_infer_top 등)
    - 본문 그림 경로, README 목차·그림표, 그림 생성 스크립트 저장 이름을 새 이름으로
2026-09-28 docs: 작품명을 '이마 PPG·IMU 기반 졸음 감지 SoC'로 정함
    - 1_title.md에 확정한 작품명만 남기고 후보 메모를 뺌
    - 약어를 본문 첫 등장에서 풉니다: PPG(광용적맥파, 2.1), IMU(관성 측정 장치, 2.4)
    - README 미결 목록에서 작품명 항목을 뺌
2026-09-28 docs: 2.1을 개발 배경 및 문제 정의로 재구성
    배경(화물차 졸음, 자율주행 보조가 만드는 공백, 기존 감시 방식의 한계)을
    세 문단으로 줄이고 문제 정의(감지 대상, 대상 사용자, 전제 조건)를 표로 붙임.
    인용은 기존 배경·문제 정의 합계에서 16개로 줄임.
2026-09-28 docs: 2.1을 번호 붙은 소절로 나누고 소절 사이 연결 문장을 둠
    2.1.1 화물차 졸음운전 현황 → 2.1.2 자율주행 보조 도입에 따른 감시 공백 →
    2.1.3 기존 감시 방식의 한계 → 2.1.4 문제 정의. 각 소절 첫 문장이 앞 소절을
    받도록 고침.
2026-09-28 docs: 구조도 SVG 원본을 docs/figures/src/로 옮김
    docs/figures에는 문서에 붙는 PNG만 두고, 구조도 두 장의 원본 SVG는 src/ 아래로.
    README 그림표와 그림 생성 스크립트 설명을 새 위치로 맞춤.
2026-09-28 docs: 참고문헌을 IEEE 형식으로 바꾸고 번호를 본문 등장 순서로 다시 매김
    - references.md: 43개 항목을 IEEE 형식으로 고침. 원문에서 확인한 저자·권호·DOI를 채움
    (Di Milia 2012, Pylkkönen 2015, Nurnaningsih 2025, Li·Chung 2015, Cao 2023, Li 2026,
    Dan 2025 Epilepsia 66(S3), Peyrard 특허, Electrek·Smart Eye 기사 제목·저자 등)
    - 초안 전체(2.1, 2.2, 2.4, 3.4, 3.8)의 인용 번호를 목차 순서 기준 첫 등장 순으로 바꿈.
    아직 인용되지 않은 12개는 [32]~[43]에 둠
2026-09-28 docs: 참고문헌 [5]에 저자·권호·쪽·DOI를 채우고 제목을 원문대로 고침
2026-09-28 docs: 참고문헌 [8]을 로이터 기사에서 원 연구 논문(Mueller 2025)으로 바꿈
2026-09-28 docs: 2.1에 도입 문단을 두고 2.1.1에서 심야 통계를 뺌
    - 2.1 제목 아래 설계의 출발 질문을 밝히는 도입 문단 추가
    - 2.1.1: 주장 문장으로 시작, 기간은 괄호로. [2]의 82%는 원문 분모가 모호해
    "피해의 대부분은 화물차"로 씀. 심야 43%는 학습 데이터(오후 주행)와 출발 시
    각성 전제에 맞지 않아 뺌. 끝 문장을 "졸음은 긴 운행 중에 쌓인다"로
    - 2.1.3: 심야 연결 문장 대신 선글라스 착용 시 시선 감시가 꺼진 사례[11]로 받침
2026-09-28 docs: 2.1 도입 문단 주어를 '본 과제'로, 2.1.2 첫 문장에 '앞서 언급했듯이'를 붙임
2026-09-28 docs: 3장 목차를 신호 흐름 순서로 재구성
    - 3.1 전체 구조 → 시스템 구성(3.1.1~3.1.3 소절 번호 부여)
    - 3.2 아날로그 프론트엔드 → 센서 보드(광학·ADC·IMU·PCB 포함)
    - 3.4.2·3.4.3 소제목을 모델 선정 / 기준선과 판정 규칙으로
    - 3.6 통합 검증 및 구현 결과, 3.6.4 요구 사양 대비 결과 종합
    - 3.7 기대 효과와 3.8 한계를 3.7 결론 및 향후 과제 한 절로 합침(3.7_conclusion.md)
2026-09-28 docs: 2.1 도입 문단과 2.1.1 문장을 다듬고 근거 자료를 바꿈
    - 도입: 첫 문장을 사실 문장으로, "주행보조"를 "자율주행"으로, 단서를 구체적으로, 질문을 따옴표로
    - 2.1.1: 주어를 "졸음운전의 위험"으로. 65%(1월 17명 표본)와 12.8시간(2019년 재인용)을
    한국교통연구원 운행기록 분석(2024, 상위 5% 차량)으로 교체. 52.3%는 원문 조건대로
    - 참고문헌: 문화일보·월간노동법률 삭제, 한국교통연구원 카드뉴스 추가, 전체 42개로 다시 매김
2026-09-28 docs: 2.1 도입 문단을 관점-한계-질문 세 문장으로 다시 씀
2026-09-28 docs: 2.1을 문제 인식 및 정의로 바꾸고 상황-한계-대상 순으로 재구성
    - 2.1 제목: 개발 배경 및 문제 정의 → 문제 인식 및 정의
    - 2.1.1 화물차 졸음운전과 자율주행: 피해 집중(71%·82%)과 자율주행 선도, 레벨 2 감독 공백.
    운전시간·휴게 통계는 목적과 무관하고 고정 기준선의 약점을 부각해 뺌
    - 2.1.2 기존 감시 방식의 한계: 차량 거동 기반과 카메라 두 갈래로 정리, "주행보조"를 "자율주행"으로 통일
    - 2.1.3 대상과 문제 정의: 장거리 화물 운송으로 한정하는 이유를 표 앞에 둠
    - 참고문헌: 한국교통연구원·홍다희 논문은 미인용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
2026-09-28 docs: 2.1.1 레벨 2 문단을 출처 범위로 고치고 자율주행 중 졸음 근거를 추가
    - "상당 기간 레벨 2로 보급된다"(출처는 오히려 2028 무인화 목표)를 "현재로선 레벨 2까지만 상용화"로
    - 역할 변경(조작→감독)을 잇는 문장, 자율주행 감독 중 졸음 증가 근거(Flynn-Evans 2021) 추가
    - NHTSA 사례 표현을 원문대로 "충돌 직전에야 경고"로, 결론을 졸음 여부로
    - 참고문헌 번호 다시 매김
2026-09-28 docs: 참고문헌을 구글 문서 본문 등장 순서로 다시 매기고 팀원 문헌을 합침
    - 구글 문서 본문 기준 [1]-[14] 2장, [15]-[20] 팀원 2.3.1·3.2.1 문헌, [21] Nurnaningsih(3.3.4)
    - 구글 문서 목록은 인용된 21개만 남김. 저장소 목록은 나머지 초안 인용과 미인용 문헌을 뒤에 보관
2026-09-28 docs: 팀원 문헌을 [a]-[f]로 되돌리고 우리 인용만 번호로 매김(Nurnaningsih [15])
2026-09-29 docs: 2.1 도입 문단의 '이러한 흐름 속에서'를 자율주행 상용화로 명시
2026-09-29 docs: 2.1 도입 문단 마지막 문장에 상용화와 질문을 잇는 고리(공백이 커짐)를 넣음
2026-09-29 docs: 2.1.1을 구글 문서 수정본(한 문단, '요구될 수 있으며')에 맞춤
2026-09-29 docs: 2.1.2를 EU 의무화-차량 거동 기반의 무력화-카메라 한계 순으로 고치고 HRV 근거를 심박 간격으로 바로잡음
2026-09-29 docs: 2.1.2·2.1.3을 이야기 흐름으로 잇고 문제 정의 표를 근거 범위로 고침
    - 2.1.2 첫 문장을 "이러한 위험 때문에"로 2.1.1과 잇고, 끝의 목표 선언은 2.1.3 표의 "역할" 줄로 옮김
    - 2.1.3 첫 문단을 앞 두 소절을 요약하는 "정리하면"으로 시작
    - 표: 79.8%는 학습 데이터 분석임을 밝힘, 보급 전제는 뺌(기대 효과로), 전제 조건에 운행 초반 기준선 단계를 넣고
    근거에 없는 "최대 1.8배"를 뺌, 19%는 재인용이라 "조사도 있다"로
2026-09-29 docs: 2.1.2 PPG 문장과 2.1.3 첫 문단을 다듬음
2026-09-29 docs: 2.1.3 첫 문단을 이유(필요성·적합성) 뒤 한정 순서로
2026-09-29 docs: 2.1.3 첫 문장에 앞 소절을 잇는 구절을 되살림
2026-09-29 docs: 2.1.3 첫 문단을 2.1.1·2.1.2의 대비를 정리하는 문장으로
2026-09-29 docs: 2.1 검토 반영 - "행동 지표에 선행" 근거 추가, 표현 반복 정리
    - 2.1.2 "행동 지표에 선행하는 자율신경계 변화"에 Vaussenat 2026(PERCLOS보다 5.8분 선행)·Fujiwara 2019(수면 진입 전 13건 중 12건 검출) 인용
    - "무력해진다" 반복을 "제도의 실효성은 떨어진다"로, "자율주행이 조향을 맡으면" 반복을 "자율주행 중에는"으로
    - "졸음·주시태만"을 "졸음 및 주시태만"으로(양쪽 정렬 간격 문제)
    - 참고문헌 [13][14] 추가, 이후 번호 두 칸씩 밀림
2026-09-29 docs: 설계설명서 초안 파일을 구글 문서 목차에 맞춰 재구성
    - 2.2 문제 정의 + 2.3 설계 기준 → 2.2 설계 목표 및 요구 사양(2.2_requirements.md)
    - 2.4 핵심 설계 결정 → 2.3 핵심 설계 방향(2.3_design_direction.md)
    - 2.5 범위 + 2.6 차별점 → 2.4 구현 범위 및 기술적 차별성(2.4_scope_differentiation.md)
    - 2.1로 옮겨진 문제 정의 문단은 2.2에서 빼고, 보급 경로[18][19]와 출발 시 졸음 통계[16][20]는 3.7로
    - 3.1의 자원 절은 3.6.3과 중복이라 삭제
    - 절 번호 참조와 README 목차 갱신
2026-09-29 docs: 2.2 설계 목표 및 요구 사항 초안
    - 2.2.1: PPG 단독 한계(El Sahmarany 2026) 뒤에 IMU를 보완 채널로 등장시키고 목표 선언
    - 2.2.2: 2.1에서 도출한 요구 R1~R10(감지·구현·검증)과 근거·확인 위치
    - 2.2.3: 하드웨어 담당 요구 진폭 문단과 표 1-1 중 요구 항목을 정량 사양으로 반영
    - 참고문헌 [46] El Sahmarany 2026 추가
2026-09-29 docs: 2.2를 설계 목표 및 기준으로 다듬음
    - 요구 사항을 설계 기준으로 바꾸고 번호를 ①~⑩으로, 파일명 2.2_goals_criteria.md
    - 절 번호 참조를 '앞서' 표현으로, 도입은 '다룬다'로
    - 목표 문장을 한 문장으로 합치고 '범용 프로세서 없이'는 2.3으로 넘김
    - 세 측면 안내 문장을 2.2.2 첫머리로 옮김
2026-09-29 docs: 2.2 설계 기준 정리와 참고문헌 재번호
    - 검증 항목(⑨⑩, 헛경보 조건)을 기준에서 빼고 2.4 구현 범위로
    - ⑥ 근거를 PPG 변화가 작다는 점으로, ⑧ 근거를 설계 목표로
    - 본문·표의 절 번호 참조 제거, 확인 열 삭제, 신호 대역 근거 보강
    - 인용 첫 등장 순서로 재번호: El Sahmarany [17], Nurnaningsih [18], Hejjel [19], Béres [20]
2026-09-29 docs: 2.2 도입 문장 삭제, 기준 ④⑦과 정량 사양 정리
    - 2.2 바로 아래 예고 문장 삭제
    - ④를 방법(개인 기준선)이 아닌 기준(개인차에 영향받지 않는 판정)으로
    - ⑦에서 '입력에서 경보까지의 지연이 정해져 있다' 삭제
    - 정량 사양에서 경보 출력 행 삭제
2026-09-29 docs: 2.2 설계 기준을 설계 결정을 이끈 여섯 개로
    - PPG·IMU 선택에서 끝나는 기준(차량 거동·조명·행동 이전 신호) 삭제
    - 판정 회로 크기 기준 추가
    - 정량 사양의 관련 기준 번호 갱신
2026-09-29 docs: 2.2 설계 기준을 다섯 개로, 기준마다 목표 열 추가
    - 하드웨어(편차 흡수, 침묵 고장 차단)·통신 핵심 설계를 담도록 ①③ 확장
    - 핵심 설계에 대응하지 않는 '연속 판정' 삭제
    - 정량 사양 소절 삭제, 확인 가능한 목표를 기준 표의 열로
    - 판정 성능은 합격선 없이 평가 방식만 명시
    - 참고문헌: 구글 문서 인용 [1]~[18]
2026-09-29 docs: 2.2 기준 표를 명사형으로, 목표를 수치 위주로
    - 표 전체를 문장 대신 명사형으로
    - 목표를 수치 위주로(20 카운트, 누락 0, 100%, 불일치 0 등)
    - 사람 분리 평가는 표 아래 평가 방식 문장으로
2026-09-29 docs: 2.1.3 표를 명사형으로, 2.2.2 평가 방식 문장을 첫 문단으로
    - 2.1.3 문제 정의 표의 문장을 명사형으로 줄임(인용 유지)
    - 2.2.2 표 아래 문장을 첫 문단 끝으로 옮김
2026-09-29 docs: 2.2 기준 ③⑤ 목표 정확히, 끝 문장 삭제
    - ③ 목표를 주입 고장 기준으로
    - ⑤ 목표를 판정 블록 기준(나눗셈기·블록 메모리 0)과 정수화 후 불일치 0으로
    - '다음 절에서는' 문장 삭제
2026-09-29 docs: 2.2 설계 기준 여섯 개로 앞뒤 흐름 연결
    - 실시간 판정 기준 추가(2.1.3 문제 정의의 '현재 상태 실시간 감지'와 연결)
    - 통신 기준을 '경보만 무선 송신'으로, 목표에 BLE 모듈 실물 전달 확인
    - 순서를 앞 절 등장 순으로 정리
2026-09-29 docs: 2.2 기준 표에서 도출 근거 열 삭제
    - 기준이 앞 절에서 나왔다는 점은 첫 문장('앞서 정의한 문제와 설계 목표로부터')으로
2026-09-29 docs: 2.1~2.2 통독 반영, 구글 문서와 동기화
    - 2.1.1·2.1.3 구글 문서에서 바뀐 문장 반영
    - 2.2.1 '메운다' 반복을 '보완한다'로, 주어 '본 과제는' 삭제
    - 2.2.2 첫 문장 간결하게, '사건 단위'를 '졸음 구간 단위'로
2026-09-29 test: 심박 판정 보류 중 고개 떨굼 경보 누락 시험 추가
    - 기준선 완성 전·나쁜 창(탈락 과다, 박동 부족) 보류에서 가속도 떨굼·끄덕임·지속 떨굼 14건 모두 경보(누락 0)
    - 대조: 보류 중 떨굼 없으면 경보 0, 보류 해제 시 심박 경보 1
    - 2.2.2 기준 ③ 목표의 근거
2026-09-29 docs: 2.3 제목을 설계 원칙 및 핵심 설계 결정으로, 새 구성 메모 추가
2026-09-29 docs: 2.3 초안, 두 원칙 아래 결정 여섯 개
2026-09-29 docs: 2.3 도입을 이어질 내용 소개로, 원칙 정의를 소절 첫 문단으로, 전력 문장 삭제
2026-09-29 docs: 참고문헌 번호를 본문 첫 등장 순서로 통합, 팀원 문헌 [a]–[f]를 번호로
2026-09-29 docs: 2.3 첫 문단 수정, 결정별 대가를 3장으로 넘기고 참고문헌 번호 재정리
2026-09-29 docs: 2.3.1 첫 문단을 원칙 정의와 결정 소개로
2026-09-29 docs: 2.3.1 첫 문장을 원칙 내용으로 바로 시작
2026-09-29 docs: 2.3.1·2.3.2 첫 문단을 같은 틀로
2026-09-29 docs: 2.3.1 이마 결정 명시, 편차 흡수 정리, I2C 정지 표현
2026-09-29 docs: 2.3.2를 판정 모델과 연산 방식 두 결정으로, 경보 전달 삭제
2026-09-29 docs: 2.3.2 연산 방식 머리말 복구
2026-09-29 docs: 2.3 표현 정리, 작품명에 쿵쿵딱 확정 반영
2026-09-29 docs: 2.4를 기술적 차별성과 구현 범위로 새로 씀
    2.3 결정을 일반적 구현과 대비한 표, 구현·검증 범위와 경계 두 문단. 구글 문서와 동기화.
2026-09-29 docs: 2.4 차별성 표에서 연산 행 삭제
2026-09-29 docs: 2장 검토 반영(검증 방법에 교차검증, 표 처리 주체 행 삭제, 용어 통일)
2026-09-29 docs: 2.3 수치를 개요 수준으로, 참고문헌 [7][10]을 뉴스 출처로 교체
2026-09-29 docs: 참고문헌 [8]을 EU 규정 원문(2019/2144)으로 교체
2026-09-29 docs: 2.4.2 검증 방법에 아날로그 회로 검증 추가
2026-09-30 docs: 3.1 시스템 구성을 지도 역할로 다시 씀
    - 2.4.2 구현 범위를 받아 네 블록(하드웨어·신호처리·판정·통신)을 정의하고 3장 읽는 순서를 안내
    - 전체 구조도를 블록 수준 가로 그림으로 새로 그림(PPG·IMU 경로 색 구분, 경보 결합 OR, 칩 경계, 본문 폭 451pt 기준 크기)
    - 블록 표·데이터 감소 문단·클럭·핀·비트 폭은 3.1에서 빼고 3.4.1·3.6으로 넘김
2026-09-30 docs: 그림·표 번호를 문서 전체 순번으로(표 1~3, 그림 1)
2026-09-30 docs: 그림 1 화살표가 블록 바탕에 가려지던 문제 수정
2026-09-30 docs: 그림 1 화살촉 크기를 고정하고 끝을 상자 테두리에 맞춤
2026-09-30 docs: 표 캡션을 표 아래로 옮겨 그림과 통일
2026-09-30 docs: 3.4 판정 블록을 새 흐름으로 다시 씀
    - 3.4.1 구조와 판정 기준 ~ 3.4.6 정수 구현과 검증, 옛 J1~J6 기준 틀 제거
    - 이마 PPG 전이는 3.4.2에서 근거와 결과만, 신호 크기 수치는 60초 창 기준(0.9% 대 3.3%)
    - 그림 두 장 새로 그림(3.4.3 신호와 모델, 3.4.4 기준선과 경보 간격), 옛 그림 5장·SVG 삭제
    - 보류 중 고개 떨굼 검증(14/14) 표에 추가
    - 참고문헌: Li & Chung을 미인용으로, 3.7 인용 [33]~[35]를 [32]~[34]로
2026-09-30 docs: 3.4 판정식 기호를 수식 표기로 정리하고 논리식 줄을 문장으로
2026-09-30 docs: 3.4 수식 줄 이스케이프 수정
2026-09-30 docs: 3.4.6 수식 앞뒤 문장 정리
2026-09-30 docs: 3.4 검토 반영(판정 대상 명시, 성능 문단 순서, 불필요 문장 삭제)
2026-09-30 docs: 3.4.5 경보 수를 비율로 표기
2026-09-30 docs: 3.4.1을 개요로 줄이고 평가 절차를 3.4.3에 정확히 기술
2026-09-30 docs: 3.4.1 설계 기준 도입 문장 단순화
2026-09-30 docs: 3.4.1 구조와 설계 기준 문단 다시 씀
2026-09-30 docs: 3.4.1 표현 다듬기
2026-09-30 docs: 3.4.1 사용자 수정 동기화
2026-09-30 docs: 3.4 종결형을 '하였다'로 통일, 3.4.1 표기 정리
2026-09-30 docs: 3.4.2 데이터 선정 이유, 검출기 분리 이유, 전이 논리 보완
2026-09-30 docs: 3.4.2를 선정 기준 → ECG-PPG 연결 → 동시 기록 확인 순서로 재구성
2026-09-30 docs: 3.4.2 선정 기준으로 시작
2026-09-30 docs: 3.4.2 라벨 기준 표현 수정
2026-09-30 docs: 3.4.1에 판정 블록 목적, 3.4.2 기준을 목적에서 도출하고 용어를 각성도 저하로 통일
2026-09-30 docs: 3.4.2에서 전이 원리·검출기 세부를 빼고 질문에 대한 답만 남김
2026-09-30 docs: 3.4.2 맺음 문단 추가
2026-09-30 docs: 3.4.2 정리, PPG-DaLiA 인용을 3.4.4로 옮기고 참고문헌 [25]~[31] 다시 매김
2026-09-30 docs: 3.4.2 맺음을 데이터 확정으로
2026-09-30 docs: 3.4.3 선정 기준에 근거(원칙·문헌) 추가, 판정값 정의, 맺음; 참고문헌 Shoaran·Saeb 추가와 번호 조정
2026-09-30 docs: 표 12에 피로 2단계 이상 구간 민감도 열 추가
2026-09-30 docs: 표 12를 결과 문단 뒤로
2026-09-30 docs: 3.4.3 특징 정의 문장 풀어 씀
2026-09-30 docs: 3.4 창 정의, 특징 정의 문장 다듬기
2026-09-30 docs: 3.4.3 특징 정의를 한 문장으로
2026-09-30 docs: 3.4.3 나열을 가운뎃점으로
2026-09-30 docs: 3.4.3 모델 후보 나열을 가운뎃점으로
2026-09-30 docs: 3.4.3 평가 문단을 과적합 중심으로 다시 씀
2026-09-30 docs: 3.4.3 평가 지표 문단을 따로 세움
2026-09-30 docs: 3.4.3 채점 간격 문장 정리
2026-09-30 docs: 칩 성능을 실제 경보 출력 기준으로(0.406/0.600/4.36), 3.4.3 평가 지표·비교 조건 정리
2026-09-30 docs: 3.4.3 평가 지표 문단 세부 규칙 덜어냄
2026-09-30 docs: 3.4.3 동작점은 비교 후 4회로 정했음을 명시
2026-09-30 docs: 3.4.3 정확도를 쓰지 않은 이유를 수치 해석과 함께
2026-09-30 docs: 3.4.3 정확도 논의를 기존 연구(Lu 2022)에서 출발하게, 수치 해석은 성능 문단으로
2026-09-30 docs: 3.4.3 정확도·동작점 문장 다듬기
2026-09-30 docs: 3.4.3 평가 방법 문단 정제, 동작점 결정 문장을 교차검증 설명 뒤로
2026-09-30 docs: 3.4.3 정보 누수 표현
2026-09-30 docs: 3.4.3 넘기는 문장 삭제
2026-09-30 docs: 3.4.3 결과 문단 받는 말과 용어 정리
2026-09-30 docs: EU 규정 비교를 3.4.6 칩 실제 경보(피로 2단계 이상)로 옮기고 참고문헌 [29]~[32] 다시 매김
2026-09-30 docs: 3.4.3 한계를 심박 간격 정보로, 선행 연구 민감도 범위 추가, 정확도 편차 문장 정리
2026-09-30 docs: 3.4.3 작은 모델이 이긴 이유와 성능 한계의 이유를 나눔
2026-09-30 docs: 3.4.2~3.4.3 반복 표현·수치 정리, 저장소 초안을 구글 문서와 일치
2026-09-30 docs: 3.4.3 이론 상한 문장 다듬기
2026-09-30 docs: 3.4.2 MPD-DF가 ECG임을 먼저
2026-09-30 docs: 3.4.3을 선정 기준·평가 방법과 선정 결과로 나누고 뒤 소절 번호·그림 파일명 조정
2026-09-30 docs: README 그림 이름
2026-09-30 docs: 3.4.5 3.3 연결, 고정 기준선의 대가, 보류 문장 통합
2026-09-30 docs: 3.4.5 문장 정제, 반복·수치 정리
2026-09-30 docs: 3.4.5 좋은 창 근거 문장 통합, 운행 후반 헛경보 수치·대책은 3.7로
2026-09-30 docs: 3.4.5 PPG-DaLiA 오차 문장 삭제, 인용은 판정 비율 문장으로
2026-09-30 docs: 3.4.5 판정 보류 대가를 이마 수치로 줄이고 PPG-DaLiA 인용 삭제, 참고문헌 재번호
2026-09-30 docs: 3.4.5 최종 검토, 문단 연결·용어 통일·출발 시 각성 전제, 입력 포트 문장은 3.4.7로
2026-09-30 docs: 3.4.6 경보 결합 문장을 끝으로, 3.3 받는 말, 임계값 출처 문장 이동, 판정 성능 문장 정리
2026-09-30 docs: 3.4.6 문장 정제, 반복 표현 정리
2026-09-30 docs: 3.4.6 두 결과 OR 문장 정리
2026-09-30 docs: 그림 21을 기준선(3.4.5)과 경보 간격(3.4.6) 두 장으로 분리, 경보 결합에 OR 게이트 명시
2026-09-30 docs: README 그림 수
2026-09-30 docs: LED 전류를 하드웨어 원고 기준(정격 5.6 mA)으로 정정
2026-09-30 docs: 3.4.6 표 13 자이로 칸을 본문과 맞추고 지시어 정리
2026-09-30 docs: 부위 계수 출처 Desgranges를 [22]로 추가하고 이후 참고문헌 번호를 하나씩 밀어 구글 문서와 맞춤
2026-09-30 docs: 3.4.7을 문제, 후보, 선택 순서로 재구성하고 문장 정제, 합성 결과와 기준선 입력을 구현 문단으로, 3.4 정리 문장 추가, 표 15에 PPG-DaLiA 인용([34])
2026-09-30 docs: 3.4.7에 Verilog RTL 설계와 RTL 대 기준 모델 검증을 명시
2026-09-30 docs: 2.4.2와 3.1에 칩 전체를 Verilog RTL로 설계했음을 명시, 3.4.7 첫 문장은 받는 말로
2026-09-30 docs: 3.4.7 판정 간격 표현을 창 길이와 구분
2026-09-30 docs: 3.4.7 EU 비교 단서 문장 간결화
2026-09-30 docs: 3.4 정리 문장을 3.1의 블록 역할 틀로
2026-09-30 docs: 3.4 재검토 반영, 분류기 용어 통일, 누산 문장 정리, 창 길이 결정을 모델 비교 문단으로
2026-09-30 docs: 3.4.1에 판정 규칙을 회로 비용까지 따져 골랐음을 예고
2026-09-30 docs: 3.6 통합 검증 초안, 기준 대비 종합표와 칩 전체 시험·구현 결과
2026-09-30 docs: 3.6.1 'FPGA 구성'을 '컨피규레이션'으로
2026-09-30 docs: 3.6 재검토 반영, 리셋 15클럭, 블록 메모리·실측 재생·판정 블록 비율 표현 정정
2026-09-30 docs: 3.6.2 실측 신호 재생 문단 삭제
2026-09-30 docs: 3.6.2 첫 문장 주어·조사 정리
2026-09-30 docs: 3.6을 구글 문서 원본(통합 검증·구현 결과·기준 종합)으로 동기화
2026-09-30 docs: 3.7 결론 및 향후 과제 초안, 질문에 대한 답·기대 효과·한계 표 하나로 재구성
2026-09-30 docs: 3.7 문장 정제, 결론 두 문단 구성·중복 제거·한계 표 명사형 통일
2026-09-30 docs: 3.7 구글 문서 반영, 참고문헌 목록 [35]·[36] 추가 메모
2026-09-30 docs: 3.7 하드웨어 중심 재구성, 결론을 신호 확보와 판정으로 나누고 한계 표를 블록 순서로
2026-09-30 docs: 3.7 결론을 두 원칙 중심으로 줄이고, 한계와 향후 과제를 회고 문단으로
2026-09-30 docs: 3.7.1 하드웨어 두 결정 중심으로 재작성, 판정은 짧게
2026-09-30 docs: 3.7.1 수치 줄이고 판정 모델 선정의 회로 규모 기준 추가
2026-09-30 docs: 3.7.1 판정 문단에 모델 이름·성능 문장화·통신 한 문장
2026-09-30 docs: 3.7.1 교차 곱셈·시분할 곱셈기 등 하드웨어 연산 방식 명시
2026-09-30 docs: 3.7.2 보급 문단에 공공 지원 근거(차로이탈 기반 장치의 공백, 운행 중 차량) 추가, 구현 문단 중복 정리
2026-09-30 docs: 3.7.2 검토 반영, 받는 말·페달 장치 분류·생체정보 비전송 효과·보급 문장 정리
2026-09-30 docs: 3.7.1 검토 반영, 질문에 답하는 맺음 문단·이론 상한 문장 정정·평소 심박 추가
2026-09-30 docs: 3.7.2 보급 문단 끝을 지원 사업 편입 기대로 맺음
2026-09-30 docs: 3.2.7 PCB 그림 9·10을 한 장(a–e)으로 합침
2026-09-30 docs: 3.7.3 정리, 한계를 회로·판정 문단으로 나누고 주변광 조건·극성 확인 위치 정리, 3.7.1 진폭 표현 조정
2026-09-30 docs: 3.7.3 재구성, 남은 확인·착용 뒤 확정할 것·향후 과제 세 문단, BLE 모듈 위치 정정
2026-09-30 docs: 3.5 성우 답 반영, 파형 그림 22 (a)–(c) 합침, JDY-23 매뉴얼 [35] 추가로 참고문헌·표 번호 재정렬
2026-09-30 docs: 3.7.3 한계 예고 문장·후속 과제 정리·문서 맺음 문단 추가
2026-09-30 docs: 최종 제출 설계설명서 반영, 설명서 초안·전용 그림·대회 양식 삭제
    제출한 최종본에서 1쪽 참가신청서(개인정보)를 뺀 설계설명서 33쪽을
    docs/쿵쿵딱_설계설명서.pdf로 올린다. 제출서류 원본은 로컬에만 두고
    .gitignore로 제외한다. 최종본이 구글 문서와 PDF로 확정되어 절별
    초안 docs/submission/과 설명서 전용 그림 6장, SVG 원본, 대회 양식을 지운다.
2026-10-01 docs: README 작품명을 최종본으로 바꾸고 제출한 설계설명서 위치 추가
2026-10-01 docs: README를 제출한 설계설명서 기준으로 다시 씀
    개요·시스템 블록 구성·판정 블록 설계 요약·결과·한계를 설명서의 용어와
    수치(구간 민감도, 칩 실제 경보 0.406/0.600/4.36, LUT 207)에 맞추고,
    데이터 표의 WildPPG 인원과 PPG-DaLiA 용도를 설명서와 같게 고친다.
